Sajeevanveeriah/Ataxia-Monitor/VW-MTC1/Hardware/Reports/20261019-VW-MTC1-DRC-Report-Rev00.txt

** Drc report for VW-MTC1.kicad_pcb **
** Created on 2026-10-19T11:32:42 **
** Report includes: Errors, Warnings, Exclusions **

** Found 219 DRC violations **
[via_dangling]: Via is not connected or connected on only one layer
    Local override; warning
    @(147.0000 mm, 103.0000 mm): Via [GND] on F.Cu - B.Cu
[isolated_copper]: Isolated copper fill
    Local override; warning
    @(100.3000 mm, 100.3000 mm): Zone 'GND_POUR_TOP' [GND] on F.Cu, priority 0
[isolated_copper]: Isolated copper fill
    Local override; warning
    @(100.3000 mm, 100.3000 mm): Zone 'GND_POUR_TOP' [GND] on F.Cu, priority 0
[isolated_copper]: Isolated copper fill
    Local override; warning
    @(100.3000 mm, 100.3000 mm): Zone 'GND_POUR_TOP' [GND] on F.Cu, priority 0
[isolated_copper]: Isolated copper fill
    Local override; warning
    @(100.3000 mm, 100.3000 mm): Zone 'GND_POUR_TOP' [GND] on F.Cu, priority 0
[isolated_copper]: Isolated copper fill
    Local override; warning
    @(100.3000 mm, 100.3000 mm): Zone 'GND_POUR_BOT' [GND] on B.Cu, priority 0
[silk_edge_clearance]: Silkscreen clipped by board edge
    Rule: board setup constraints silk; warning
    @(188.0000 mm, 160.0000 mm): Segment on Edge.Cuts
    @(127.6000 mm, 159.8200 mm): Segment of SW1 on F.Silkscreen
[silk_edge_clearance]: Silkscreen clipped by board edge
    Rule: board setup constraints silk; warning
    @(188.0000 mm, 160.0000 mm): Segment on Edge.Cuts
    @(127.8000 mm, 160.0300 mm): Segment of SW1 on F.Silkscreen
[silk_edge_clearance]: Silkscreen clipped by board edge
    Rule: board setup constraints silk; warning
    @(188.0000 mm, 160.0000 mm): Segment on Edge.Cuts
    @(128.9000 mm, 159.8200 mm): Segment of SW1 on F.Silkscreen
[silk_edge_clearance]: Silkscreen clipped by board edge
    Rule: board setup constraints silk; warning
    @(100.0000 mm, 158.0000 mm): Segment on Edge.Cuts
    @(100.0000 mm, 124.2000 mm): Reference field of U5
[silk_edge_clearance]: Silkscreen clipped by board edge
    Rule: board setup constraints silk; warning
    @(102.0000 mm, 102.0000 mm): Arc on Edge.Cuts
    @(101.3000 mm, 99.9000 mm): Segment of U5 on F.Silkscreen
[silk_edge_clearance]: Silkscreen clipped by board edge
    Rule: board setup constraints silk; warning
    @(102.0000 mm, 100.0000 mm): Segment on Edge.Cuts
    @(119.7000 mm, 99.9000 mm): Segment of U5 on F.Silkscreen
[silk_edge_clearance]: Silkscreen clipped by board edge
    Rule: board setup constraints silk; warning
    @(102.0000 mm, 100.0000 mm): Segment on Edge.Cuts
    @(139.0000 mm, 100.3500 mm): Reference field of H4
[silk_edge_clearance]: Silkscreen clipped by board edge
    Rule: board setup constraints silk; warning
    @(102.0000 mm, 100.0000 mm): Segment on Edge.Cuts
    @(186.0000 mm, 99.8500 mm): Reference field of H3
[holes_co_located]: Drilled holes co-located
    Local override; warning
    @(147.0000 mm, 103.0000 mm): PTH pad 1 [GND] of J5
    @(147.0000 mm, 103.0000 mm): Via [GND] on F.Cu - B.Cu
[hole_to_hole]: Drilled hole too close to other hole (board setup constraints min 0.2500 mm; actual 0.0000 mm)
    Rule: board setup constraints; warning
    @(108.3300 mm, 136.1500 mm): Via [VBUS_RAW] on F.Cu - B.Cu
    @(108.4100 mm, 136.4000 mm): Via [VBUS_RAW] on F.Cu - B.Cu
[holes_co_located]: Drilled holes co-located
    Local override; warning
    @(147.0000 mm, 103.0000 mm): PTH pad 1 [GND] of J5
    @(147.0000 mm, 103.0000 mm): Via [GND] on F.Cu - B.Cu
[silk_overlap]: Silkscreen clearance
    Rule: board setup constraints silk; warning
    @(180.5200 mm, 106.3000 mm): Reference field of U9
    @(180.2627 mm, 106.5225 mm): Segment of R48 on F.Silkscreen
[silk_overlap]: Silkscreen clearance
    Rule: board setup constraints silk; warning
    @(177.3900 mm, 101.7500 mm): Segment of D7 on F.Silkscreen
    @(176.7500 mm, 103.8200 mm): Reference field of C30
[silk_overlap]: Silkscreen clearance
    Rule: board setup constraints silk; warning
    @(176.7500 mm, 103.8200 mm): Reference field of C30
    @(177.3900 mm, 103.7500 mm): Segment of D7 on F.Silkscreen
[silk_overlap]: Silkscreen clearance
    Rule: board setup constraints silk; warning
    @(178.0127 mm, 112.7725 mm): Segment of R45 on F.Silkscreen
    @(178.7500 mm, 112.8200 mm): Reference field of R35
[silk_overlap]: Silkscreen clearance
    Rule: board setup constraints silk; warning
    @(176.0000 mm, 108.3200 mm): Reference field of C28
    @(174.5127 mm, 108.2725 mm): Segment of R46 on F.Silkscreen
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
[silk_overlap]: Silkscreen clearance
    Rule: board setup constraints silk; warning
    @(150.5100 mm, 140.1406 mm): Segment of C18 on F.Silkscreen
    @(150.5700 mm, 140.0000 mm): Reference field of R27
[silk_overlap]: Silkscreen clearance
    Rule: board setup constraints silk; warning
    @(141.5000 mm, 110.2500 mm): Reference field of SW4
    @(138.2650 mm, 110.4850 mm): Segment of D4 on F.Silkscreen
[silk_overlap]: Silkscreen clearance
    Rule: board setup constraints silk; warning
    @(132.5225 mm, 112.2373 mm): Segment of R21 on F.Silkscreen
    @(132.5700 mm, 112.2500 mm): Reference field of D5
[silk_overlap]: Silkscreen clearance
    Rule: board setup constraints silk; warning
    @(134.5700 mm, 113.0000 mm): Reference field of R19
    @(134.7350 mm, 113.7350 mm): Segment of D5 on F.Silkscreen
[silk_overlap]: Silkscreen clearance
    Rule: board setup constraints silk; warning
    @(134.5700 mm, 113.0000 mm): Reference field of R19
    @(133.2650 mm, 113.7350 mm): Segment of D5 on F.Silkscreen
[silk_overlap]: Silkscreen clearance
    Rule: board setup constraints silk; warning
    @(135.2500 mm, 114.3200 mm): Reference field of D6
    @(134.5700 mm, 113.0000 mm): Reference field of R19
[silk_overlap]: Silkscreen clearance
    Rule: board setup constraints silk; warning
    @(135.2500 mm, 116.3200 mm): Reference field of R22
    @(133.7650 mm, 116.4850 mm): Segment of D6 on F.Silkscreen
[silk_overlap]: Silkscreen clearance
    Rule: board setup constraints silk; warning
    @(160.5127 mm, 112.5225 mm): Segment of R37 on F.Silkscreen
    @(160.2500 mm, 112.5700 mm): Reference field of C19
[silk_overlap]: Silkscreen clearance
    Rule: board setup constraints silk; warning
    @(160.5000 mm, 109.5000 mm): Circle of TP8 on F.Silkscreen
    @(160.7500 mm, 110.5700 mm): Reference field of R37
[silk_overlap]: Silkscreen clearance
    Rule: board setup constraints silk; warning
    @(163.7387 mm, 110.4850 mm): Segment of C20 on F.Silkscreen
    @(164.2500 mm, 110.5700 mm): Reference field of FB1
[silk_overlap]: Silkscreen clearance
    Rule: board setup constraints silk; warning
    @(168.4887 mm, 106.7350 mm): Segment of C23 on F.Silkscreen
    @(167.7500 mm, 107.0700 mm): Reference field of C22
[silk_overlap]: Silkscreen clearance
    Rule: board setup constraints silk; warning
    @(162.5000 mm, 107.3800 mm): Reference field of J6
    @(164.0000 mm, 108.0700 mm): Reference field of C20
[silk_over_copper]: Silkscreen clipped by solder mask
    Local override; warning
    @(180.5200 mm, 106.3000 mm): Reference field of U9
    @(179.6750 mm, 106.0000 mm): Pad 1 [+3V3_H] of R48 on F.Cu
[silk_over_copper]: Silkscreen clipped by solder mask
    Local override; warning
    @(180.5200 mm, 106.3000 mm): Reference field of U9
    @(181.3250 mm, 106.0000 mm): Pad 2 [SCL_H] of R48 on F.Cu
[silk_over_copper]: Silkscreen clipped by solder mask
    Local override; warning
    @(176.7500 mm, 103.8200 mm): Reference field of C30
    @(176.1875 mm, 103.0000 mm): Pad 2 [MOT_P] of F2 on F.Cu
[silk_over_copper]: Silkscreen clipped by solder mask
    Local override; warning
    @(174.7500 mm, 106.3200 mm): Reference field of R46
    @(175.8000 mm, 105.5000 mm): Pad 1 [HALL_SK4] of C30 on F.Cu
[silk_over_copper]: Silkscreen clipped by solder mask
    Local override; warning
    @(178.7500 mm, 112.8200 mm): Reference field of R35
    @(177.4250 mm, 112.2500 mm): Pad 1 [HALL_IN4] of R45 on F.Cu
[silk_over_copper]: Silkscreen clipped by solder mask
    Local override; warning
    @(178.7500 mm, 112.8200 mm): Reference field of R35
    @(179.0750 mm, 112.2500 mm): Pad 2 [HALL_MID4] of R45 on F.Cu
[silk_over_copper]: Silkscreen clipped by solder mask
    Local override; warning
    @(173.5700 mm, 113.2500 mm): Reference field of C24
    @(172.4750 mm, 114.5000 mm): Pad 11 [GND] of U6 on F.Cu
[silk_over_copper]: Silkscreen clipped by solder mask
    Local override; warning
    @(173.5700 mm, 113.2500 mm): Reference field of C24
    @(172.4750 mm, 113.2300 mm): Pad 12 [HALL_SK4] of U6 on F.Cu
[silk_over_copper]: Silkscreen clipped by solder mask
    Local override; warning
    @(173.5700 mm, 117.0000 mm): Reference field of R42
    @(172.4750 mm, 115.7700 mm): Pad 10 [HALL_SK3] of U6 on F.Cu
[silk_over_copper]: Silkscreen clipped by solder mask
    Local override; warning
    @(176.0000 mm, 108.3200 mm): Reference field of C28
    @(175.5750 mm, 107.7500 mm): Pad 2 [HALL_SK4] of R46 on F.Cu
[silk_over_copper]: Silkscreen clipped by solder mask
    Local override; warning
    @(174.7500 mm, 106.3200 mm): Reference field of R46
    @(173.7000 mm, 105.5000 mm): Pad 2 [HALL_F4] of C29 on F.Cu
[silk_over_copper]: Silkscreen clipped by solder mask
    Local override; warning
    @(178.2500 mm, 110.8200 mm): Reference field of R45
    @(176.9500 mm, 110.0000 mm): Pad 2 [GND] of C28 on F.Cu
[silk_over_copper]: Silkscreen clipped by solder mask
    Local override; warning
    @(180.0700 mm, 112.7500 mm): Reference field of R47
    @(179.5750 mm, 114.2500 mm): Pad 2 [GND] of R35 on F.Cu
[silk_over_copper]: Silkscreen clipped by solder mask
    Local override; warning
    @(179.8183 mm, 114.5000 mm): Reference field of U8
    @(179.5750 mm, 114.2500 mm): Pad 2 [GND] of R35 on F.Cu
[silk_over_copper]: Silkscreen clipped by solder mask
    Local override; warning
    @(173.5700 mm, 125.7500 mm): Reference field of C31
    @(172.4750 mm, 126.9600 mm): Pad 13 [+3V3_H] of U7 on F.Cu
[silk_over_copper]: Silkscreen clipped by solder mask
    Local override; warning
    @(173.5700 mm, 125.7500 mm): Reference field of C31
    @(172.4750 mm, 125.6900 mm): Pad 14 [+3V3] of U7 on F.Cu
[silk_over_copper]: Silkscreen clipped by solder mask
    Local override; warning
    @(181.0000 mm, 126.8200 mm): Reference field of R50
    @(179.8000 mm, 125.9375 mm): Pad 1 [HAPTIC_G] of Q3 on F.Cu
[silk_over_copper]: Silkscreen clipped by solder mask
    Local override; warning
    @(172.2500 mm, 119.0700 mm): Reference field of R40
    @(172.4750 mm, 118.3100 mm): Pad 8 [HALL_F3] of U6 on F.Cu
[silk_over_copper]: Silkscreen clipped by solder mask
    Local override; warning
    @(173.5000 mm, 121.0700 mm): Reference field of C27
    @(173.0750 mm, 120.5000 mm): Pad 2 [HALL_SK2] of R40 on F.Cu
[silk_over_copper]: Silkscreen clipped by solder mask
    Local override; warning
    @(186.7500 mm, 125.3200 mm): Reference field of C33
    @(187.5500 mm, 124.4750 mm): Pad MP [GND] of J3 on F.Cu
[silk_over_copper]: Silkscreen clipped by solder mask
    Local override; warning
    @(181.0000 mm, 126.8200 mm): Reference field of R50
    @(181.7000 mm, 125.9375 mm): Pad 2 [GND] of Q3 on F.Cu
[silk_over_copper]: Silkscreen clipped by solder mask
    Local override; warning
    @(175.7500 mm, 127.0700 mm): Reference field of C32
    @(175.0000 mm, 126.5250 mm): Pad 1 [+3V3] of C31 on F.Cu
[silk_over_copper]: Silkscreen clipped by solder mask
    Local override; warning
    @(178.3500 mm, 125.0000 mm): Reference field of Q3
    @(177.7500 mm, 124.9250 mm): Pad 2 [HAPTIC_G] of R49 on F.Cu
[silk_over_copper]: Silkscreen clipped by solder mask
    Local override; warning
    @(175.7500 mm, 118.5700 mm): Reference field of R43
    @(175.0000 mm, 117.8250 mm): Pad 1 [HALL_IN3] of R42 on F.Cu
[silk_over_copper]: Silkscreen clipped by solder mask
    Local override; warning
    @(173.5700 mm, 117.0000 mm): Reference field of R42
    @(172.4750 mm, 118.3100 mm): Pad 8 [HALL_F3] of U6 on F.Cu
[silk_over_copper]: Silkscreen clipped by solder mask
    Local override; warning
    @(173.5700 mm, 117.0000 mm): Reference field of R42
    @(172.4750 mm, 117.0400 mm): Pad 9 [HALL_F3] of U6 on F.Cu
[silk_over_copper]: Silkscreen clipped by solder mask
    Local override; warning
    @(180.5000 mm, 118.3200 mm): Reference field of R41
    @(179.4150 mm, 118.0000 mm): Pad 5 [HALL_IN4] of U8 on F.Cu
[silk_over_copper]: Silkscreen clipped by solder mask
    Local override; warning
    @(180.5000 mm, 118.3200 mm): Reference field of R41
    @(180.1850 mm, 118.0000 mm): Pad 6 [unconnected-(U8-NC-Pad6)] of U8 on F.Cu
[silk_over_copper]: Silkscreen clipped by solder mask
    Local override; warning
    @(180.2500 mm, 120.3200 mm): Reference field of R44
    @(179.6750 mm, 119.7500 mm): Pad 1 [HALL_IN3] of R41 on F.Cu
[silk_over_copper]: Silkscreen clipped by solder mask
    Local override; warning
    @(180.2500 mm, 120.3200 mm): Reference field of R44
    @(181.3250 mm, 119.7500 mm): Pad 2 [GND] of R41 on F.Cu
[silk_over_copper]: Silkscreen clipped by solder mask
    Local override; warning
    @(116.0000 mm, 126.3520 mm): Reference field of TP1
    @(114.9450 mm, 125.3000 mm): Pad 24 [LED_GRN] of U5 on F.Cu
[silk_over_copper]: Silkscreen clipped by solder mask
    Local override; warning
    @(116.0000 mm, 126.3520 mm): Reference field of TP1
    @(116.2150 mm, 125.3000 mm): Pad 25 [LED_RED] of U5 on F.Cu
[silk_over_copper]: Silkscreen clipped by solder mask
    Local override; warning
    @(120.0700 mm, 112.5000 mm): Reference field of R17
    @(119.2500 mm, 113.8900 mm): Pad 35 [TOUCH_START] of U5 on F.Cu
[silk_over_copper]: Silkscreen clipped by solder mask
    Local override; warning
    @(120.0700 mm, 112.5000 mm): Reference field of R17
    @(119.2500 mm, 112.6200 mm): Pad 36 [CHRG_N] of U5 on F.Cu
[silk_over_copper]: Silkscreen clipped by solder mask
    Local override; warning
    @(120.0700 mm, 112.5000 mm): Reference field of R17
    @(119.2500 mm, 111.3500 mm): Pad 37 [LED_AMB] of U5 on F.Cu
[silk_over_copper]: Silkscreen clipped by solder mask
    Local override; warning
    @(124.0000 mm, 112.6020 mm): Reference field of TP6
    @(123.4250 mm, 111.7500 mm): Pad 1 [VBAT_SENSE] of R24 on F.Cu
[silk_over_copper]: Silkscreen clipped by solder mask
    Local override; warning
    @(120.0700 mm, 116.0000 mm): Reference field of C13
    @(119.2500 mm, 116.4300 mm): Pad 33 [SD_D0] of U5 on F.Cu
[silk_over_copper]: Silkscreen clipped by solder mask
    Local override; warning
    @(120.0700 mm, 116.0000 mm): Reference field of C13
    @(119.2500 mm, 115.1600 mm): Pad 34 [TOUCH_WIRE] of U5 on F.Cu
[silk_over_copper]: Silkscreen clipped by solder mask
    Local override; warning
    @(124.0000 mm, 112.6020 mm): Reference field of TP6
    @(125.0750 mm, 111.7500 mm): Pad 2 [GND] of R24 on F.Cu
[silk_over_copper]: Silkscreen clipped by solder mask
    Local override; warning
    @(118.2500 mm, 137.5700 mm): Reference field of R8
    @(117.3625 mm, 136.9500 mm): Pad 2 [VSYS] of Q1 on F.Cu
[silk_over_copper]: Silkscreen clipped by solder mask
    Local override; warning
    @(122.3200 mm, 136.7500 mm): Reference field of R15
    @(121.5000 mm, 135.8250 mm): Pad 1 [VBUS_SENSE] of R9 on F.Cu
[silk_over_copper]: Silkscreen clipped by solder mask
    Local override; warning
    @(130.7500 mm, 133.0700 mm): Reference field of R12
    @(130.4750 mm, 132.5000 mm): Pad 1 [BB_FB] of C10 on F.Cu
[silk_over_copper]: Silkscreen clipped by solder mask
    Local override; warning
    @(130.7500 mm, 133.0700 mm): Reference field of R12
    @(132.0250 mm, 132.5000 mm): Pad 2 [BB_CMP] of C10 on F.Cu
[silk_over_copper]: Silkscreen clipped by solder mask
    Local override; warning
    @(126.5700 mm, 135.7500 mm): Reference field of R11
    @(125.7500 mm, 136.5250 mm): Pad 1 [BB_FF] of C9 on F.Cu
[silk_over_copper]: Silkscreen clipped by solder mask
    Local override; warning
    @(124.3200 mm, 135.7500 mm): Reference field of C9
    @(123.7500 mm, 135.9250 mm): Pad 2 [GND] of R15 on F.Cu
[silk_over_copper]: Silkscreen clipped by solder mask
    Local override; warning
    @(126.5700 mm, 135.7500 mm): Reference field of R11
    @(125.7500 mm, 134.9750 mm): Pad 2 [BB_FB] of C9 on F.Cu
[silk_over_copper]: Silkscreen clipped by solder mask
    Local override; warning
    @(130.7500 mm, 135.0700 mm): Reference field of C5
    @(131.5750 mm, 134.5000 mm): Pad 2 [GND] of R12 on F.Cu
[silk_over_copper]: Silkscreen clipped by solder mask
    Local override; warning
    @(130.7500 mm, 135.0700 mm): Reference field of C5
    @(129.9250 mm, 134.5000 mm): Pad 1 [BB_FB] of R12 on F.Cu
[silk_over_copper]: Silkscreen clipped by solder mask
    Local override; warning
    @(132.0700 mm, 141.0000 mm): Reference field of C4
    @(131.1500 mm, 141.6250 mm): Pad 7 [+3V3] of U4 on F.Cu
[silk_over_copper]: Silkscreen clipped by solder mask
    Local override; warning
    @(126.2000 mm, 141.0000 mm): Reference field of L1
    @(126.8500 mm, 140.3250 mm): Pad 4 [BB_SW1] of U4 on F.Cu
[silk_over_copper]: Silkscreen clipped by solder mask
    Local override; warning
    @(126.2000 mm, 141.0000 mm): Reference field of L1
    @(126.8500 mm, 140.9750 mm): Pad 5 [GND] of U4 on F.Cu
[silk_over_copper]: Silkscreen clipped by solder mask
    Local override; warning
    @(132.0700 mm, 141.0000 mm): Reference field of C4
    @(131.1500 mm, 140.9750 mm): Pad 8 [VSYS] of U4 on F.Cu
[silk_over_copper]: Silkscreen clipped by solder mask
    Local override; warning
    @(134.5700 mm, 141.2500 mm): Reference field of C8
    @(133.7500 mm, 141.9500 mm): Pad 1 [VSYS] of C4 on F.Cu
[silk_over_copper]: Silkscreen clipped by solder mask
    Local override; warning
    @(122.5700 mm, 108.7500 mm): Reference field of R23
    @(121.7500 mm, 107.8000 mm): Pad 2 [GND] of C11 on F.Cu
[silk_over_copper]: Silkscreen clipped by solder mask
    Local override; warning
    @(124.5700 mm, 108.7500 mm): Reference field of C14
    @(124.0000 mm, 109.5750 mm): Pad 1 [VBAT] of R23 on F.Cu
[silk_over_copper]: Silkscreen clipped by solder mask
    Local override; warning
    @(124.5700 mm, 108.7500 mm): Reference field of C14
    @(124.0000 mm, 107.9250 mm): Pad 2 [VBAT_SENSE] of R23 on F.Cu
[silk_over_copper]: Silkscreen clipped by solder mask
    Local override; warning
    @(122.5700 mm, 108.7500 mm): Reference field of R23
    @(121.7500 mm, 109.7000 mm): Pad 1 [+3V3] of C11 on F.Cu
[silk_over_copper]: Silkscreen clipped by solder mask
    Local override; warning
    @(124.2500 mm, 110.3200 mm): Reference field of R24
    @(124.0000 mm, 109.5750 mm): Pad 1 [VBAT] of R23 on F.Cu
[silk_over_copper]: Silkscreen clipped by solder mask
    Local override; warning
    @(120.0700 mm, 108.7500 mm): Reference field of C11
    @(119.2500 mm, 110.0800 mm): Pad 38 [VBUS_SENSE] of U5 on F.Cu
[silk_over_copper]: Silkscreen clipped by solder mask
    Local override; warning
    @(120.0700 mm, 108.7500 mm): Reference field of C11
    @(119.2500 mm, 108.8100 mm): Pad 39 [VBAT_SENSE] of U5 on F.Cu
[silk_over_copper]: Silkscreen clipped by solder mask
    Local override; warning
    @(120.0700 mm, 108.7500 mm): Reference field of C11
    @(119.2500 mm, 107.5400 mm): Pad 40 [GND] of U5 on F.Cu
[silk_over_copper]: Silkscreen clipped by solder mask
    Local override; warning
    @(168.7500 mm, 119.0700 mm): Reference field of C21
    @(167.5250 mm, 118.3100 mm): Pad 7 [HALL_F2] of U6 on F.Cu
[silk_over_copper]: Silkscreen clipped by solder mask
    Local override; warning
    @(165.2500 mm, 119.0700 mm): Reference field of R39
    @(165.0750 mm, 118.5000 mm): Pad 2 [HALL_GATE] of R34 on F.Cu
[silk_over_copper]: Silkscreen clipped by solder mask
    Local override; warning
    @(164.5000 mm, 121.0700 mm): Reference field of C26
    @(164.4250 mm, 120.5000 mm): Pad 1 [HALL_IN2] of R39 on F.Cu
[silk_over_copper]: Silkscreen clipped by solder mask
    Local override; warning
    @(172.5000 mm, 137.0700 mm): Reference field of R54
    @(172.2750 mm, 136.5000 mm): Pad 2 [GND] of C37 on F.Cu
[silk_over_copper]: Silkscreen clipped by solder mask
    Local override; warning
    @(174.2500 mm, 142.5700 mm): Reference field of C35
    @(174.5000 mm, 142.0750 mm): Pad 1 [MAZE_START] of R53 on F.Cu
[silk_over_copper]: Silkscreen clipped by solder mask
    Local override; warning
    @(167.0000 mm, 142.5700 mm): Reference field of R55
    @(167.5000 mm, 142.0750 mm): Pad 1 [+3V3] of R52 on F.Cu
[silk_over_copper]: Silkscreen clipped by solder mask
    Local override; warning
    @(167.0000 mm, 142.5700 mm): Reference field of R55
    @(165.5000 mm, 142.0750 mm): Pad 1 [+3V3] of R56 on F.Cu
[silk_over_copper]: Silkscreen clipped by solder mask
    Local override; warning
    @(166.0700 mm, 141.2500 mm): Reference field of R52
    @(165.5000 mm, 142.0750 mm): Pad 1 [+3V3] of R56 on F.Cu
[silk_over_copper]: Silkscreen clipped by solder mask
    Local override; warning
    @(166.0700 mm, 141.2500 mm): Reference field of R52
    @(165.5000 mm, 140.4250 mm): Pad 2 [TCH_FIN] of R56 on F.Cu
[silk_over_copper]: Silkscreen clipped by solder mask
    Local override; warning
    @(170.5000 mm, 144.0700 mm): Reference field of C36
    @(169.7250 mm, 143.5000 mm): Pad 1 [TCH_WIRE] of C34 on F.Cu
[silk_over_copper]: Silkscreen clipped by solder mask
    Local override; warning
    @(170.5000 mm, 144.0700 mm): Reference field of C36
    @(171.2750 mm, 143.5000 mm): Pad 2 [GND] of C34 on F.Cu
[silk_over_copper]: Silkscreen clipped by solder mask
    Local override; warning
    @(173.0700 mm, 141.2500 mm): Reference field of R53
    @(172.4000 mm, 140.2500 mm): Pad 8 [+3V3] of U11 on F.Cu
[silk_over_copper]: Silkscreen clipped by solder mask
    Local override; warning
    @(173.0700 mm, 141.2500 mm): Reference field of R53
    @(172.4000 mm, 141.7500 mm): Pad 5 [TOUCH_FINISH] of U11 on F.Cu
[silk_over_copper]: Silkscreen clipped by solder mask
    Local override; warning
    @(173.0700 mm, 141.2500 mm): Reference field of R53
    @(172.4000 mm, 141.2500 mm): Pad 6 [TCH_START] of U11 on F.Cu
[silk_over_copper]: Silkscreen clipped by solder mask
    Local override; warning
    @(173.0700 mm, 141.2500 mm): Reference field of R53
    @(172.4000 mm, 140.7500 mm): Pad 7 [TOUCH_WIRE] of U11 on F.Cu
[silk_over_copper]: Silkscreen clipped by solder mask
    Local override; warning
    @(171.0000 mm, 139.0500 mm): Reference field of U11
    @(169.8250 mm, 138.5000 mm): Pad 2 [TCH_WIRE] of R51 on F.Cu
[silk_over_copper]: Silkscreen clipped by solder mask
    Local override; warning
    @(171.0000 mm, 139.0500 mm): Reference field of U11
    @(171.6750 mm, 138.5000 mm): Pad 1 [+3V3] of R54 on F.Cu
[silk_over_copper]: Silkscreen clipped by solder mask
    Local override; warning
    @(170.5000 mm, 142.0700 mm): Reference field of C34
    @(169.6000 mm, 141.7500 mm): Pad 4 [GND] of U11 on F.Cu
[silk_over_copper]: Silkscreen clipped by solder mask
    Local override; warning
    @(134.2500 mm, 145.3520 mm): Reference field of TP2
    @(133.5500 mm, 144.2500 mm): Pad 1 [+3V3] of C6 on F.Cu
[silk_over_copper]: Silkscreen clipped by solder mask
    Local override; warning
    @(134.2500 mm, 145.3520 mm): Reference field of TP2
    @(135.4500 mm, 144.2500 mm): Pad 2 [GND] of C6 on F.Cu
[silk_over_copper]: Silkscreen clipped by solder mask
    Local override; warning
    @(132.0700 mm, 141.0000 mm): Reference field of C4
    @(131.1500 mm, 140.3250 mm): Pad 9 [VSYS] of U4 on F.Cu
[silk_over_copper]: Silkscreen clipped by solder mask
    Local override; warning
    @(130.0000 mm, 142.1500 mm): Reference field of C39
    @(131.1500 mm, 141.6250 mm): Pad 7 [+3V3] of U4 on F.Cu
[silk_over_copper]: Silkscreen clipped by solder mask
    Local override; warning
    @(134.5000 mm, 142.5700 mm): Reference field of C6
    @(133.7500 mm, 141.9500 mm): Pad 1 [VSYS] of C4 on F.Cu
[silk_over_copper]: Silkscreen clipped by solder mask
    Local override; warning
    @(120.8200 mm, 146.0000 mm): Reference field of C2
    @(120.1375 mm, 145.9500 mm): Pad 4 [VBUS] of U3 on F.Cu
[silk_over_copper]: Silkscreen clipped by solder mask
    Local override; warning
    @(114.3200 mm, 142.5000 mm): Reference field of D2
    @(113.7500 mm, 143.4250 mm): Pad 2 [LED_CHG_A] of R6 on F.Cu
[silk_over_copper]: Silkscreen clipped by solder mask
    Local override; warning
    @(119.0000 mm, 142.6000 mm): Reference field of U3
    @(119.3250 mm, 142.0000 mm): Pad 2 [GND] of R4 on F.Cu
[silk_over_copper]: Silkscreen clipped by solder mask
    Local override; warning
    @(114.3200 mm, 146.0000 mm): Reference field of R5
    @(113.7500 mm, 145.0750 mm): Pad 1 [+3V3] of R6 on F.Cu
[silk_over_copper]: Silkscreen clipped by solder mask
    Local override; warning
    @(126.2000 mm, 141.0000 mm): Reference field of L1
    @(126.8500 mm, 141.6250 mm): Pad 6 [BB_SW2] of U4 on F.Cu
[silk_over_copper]: Silkscreen clipped by solder mask
    Local override; warning
    @(125.7500 mm, 143.0700 mm): Reference field of R16
    @(123.2000 mm, 142.1850 mm): Pad 2 [BB_SW2] of L1 on F.Cu
[silk_over_copper]: Silkscreen clipped by solder mask
    Local override; warning
    @(122.8200 mm, 147.2500 mm): Reference field of R3
    @(122.2500 mm, 146.7750 mm): Pad 1 [VBUS] of C2 on F.Cu
[silk_over_copper]: Silkscreen clipped by solder mask
    Local override; warning
    @(129.0000 mm, 153.6000 mm): Reference field of SW1
    @(128.9250 mm, 153.0000 mm): Pad 1 [EN_3V3] of R10 on F.Cu
[silk_over_copper]: Silkscreen clipped by solder mask
    Local override; warning
    @(121.0000 mm, 149.8200 mm): Reference field of C1
    @(120.0500 mm, 149.0000 mm): Pad 1 [VBAT_C] of C3 on F.Cu
[silk_over_copper]: Silkscreen clipped by solder mask
    Local override; warning
    @(121.0000 mm, 149.8200 mm): Reference field of C1
    @(121.9500 mm, 149.0000 mm): Pad 2 [GND] of C3 on F.Cu
[silk_over_copper]: Silkscreen clipped by solder mask
    Local override; warning
    @(152.5700 mm, 140.0000 mm): Reference field of R30
    @(152.0000 mm, 140.8250 mm): Pad 1 [+3V3] of R27 on F.Cu
[silk_over_copper]: Silkscreen clipped by solder mask
    Local override; warning
    @(150.5700 mm, 140.0000 mm): Reference field of R27
    @(150.0000 mm, 140.7750 mm): Pad 1 [+3V3] of C18 on F.Cu
[silk_over_copper]: Silkscreen clipped by solder mask
    Local override; warning
    @(152.5700 mm, 140.0000 mm): Reference field of R30
    @(152.0000 mm, 139.1750 mm): Pad 2 [SD_CMD] of R27 on F.Cu
[silk_over_copper]: Silkscreen clipped by solder mask
    Local override; warning
    @(106.0000 mm, 139.0700 mm): Reference field of R2
    @(106.8050 mm, 138.3200 mm): PTH pad SH [GND] of J1
[silk_over_copper]: Silkscreen clipped by solder mask
    Local override; warning
    @(111.0000 mm, 131.5000 mm): Reference field of D1
    @(110.2500 mm, 130.9000 mm): Pad 1 [VBUS_RAW] of F1 on F.Cu
[silk_over_copper]: Silkscreen clipped by solder mask
    Local override; warning
    @(129.0000 mm, 137.0300 mm): Reference field of U4
    @(128.0000 mm, 136.5750 mm): Pad 1 [+3V3] of R11 on F.Cu
[silk_over_copper]: Silkscreen clipped by solder mask
    Local override; warning
    @(129.0000 mm, 137.0300 mm): Reference field of U4
    @(129.9750 mm, 136.5000 mm): Pad 1 [VSYS] of C5 on F.Cu
[silk_over_copper]: Silkscreen clipped by solder mask
    Local override; warning
    @(104.2500 mm, 126.0700 mm): Reference field of C12
    @(103.5150 mm, 125.3000 mm): Pad 15 [BTN_START] of U5 on F.Cu
[silk_over_copper]: Silkscreen clipped by solder mask
    Local override; warning
    @(104.2500 mm, 126.0700 mm): Reference field of C12
    @(104.7850 mm, 125.3000 mm): Pad 16 [HAPTIC_PWM] of U5 on F.Cu
[silk_over_copper]: Silkscreen clipped by solder mask
    Local override; warning
    @(145.0000 mm, 127.8000 mm): Reference field of U12
    @(145.0750 mm, 127.2500 mm): Pad 2 [SDA] of R25 on F.Cu
[silk_over_copper]: Silkscreen clipped by solder mask
    Local override; warning
    @(146.5700 mm, 129.0000 mm): Reference field of R26
    @(146.1625 mm, 129.7500 mm): Pad 10 [unconnected-(U12-OCS_AUX-Pad10)] of U12 on F.Cu
[silk_over_copper]: Silkscreen clipped by solder mask
    Local override; warning
    @(146.5700 mm, 129.0000 mm): Reference field of R26
    @(146.1625 mm, 129.2500 mm): Pad 11 [unconnected-(U12-SDO_AUX-Pad11)] of U12 on F.Cu
[silk_over_copper]: Silkscreen clipped by solder mask
    Local override; warning
    @(146.7500 mm, 131.3200 mm): Reference field of C15
    @(146.1625 mm, 130.7500 mm): Pad 8 [+3V3] of U12 on F.Cu
[silk_over_copper]: Silkscreen clipped by solder mask
    Local override; warning
    @(134.2500 mm, 134.0700 mm): Reference field of R13
    @(133.9250 mm, 133.5000 mm): Pad 1 [BB_CMP] of R14 on F.Cu
[silk_over_copper]: Silkscreen clipped by solder mask
    Local override; warning
    @(134.2500 mm, 134.0700 mm): Reference field of R13
    @(135.5750 mm, 133.5000 mm): Pad 2 [BB_VC] of R14 on F.Cu
[silk_over_copper]: Silkscreen clipped by solder mask
    Local override; warning
    @(134.5000 mm, 136.0700 mm): Reference field of C7
    @(135.0750 mm, 135.5000 mm): Pad 2 [BB_FF] of R13 on F.Cu
[silk_over_copper]: Silkscreen clipped by solder mask
    Local override; warning
    @(148.5700 mm, 140.0000 mm): Reference field of C18
    @(147.9500 mm, 140.5000 mm): Pad 2 [GND] of C17 on F.Cu
[silk_over_copper]: Silkscreen clipped by solder mask
    Local override; warning
    @(147.9250 mm, 141.2750 mm): Reference field of J7
    @(147.9500 mm, 140.5000 mm): Pad 2 [GND] of C17 on F.Cu
[silk_over_copper]: Silkscreen clipped by solder mask
    Local override; warning
    @(147.0000 mm, 138.8200 mm): Reference field of C17
    @(146.1750 mm, 138.2500 mm): Pad 1 [+3V3] of R31 on F.Cu
[silk_over_copper]: Silkscreen clipped by solder mask
    Local override; warning
    @(147.0000 mm, 138.8200 mm): Reference field of C17
    @(147.8250 mm, 138.2500 mm): Pad 2 [SD_D3] of R31 on F.Cu
[silk_over_copper]: Silkscreen clipped by solder mask
    Local override; warning
    @(150.5700 mm, 140.0000 mm): Reference field of R27
    @(150.0000 mm, 139.2250 mm): Pad 2 [GND] of C18 on F.Cu
[silk_over_copper]: Silkscreen clipped by solder mask
    Local override; warning
    @(141.5000 mm, 110.2500 mm): Reference field of SW4
    @(140.5375 mm, 109.7500 mm): Pad 2 [LED_GRN_A] of D4 on F.Cu
[silk_over_copper]: Silkscreen clipped by solder mask
    Local override; warning
    @(141.5000 mm, 110.2500 mm): Reference field of SW4
    @(142.4250 mm, 109.7500 mm): Pad 1 [LED_GRN] of R20 on F.Cu
[silk_over_copper]: Silkscreen clipped by solder mask
    Local override; warning
    @(135.2500 mm, 114.3200 mm): Reference field of D6
    @(136.0000 mm, 113.8250 mm): Pad 1 [+3V3] of R19 on F.Cu
[silk_over_copper]: Silkscreen clipped by solder mask
    Local override; warning
    @(132.5700 mm, 112.2500 mm): Reference field of D5
    @(132.0000 mm, 112.8250 mm): Pad 1 [LED_RED] of R21 on F.Cu
[silk_over_copper]: Silkscreen clipped by solder mask
    Local override; warning
    @(134.5700 mm, 113.0000 mm): Reference field of R19
    @(134.0000 mm, 113.0375 mm): Pad 1 [GND] of D5 on F.Cu
[silk_over_copper]: Silkscreen clipped by solder mask
    Local override; warning
    @(135.2500 mm, 116.3200 mm): Reference field of R22
    @(134.4625 mm, 115.7500 mm): Pad 1 [GND] of D6 on F.Cu
[silk_over_copper]: Silkscreen clipped by solder mask
    Local override; warning
    @(135.2500 mm, 116.3200 mm): Reference field of R22
    @(136.0375 mm, 115.7500 mm): Pad 2 [LED_AMB_A] of D6 on F.Cu
[silk_over_copper]: Silkscreen clipped by solder mask
    Local override; warning
    @(160.2500 mm, 112.5700 mm): Reference field of C19
    @(159.9250 mm, 112.0000 mm): Pad 1 [HALL_MID1] of R37 on F.Cu
[silk_over_copper]: Silkscreen clipped by solder mask
    Local override; warning
    @(161.6000 mm, 115.2500 mm): Reference field of Q2
    @(161.0000 mm, 115.9250 mm): Pad 2 [HALL_GATE] of R33 on F.Cu
[silk_over_copper]: Silkscreen clipped by solder mask
    Local override; warning
    @(160.2500 mm, 112.5700 mm): Reference field of C19
    @(161.5750 mm, 112.0000 mm): Pad 2 [HALL_SK1] of R37 on F.Cu
[silk_over_copper]: Silkscreen clipped by solder mask
    Local override; warning
    @(160.7500 mm, 110.5700 mm): Reference field of R37
    @(160.5000 mm, 109.5000 mm): Pad 1 [HALL_F1] of TP8 on F.Cu
[silk_over_copper]: Silkscreen clipped by solder mask
    Local override; warning
    @(164.2500 mm, 110.5700 mm): Reference field of FB1
    @(163.0500 mm, 109.7500 mm): Pad 1 [+3V3_H] of C20 on F.Cu
[silk_over_copper]: Silkscreen clipped by solder mask
    Local override; warning
    @(164.2500 mm, 110.5700 mm): Reference field of FB1
    @(164.9500 mm, 109.7500 mm): Pad 2 [GND] of C20 on F.Cu
[silk_over_copper]: Silkscreen clipped by solder mask
    Local override; warning
    @(167.7500 mm, 107.0700 mm): Reference field of C22
    @(167.8000 mm, 106.0000 mm): Pad 1 [HALL_MID1] of C23 on F.Cu
[silk_over_copper]: Silkscreen clipped by solder mask
    Local override; warning
    @(170.0000 mm, 109.2200 mm): Reference field of U6
    @(170.4250 mm, 108.5000 mm): Pad 1 [HALL_IN1] of R36 on F.Cu
[silk_over_copper]: Silkscreen clipped by solder mask
    Local override; warning
    @(161.0000 mm, 118.3520 mm): Reference field of TP7
    @(161.0000 mm, 117.5750 mm): Pad 1 [+3V3] of R33 on F.Cu
[silk_over_copper]: Silkscreen clipped by solder mask
    Local override; warning
    @(168.5000 mm, 121.0700 mm): Reference field of C25
    @(167.9750 mm, 120.5000 mm): Pad 1 [+3V3_H] of C21 on F.Cu
[silk_over_copper]: Silkscreen clipped by solder mask
    Local override; warning
    @(168.5000 mm, 121.0700 mm): Reference field of C25
    @(169.5250 mm, 120.5000 mm): Pad 2 [GND] of C21 on F.Cu
[silk_over_copper]: Silkscreen clipped by solder mask
    Local override; warning
    @(164.2500 mm, 117.0700 mm): Reference field of R34
    @(163.0500 mm, 116.1875 mm): Pad 1 [HALL_GATE] of Q2 on F.Cu
[silk_over_copper]: Silkscreen clipped by solder mask
    Local override; warning
    @(164.2500 mm, 117.0700 mm): Reference field of R34
    @(164.9500 mm, 116.1875 mm): Pad 2 [+3V3] of Q2 on F.Cu

** Found 0 unconnected pads **

** Found 0 Footprint errors **

** Ignored checks **
    - Footprint has no courtyard defined
    - Track endpoint not centered on via
    - Tuning profile track geometries
    - Footprint doesn't match symbol's footprint filters
    - Footprint component type doesn't match footprint pads

** End of Report **
