Sajeevanveeriah/Ataxia-Monitor/VW-MTC1/Docs/Images/layer_bottom.png

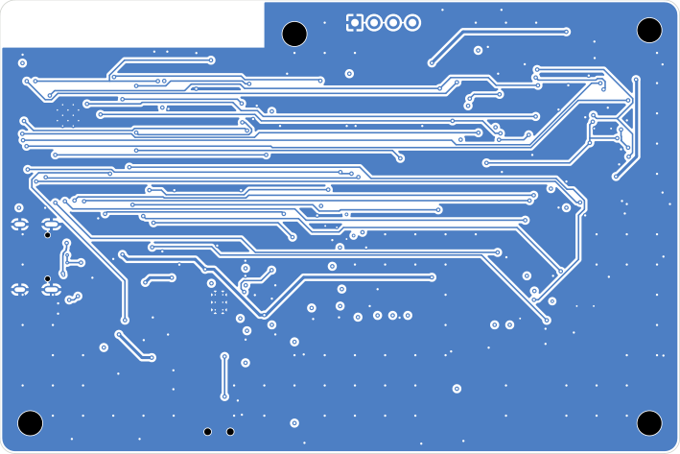
VW-MTC1/Docs/Images/layer_bottom.png
