Sajeevanveeriah/Ataxia-Monitor/VW-MTC1/Docs/Images/layer_in1.png

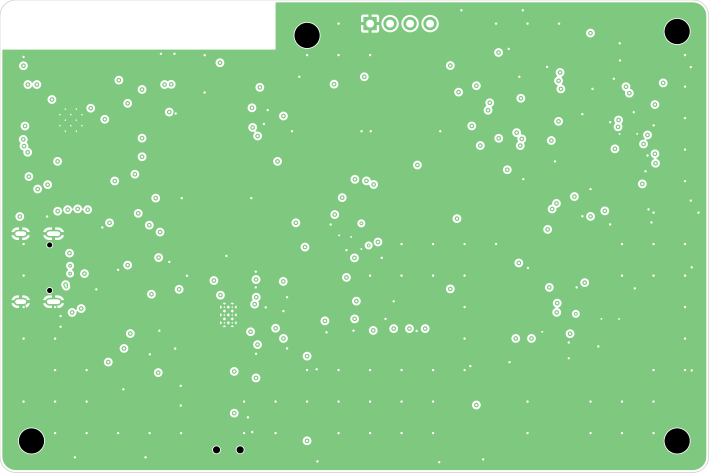
VW-MTC1/Docs/Images/layer_in1.png
