Sajeevanveeriah/Ataxia-Monitor/VW-MTC1/Docs/Images/layer_in2.png

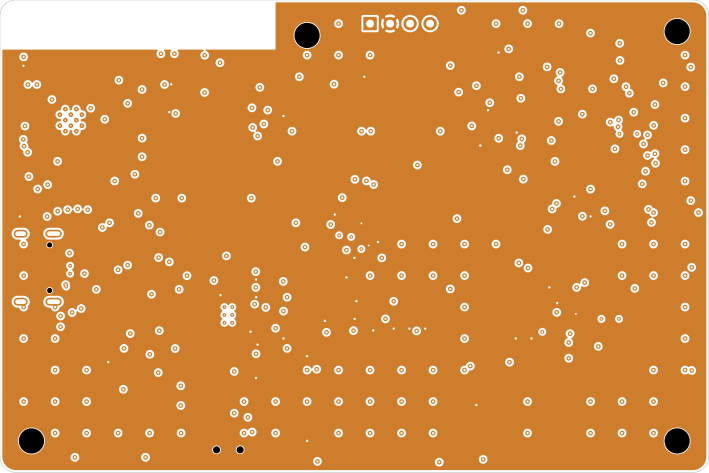
VW-MTC1/Docs/Images/layer_in2.png
