Sajeevanveeriah/Ataxia-Monitor/VW-MTC1/Docs/Images/layer_top.png

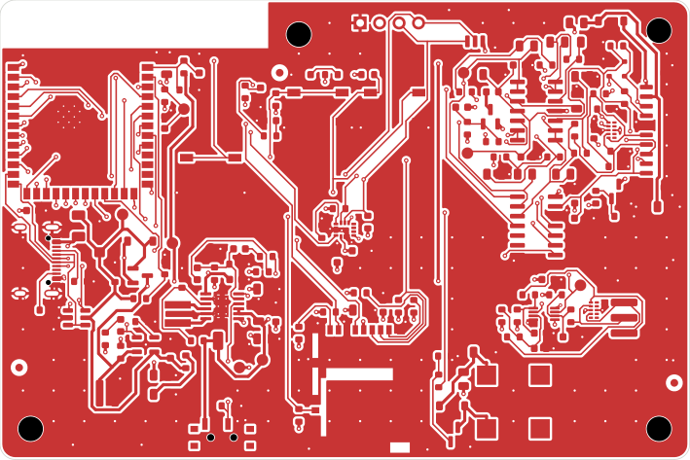
VW-MTC1/Docs/Images/layer_top.png
