Sajeevanveeriah/Ataxia-Monitor/VW-MTC1/Docs/Images/render_bottom.png

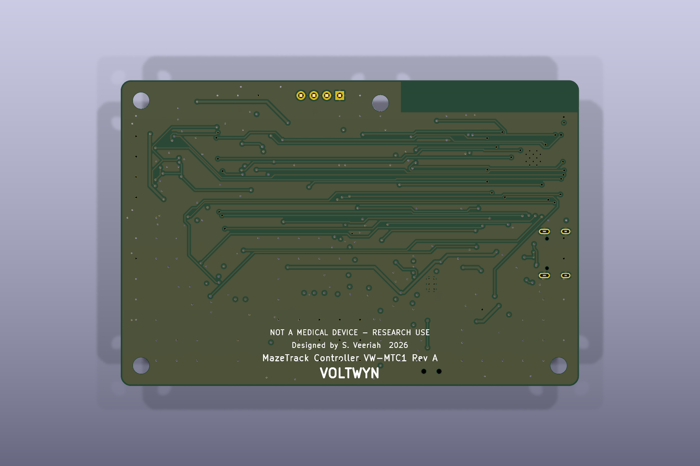
VW-MTC1/Docs/Images/render_bottom.png
