Sajeevanveeriah/Ataxia-Monitor/VW-MTC1/Docs/Images/render_top.png

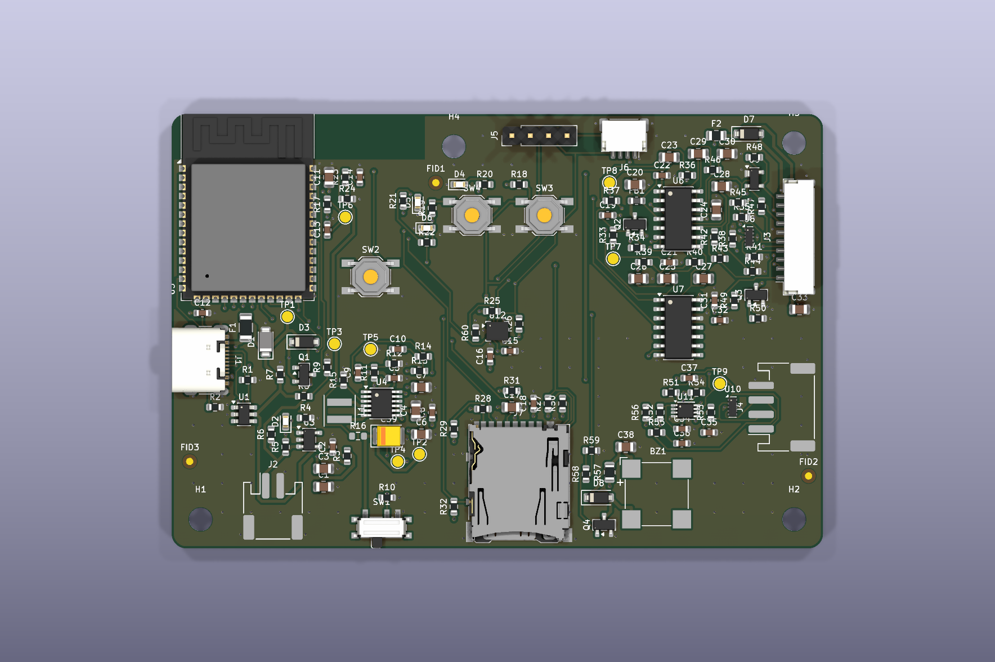
VW-MTC1/Docs/Images/render_top.png
