Sajeevanveeriah/Ataxia-Monitor/VW-MTC1/Docs/Images/sch/VW-MTC1-Power.png

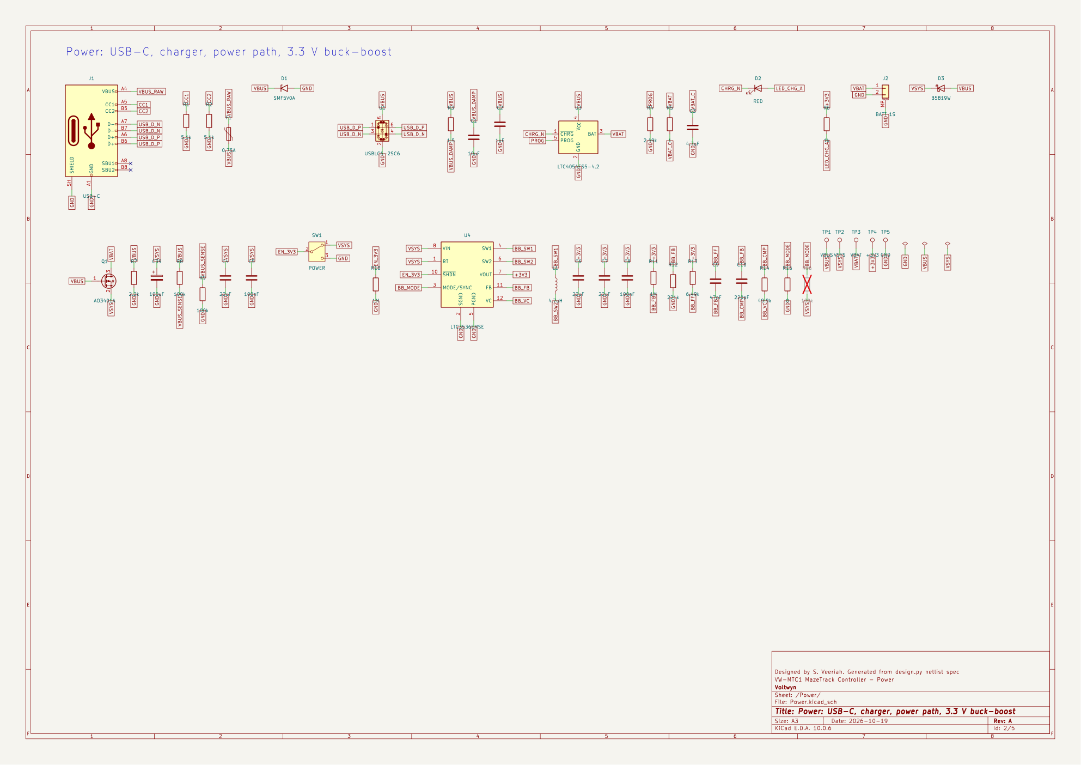
VW-MTC1/Docs/Images/sch/VW-MTC1-Power.png
