Sajeevanveeriah/Ataxia-Monitor/VW-MTC1/Simulation/Plots/sim01b_loadstep.png

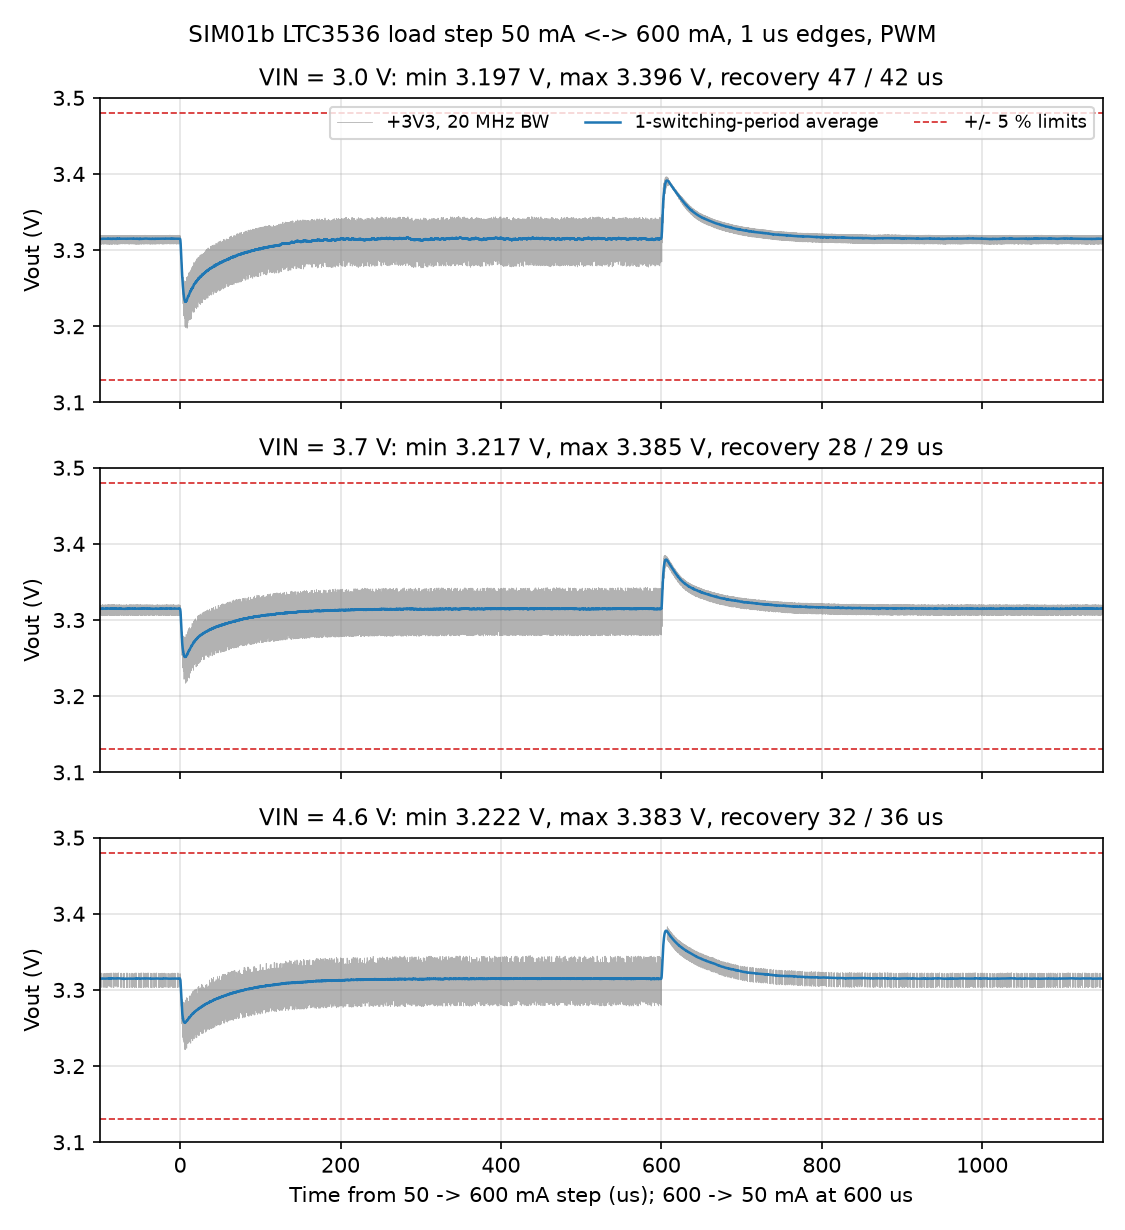
VW-MTC1/Simulation/Plots/sim01b_loadstep.png
