Sajeevanveeriah/Ataxia-Monitor/VW-MTC1/Simulation/Plots/sim01c_efficiency.png

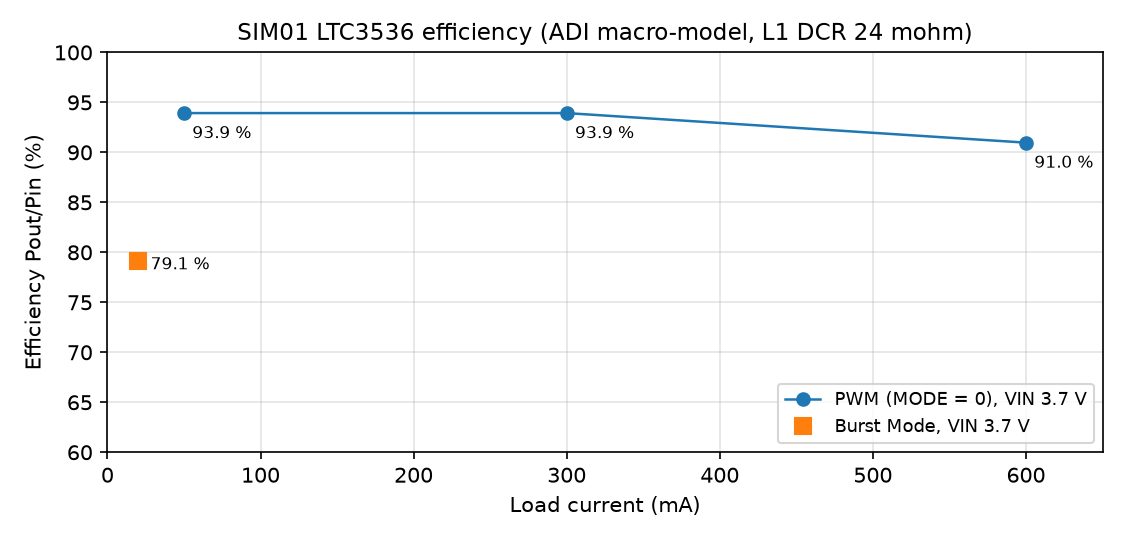
VW-MTC1/Simulation/Plots/sim01c_efficiency.png
