Sajeevanveeriah/Ataxia-Monitor/VW-MTC1/Simulation/Plots/sim01c_ripple_300mA.png

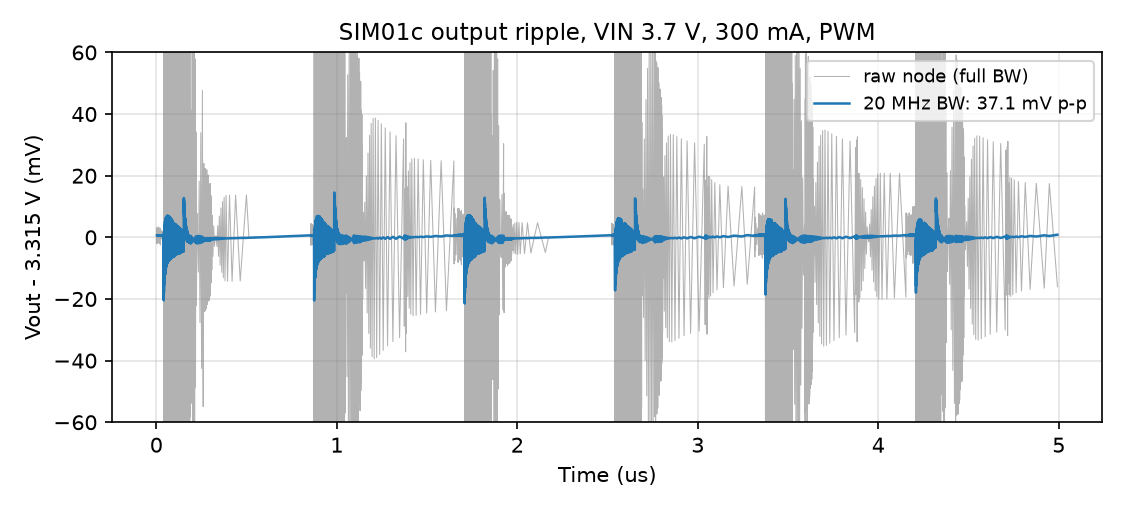
VW-MTC1/Simulation/Plots/sim01c_ripple_300mA.png
