Sajeevanveeriah/Ataxia-Monitor/VW-MTC1/Simulation/Plots/sim01d_burst_20mA.png

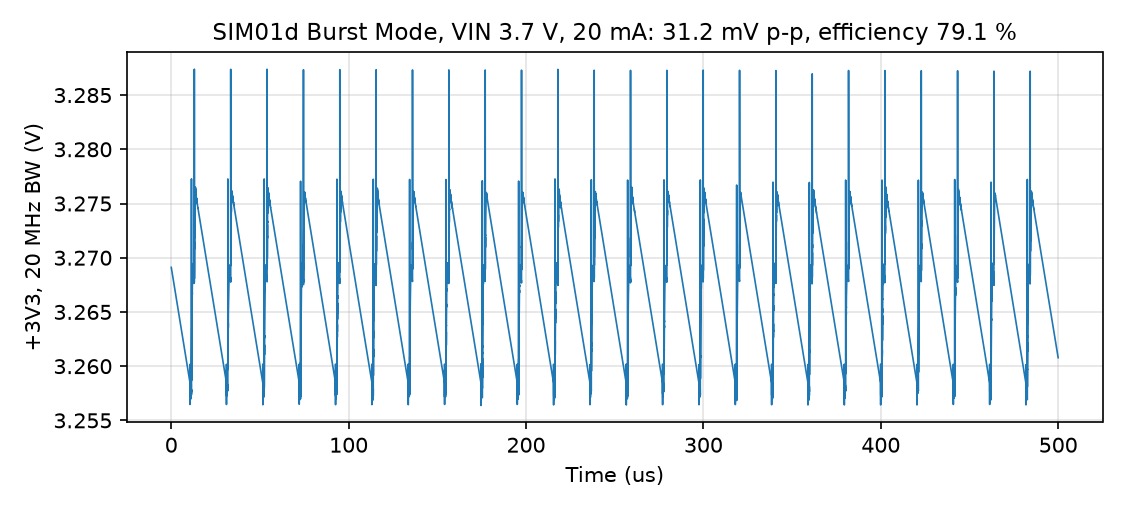
VW-MTC1/Simulation/Plots/sim01d_burst_20mA.png
