Sajeevanveeriah/Ataxia-Monitor/VW-MTC1/Simulation/Plots/sim02a_charger_cccv.png

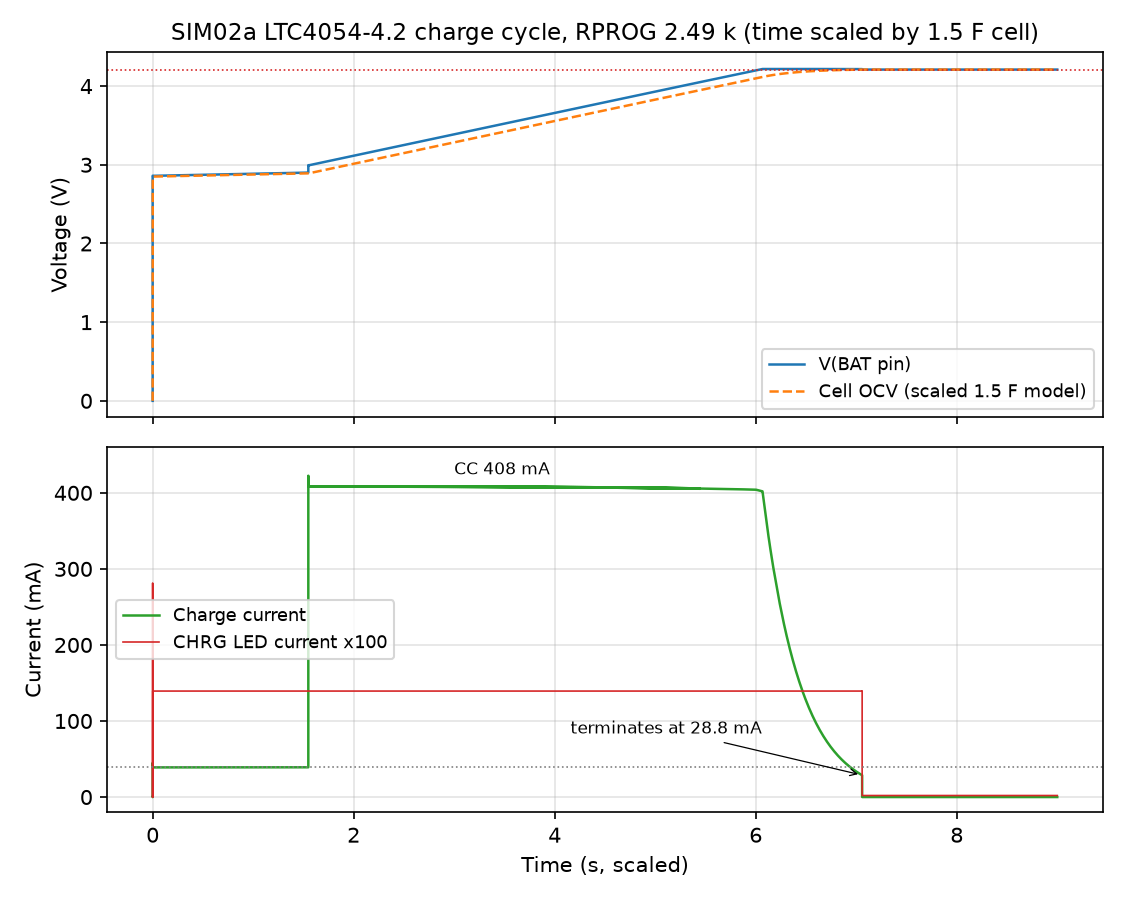
VW-MTC1/Simulation/Plots/sim02a_charger_cccv.png
