Sajeevanveeriah/Ataxia-Monitor/VW-MTC1/Simulation/Plots/sim02b_usb_hotplug.png

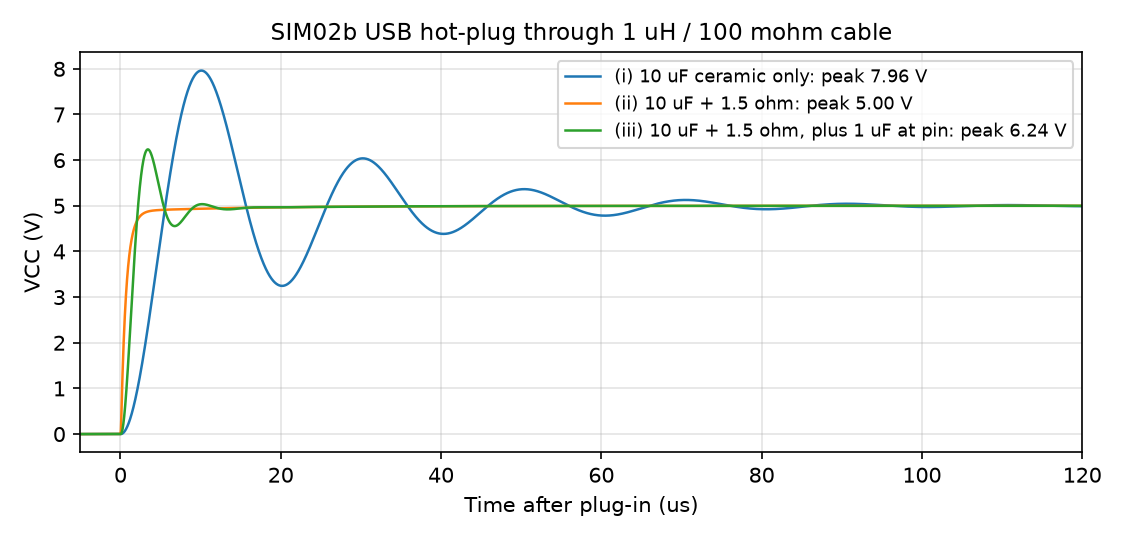
VW-MTC1/Simulation/Plots/sim02b_usb_hotplug.png
