Sajeevanveeriah/Ataxia-Monitor/VW-MTC1/Simulation/Plots/sim03_powerpath_rejected_bat54_attempt.png

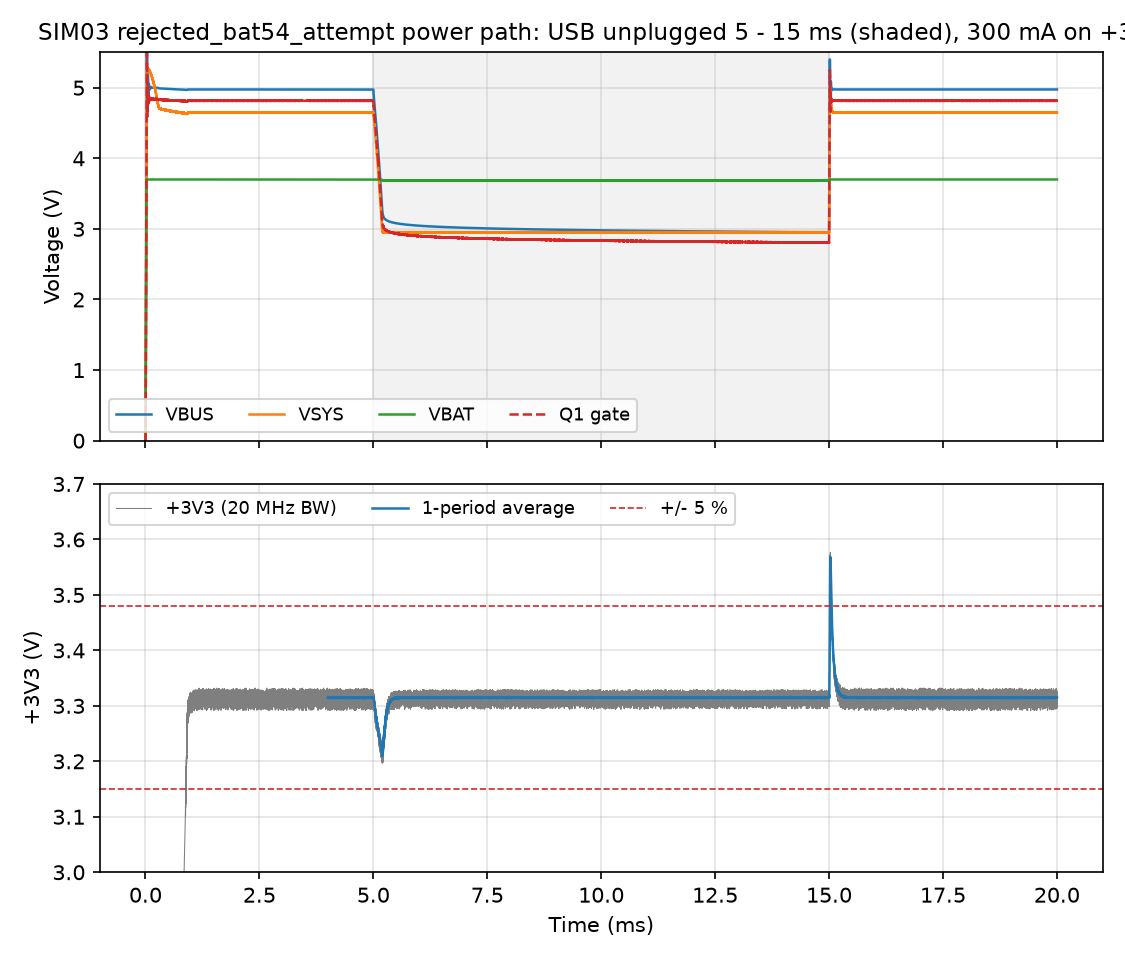
VW-MTC1/Simulation/Plots/sim03_powerpath_rejected_bat54_attempt.png
