Sajeevanveeriah/Ataxia-Monitor/VW-MTC1/Simulation/Plots/sim03c_replug_options.png

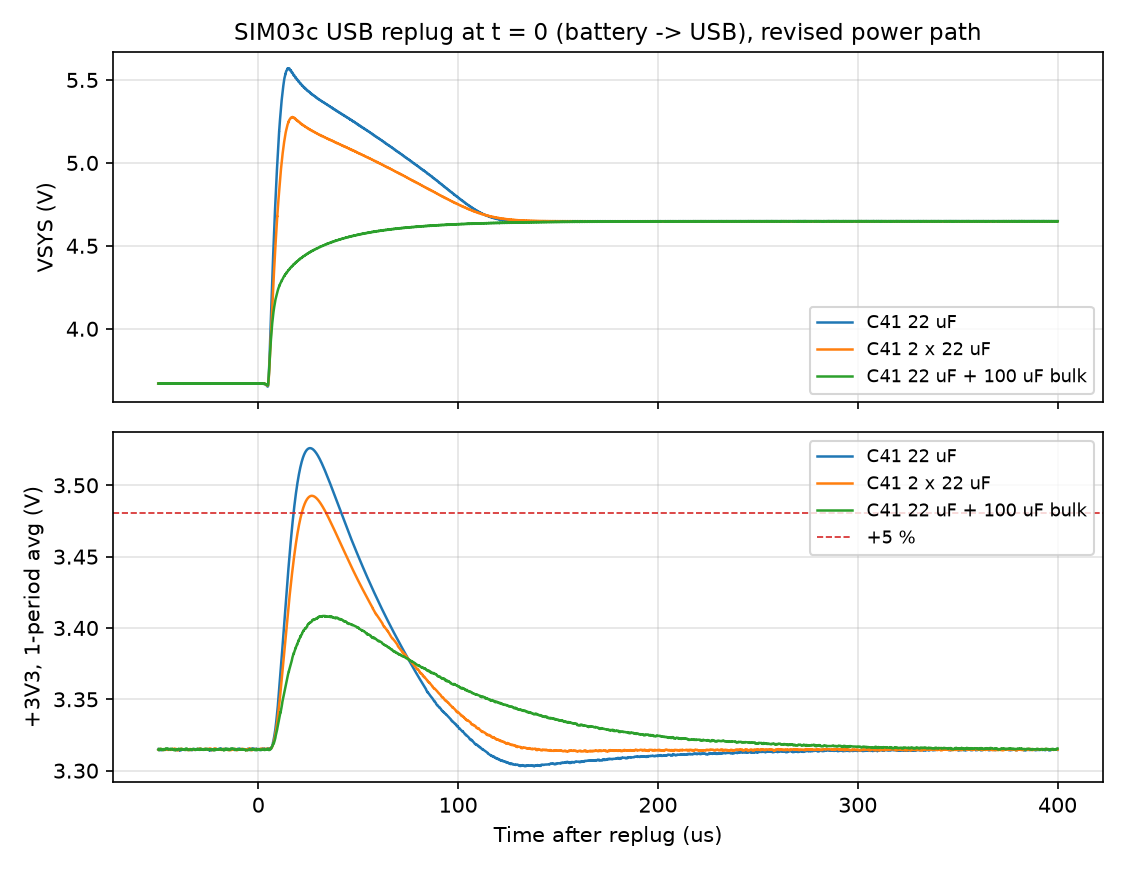
VW-MTC1/Simulation/Plots/sim03c_replug_options.png
