Sajeevanveeriah/Ataxia-Monitor/VW-MTC1/Simulation/Plots/sim03e_q1_gate_study.png

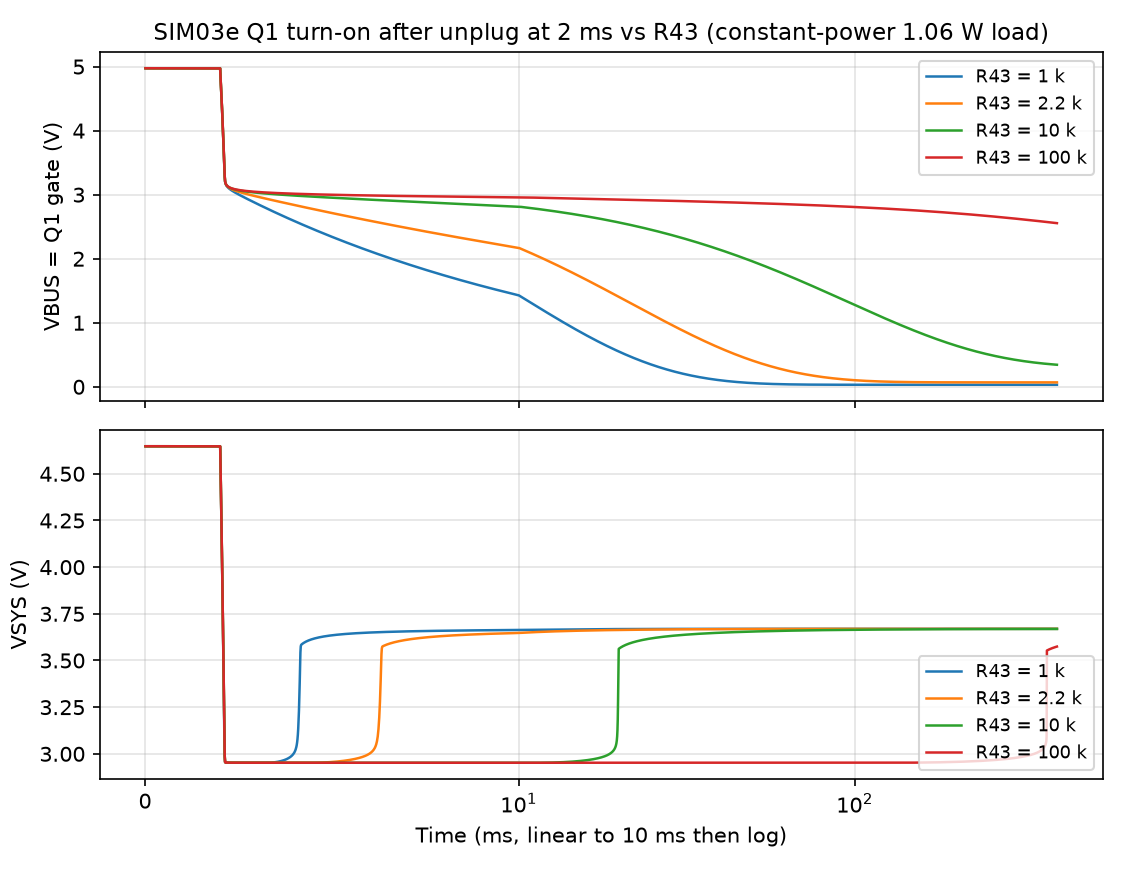
VW-MTC1/Simulation/Plots/sim03e_q1_gate_study.png
