Sajeevanveeriah/Ataxia-Monitor/VW-MTC1/Simulation/Plots/sim04b_hall_peak_timing.png

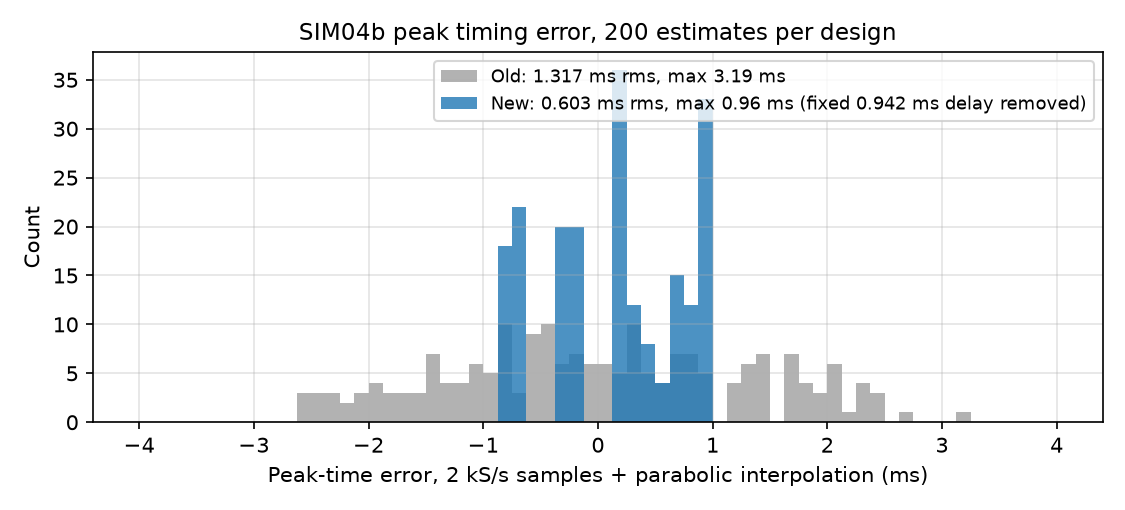
VW-MTC1/Simulation/Plots/sim04b_hall_peak_timing.png
