Sajeevanveeriah/Ataxia-Monitor/VW-MTC1/Simulation/Plots/sim04d_adc_sample_settling.png

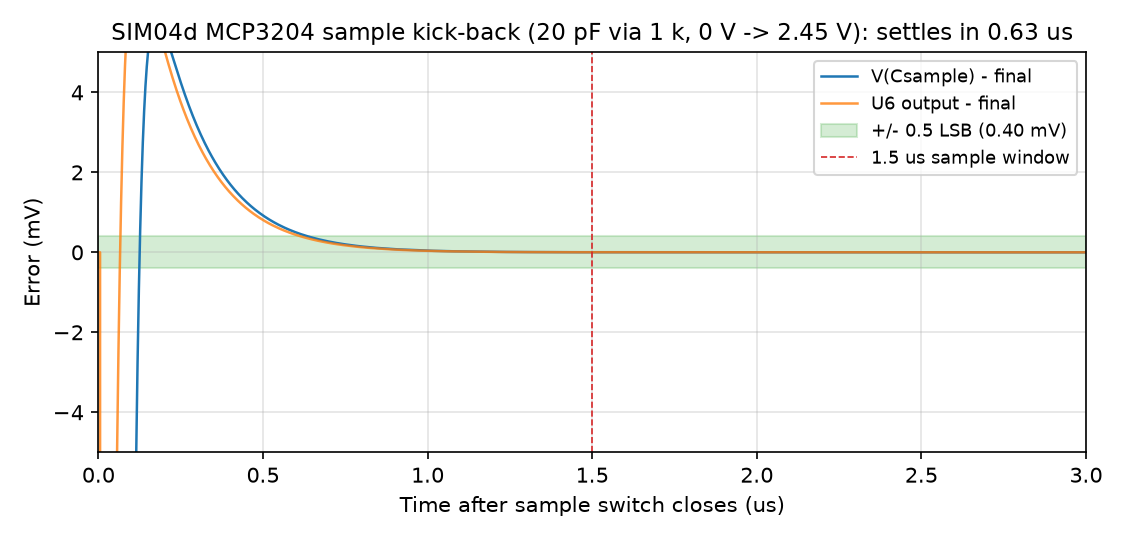
VW-MTC1/Simulation/Plots/sim04d_adc_sample_settling.png
