Sajeevanveeriah/Ataxia-Monitor/VW-MTC1/Simulation/Plots/sim07_buzzer.png

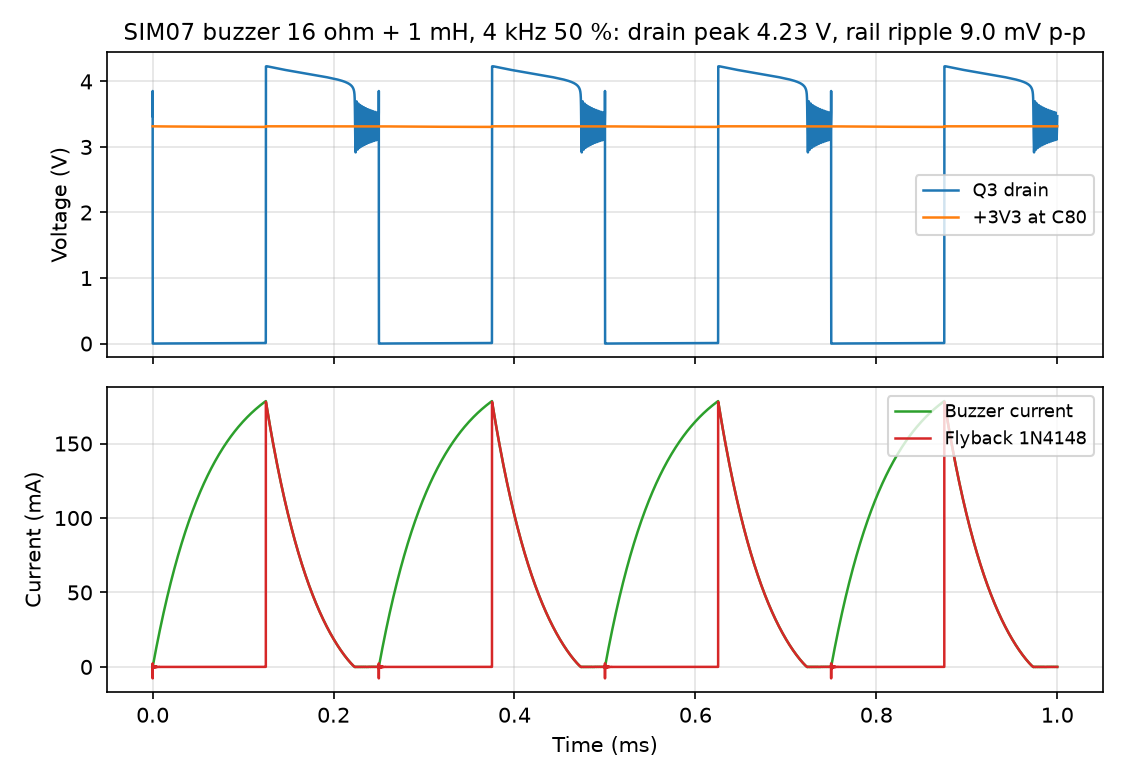
VW-MTC1/Simulation/Plots/sim07_buzzer.png
