Sajeevanveeriah/Ataxia-Monitor/VW-MTC1/Hardware/Fabrication/20261019-VW-MTC1-BOM-Rev00.csv

Designator | Value | Footprint | MPN | Manufacturer | Description | Qty | DNP
BZ1 | 3.6V | Buzzer_Beeper:MagneticBuzzer_CUI_CMT-8504-100-SMT | CMT-8504-100-SMT-TR | CUI Devices | Magnetic transducer 3.6 V, external drive | 1
C1,C17,C20,C33,C38 | 10uF | Capacitor_SMD:C_0805_2012Metric | GRM21BR61E106KA73L | Murata | 10 uF 25 V X5R 0805,Analog rail bulk,Buzzer reservoir (keeps pulses off +3V3),Motor local reservoir,SD card bulk | 5
C2,C13,C32 | 1uF | Capacitor_SMD:C_0603_1608Metric | GRM188R61E105KA12D | Murata | 1 uF 25 V X5R 0603, charger VCC,ADC VREF bypass,EN power-on delay (Espressif guideline) | 3
C3 | 4.7uF | Capacitor_SMD:C_0805_2012Metric | GRM21BR61C475KA88L | Murata | 4.7 uF 16 V X5R 0805 | 1
C4,C6,C7,C11 | 22uF | Capacitor_SMD:C_0805_2012Metric | GRM21BR61A226ME44L | Murata | 22 uF 10 V X5R 0805, buck-boost input,22 uF 10 V X5R 0805, output,22 uF module bulk | 4
C5,C8,C12,C14,C15,C16,C18,C21,C22,C31,C37 | 100nF | Capacitor_SMD:C_0603_1608Metric | GRM188R71H104KA93D | Murata | 100 nF 50 V X7R 0603,100 nF module bypass,100 nF output HF bypass,ADC VDD bypass,ADC charge reservoir,Analog rail bypass,IMU VDD bypass,IMU VDDIO bypass,Op-amp bypass,SD card bypass,Schmitt buffer bypass | 11
C9 | 47pF | Capacitor_SMD:C_0603_1608Metric | GRM1885C1H470JA01D | Murata | 47 pF C0G feed-forward | 1
C10 | 220pF | Capacitor_SMD:C_0603_1608Metric | GRM1885C1H221JA01D | Murata | 220 pF C0G compensation | 1
C19 | 47nF | Capacitor_SMD:C_0603_1608Metric | GRM188R71H473KA61D | Murata | Gate slew cap, limits inrush | 1
C23,C25,C27,C29 | 100nF | Capacitor_SMD:C_0805_2012Metric | GCM21B5C1H104JA16L | Murata | 100 nF C0G 0805, Sallen-Key feedback | 4
C24,C26,C28,C30 | 47nF | Capacitor_SMD:C_0805_2012Metric | GRM2195C1H473JA01D | Murata | 47 nF C0G 0805, Sallen-Key shunt | 4
C34,C35,C36 | 27nF | Capacitor_SMD:C_0603_1608Metric | GRM188R71H273KA01D | Murata | Mains-hum filter, 100 pF coupling immune (SIM05) | 3
C39 | 100uF | Capacitor_Tantalum_SMD:CP_EIA-3528-21_Kemet-B | T520B107M006ATE070 | KEMET | 100 uF 6.3 V polymer tantalum, 70 mohm ESR, VSYS hold-up on USB replug (SIM03) | 1
D1 | SMF5V0A | Diode_SMD:D_SMF | SMF5V0A | Littelfuse | TVS 5 V standoff, 200 W, VBUS surge clamp | 1
D2,D5 | RED | LED_SMD:LED_0603_1608Metric | 150060RS75000 | Wurth | Red LED 0603, charging indicator,Red LED 0603, reverse | 2
D3,D7 | B5819W | Diode_SMD:D_SOD-123 | B5819W | Diodes Inc | Motor flyback clamp,Schottky 40 V 1 A, USB to VSYS OR-ing | 2
D4 | GREEN | LED_SMD:LED_0603_1608Metric | 150060GS75000 | Wurth | Green LED 0603, forward | 1
D6 | AMBER | LED_SMD:LED_0603_1608Metric | 150060AS75000 | Wurth | Amber LED 0603, idle | 1
D8 | 1N4148W | Diode_SMD:D_SOD-123 | 1N4148W-7-F | Diodes Inc | Buzzer coil flyback | 1
F1 | 0.75A | Fuse:Fuse_1206_3216Metric | 1206L075THYR | Littelfuse | PTC resettable fuse 0.75 A hold, 6 V | 1
F2 | 0.2A | Fuse:Fuse_0805_2012Metric | 0805L020WR | Littelfuse | PTC 0.2 A hold, protects VSYS from cable faults | 1
FB1 | 600R@100MHz | Inductor_SMD:L_0603_1608Metric | BLM18PG601SN1D | Murata | Ferrite bead 600 R @ 100 MHz, 500 mA | 1
J1 | USB-C | Connector_USB:USB_C_Receptacle_GCT_USB4105-xx-A_16P_TopMnt_Horizontal | USB4105-GF-A | GCT | USB Type-C receptacle, USB 2.0, 16P | 1
J2 | BATT 1S | Connector_JST:JST_PH_S2B-PH-SM4-TB_1x02-1MP_P2.00mm_Horizontal | S2B-PH-SM4-TB(LF)(SN) | JST | 1S Li-ion/LiPo battery connector (protected cell required) | 1
J3 | HANDLE | Connector_JST:JST_GH_SM10B-GHS-TB_1x10-1MP_P1.25mm_Horizontal | SM10B-GHS-TB(LF)(SN) | JST | Handle cable: 4x SS49E, I2C, haptic motor, ring = GND | 1
J4 | MAZE | Connector_JST:JST_PH_S4B-PH-SM4-TB_1x04-1MP_P2.00mm_Horizontal | S4B-PH-SM4-TB(LF)(SN) | JST | Maze wire, start pad, finish pad, ground | 1
J5 | OLED | Connector_PinHeader_2.54mm:PinHeader_1x04_P2.54mm_Vertical | PH1-04-UA | Adam Tech | SSD1306 0.96/1.3 inch OLED header (GND VCC SCL SDA) | 1
J6 | QWIIC | Connector_JST:JST_SH_SM04B-SRSS-TB_1x04-1MP_P1.00mm_Horizontal | SM04B-SRSS-TB(LF)(SN) | JST | Qwiic/STEMMA QT I2C expansion (e.g. VL53L1X LiDAR) | 1
J7 | microSD | Connector_Card:microSD_HC_Hirose_DM3AT-SF-PEJM5 | DM3AT-SF-PEJM5 | Hirose | microSD push-push socket with card detect | 1
L1 | 4.7uH | Inductor_SMD:L_Coilcraft_XxL4020 | XFL4020-472MEC | Coilcraft | 4.7 uH 2.7 A shielded power inductor | 1
Q1,Q2 | AO3401A | Package_TO_SOT_SMD:SOT-23 | AO3401A | Alpha & Omega | Hall sensor rail switch (power down between sessions),P-MOSFET -30 V, battery load-sharing switch | 2
Q3,Q4 | AO3400A | Package_TO_SOT_SMD:SOT-23 | AO3400A | Alpha & Omega | Buzzer low-side switch,N-MOSFET 30 V, haptic motor low-side switch | 2
R1,R2 | 5.1k | Resistor_SMD:R_0603_1608Metric | RC0603FR-075R1kL | Yageo | CC1 Rd pull-down (UFP, default USB current),CC2 Rd pull-down | 2
R3 | 1.5 | Resistor_SMD:R_0603_1608Metric | RC0603FR-071R5L | Yageo | Hot-plug damping resistor (LTC4054 app note) | 1
R4 | 2.49k | Resistor_SMD:R_0603_1608Metric | RC0603FR-072K49L | Yageo | Charge current 1000 x 1 V / 2.49k = 402 mA | 1
R5 | 1 | Resistor_SMD:R_0603_1608Metric | RC0603FR-071RL | Yageo | Series R for ceramic BAT cap (LTC4054 stability) | 1
R6 | 1k | Resistor_SMD:R_0603_1608Metric | RC0603FR-071kL | Yageo | Charge LED current limit | 1
R7,R47,R48 | 2.2k | Resistor_SMD:R_0603_1608Metric | RC0603FR-072R2kL | Yageo | Handle I2C pull-up,Handle I2C pull-up (cable capacitance),Q1 gate pull-down: discharges VBUS so Q1 turns on within ~5.5 ms of unplug (SIM03) | 3
R8,R9,R16,R33,R50,R59 | 100k | Resistor_SMD:R_0603_1608Metric | RC0603FR-07100kL | Yageo | Gate pull-down (motor off at boot),Gate pull-down (silent at boot),MODE strap option: fit (and remove R15) for Burst Mode,Q2 default off,USB detect divider bottom,USB detect divider top | 6 | DNP
R10,R11,R23,R24,R35,R38,R41,R44 | 1M | Resistor_SMD:R_0603_1608Metric | RC0603FR-071ML | Yageo | Battery divider bottom,Battery divider top (2 uA drain),Enable defined low during switch travel,Feedback top (VOUT = 0.6 x (1 + 1M/221k) = 3.315 V),Handle-absent detect pull-down | 8
R12 | 221k | Resistor_SMD:R_0603_1608Metric | RC0603FR-07221kL | Yageo | Feedback bottom | 1
R13 | 6.49k | Resistor_SMD:R_0603_1608Metric | RC0603FR-076R49kL | Yageo | Feed-forward zero resistor | 1
R14 | 49.9k | Resistor_SMD:R_0603_1608Metric | RC0603FR-0749R9kL | Yageo | Compensation resistor | 1
R15 | 0 | Resistor_SMD:R_0603_1608Metric | RC0603JR-070RL | Yageo | MODE strap: fitted = fixed-frequency PWM (lowest noise) | 1
R17,R18,R19,R27,R28,R29,R30,R31,R32,R36,R37,R39,R40,R42,R43,R45,R46,R51,R53,R55,R60 | 10k | Resistor_SMD:R_0603_1608Metric | RC0603FR-0710kL | Yageo | Button pull-up,EN pull-up,GPIO0 strap pull-up,IMU address strap SA0=0 (0x6A); move to +3V3 for 0x6B,SD bus pull-up,Sallen-Key R1,Sallen-Key R2,Series R (SIM05 revised) | 21
R20,R21,R22 | 470 | Resistor_SMD:R_0603_1608Metric | RC0603FR-07470L | Yageo | LED current ~2.5 mA | 3
R25,R26,R34 | 4.7k | Resistor_SMD:R_0603_1608Metric | RC0603FR-074R7kL | Yageo | Gate series R, soft start with C19,I2C0 pull-up | 3
R49,R58 | 100 | Resistor_SMD:R_0603_1608Metric | RC0603FR-07100L | Yageo | Gate series R | 2
R52,R54,R56 | 360k | Resistor_SMD:R_0603_1608Metric | RC0603FR-07360kL | Yageo | Touch pull-up: limits current through a person to 9 uA (SIM05) | 3
R57 | 22 | Resistor_SMD:R_0805_2012Metric | RC0805FR-0722RL | Yageo | Buzzer current limit 0805 | 1
SW1 | POWER | Button_Switch_SMD:SW_SPDT_PCM12 | PCM12SMTR | C&K | Slide switch SPDT, power on/off (regulator enable) | 1
SW2 | RESET | Button_Switch_SMD:SW_SPST_TL3342 | TL3342F160QG | E-Switch | Tactile switch, reset | 1
SW3 | BOOT/MODE | Button_Switch_SMD:SW_SPST_TL3342 | TL3342F160QG | E-Switch | Tactile switch, boot / user mode | 1
SW4 | START | Button_Switch_SMD:SW_SPST_TL3342 | TL3342F160QG | E-Switch | Tactile switch, start / calibrate | 1
U1 | USBLC6-2SC6 | Package_TO_SOT_SMD:SOT-23-6 | USBLC6-2SC6 | STMicroelectronics | USB 2.0 data line ESD protection | 1
U3 | LTC4054ES5-4.2 | Package_TO_SOT_SMD:TSOT-23-5 | LTC4054ES5-4.2#TRPBF | Analog Devices | Li-ion linear charger 4.2 V, thermal regulation | 1
U4 | LTC3536EMSE | Package_SO:MSOP-12-1EP_3x4.039mm_P0.65mm_EP1.651x2.845mm_ThermalVias | LTC3536EMSE#PBF | Analog Devices | 1 A low-noise synchronous buck-boost, 1.8-5.5 V | 1
U5 | ESP32-S3-WROOM-1-N8R2 | RF_Module:ESP32-S3-WROOM-1 | ESP32-S3-WROOM-1-N8R2 | Espressif | Wi-Fi/BLE 5 module, dual-core 240 MHz, 8 MB flash, 2 MB PSRAM | 1
U6 | MCP6004-I/SL | Package_SO:SOIC-14_3.9x8.7mm_P1.27mm | MCP6004T-I/SL | Microchip | Quad 1 MHz RRIO op-amp, Sallen-Key filters | 1
U7 | MCP3204-C/SL | Package_SO:SOIC-14_3.9x8.7mm_P1.27mm | MCP3204-CI/SL | Microchip | 4-ch 12-bit SAR ADC, SPI, ratiometric to +3V3_H | 1
U8,U10 | TPD4E05U06 | Package_SON:USON-10_2.5x1.0mm_P0.5mm | TPD4E05U06DQAR | Texas Instruments | 4-ch ESD, IEC 61000-4-2 +/-12 kV contact,ESD on maze inputs | 2
U9 | PRTR5V0U2X | Package_TO_SOT_SMD:SOT-143 | PRTR5V0U2X,215 | Nexperia | 2-ch ESD for handle I2C | 1
U11 | 74LVC3G17 | Package_SO:VSSOP-8_2.3x2mm_P0.5mm | SN74LVC3G17DCUR | Texas Instruments | Triple Schmitt buffer, clean touch edges | 1
U12 | ISM330DHCX | Package_LGA:LGA-14_3x2.5mm_P0.5mm_LayoutBorder3x4y | ISM330DHCXTR | STMicroelectronics | 6-axis IMU, industrial, I2C addr 0x6A | 1
