Sajeevanveeriah/Ataxia-Monitor/VW-MTC1/Hardware/Fabrication/20261019-VW-MTC1-3D-Model-Rev00.step

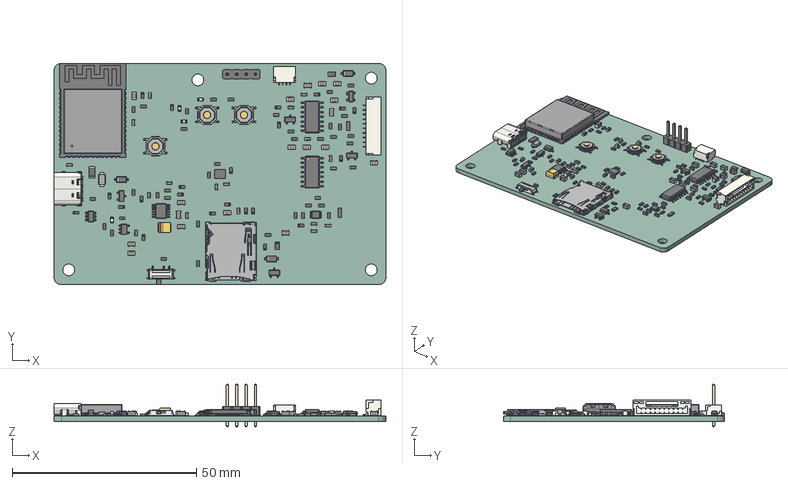
[picture p39: CAD file, 2026-10-20]
VW-MTC1/Hardware/Fabrication/20261019-VW-MTC1-3D-Model-Rev00.step
90.0 x 60.0 x 11.5 mm
D_SOD-123 x 3
R_0603_1608Metric x 58
USON_10_25x10mm_Pitch05mm x 2
C_0603_1608Metric x 20
C_0805_2012Metric x 18
SW_SPST_TL3342 x 3
SOT-23-6
JST_SH_SM04B-SRSS-TB_1x04-1MP_P1.00mm_Horizontal
LED_0603_1608Metric x 4
R_0805_2012Metric
SOIC-14_3.9x8.7mm_P1.27mm x 2
SOT-143
TSOT-23-5
microSD_HC_Hirose_DM3AT-SF-PEJM5
SOT-23 x 4
Fusion_sp
Fuse_0805_2012Metric
VSSOP-8_2.3x2mm_P0.5mm
PinHeader_1x04_P254mm_Vertical
CP_EIA_3528_21_Kemet_B
ESP32-S3-WROOM-1
JST_SM10B_GHS_TB
D_SMF
LGA_14_3x25mm_P05mm_LayoutBorder3x4y
L_0603_1608Metric
MSOP-12-1EP_3x4.039mm_P0.65mm_EP1.651x2.845mm
USB_C_Receptacle_16P_TopMnt_Horizontal_GCT_USB4105-xx-A
Fuse_1206_3216Metric
VW-MTC1_PCB
