Sajeevanveeriah/Ataxia-Monitor/VW-MTC1/Docs/Images/assembly_top.png

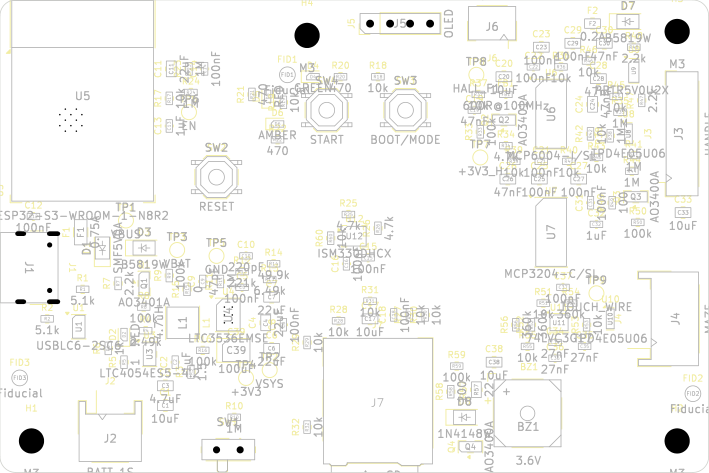
VW-MTC1/Docs/Images/assembly_top.png
