Sajeevanveeriah/Ataxia-Monitor/VW-MTC1/Docs/20261019-VW-MTC1-Schematic-Rev00.pdf

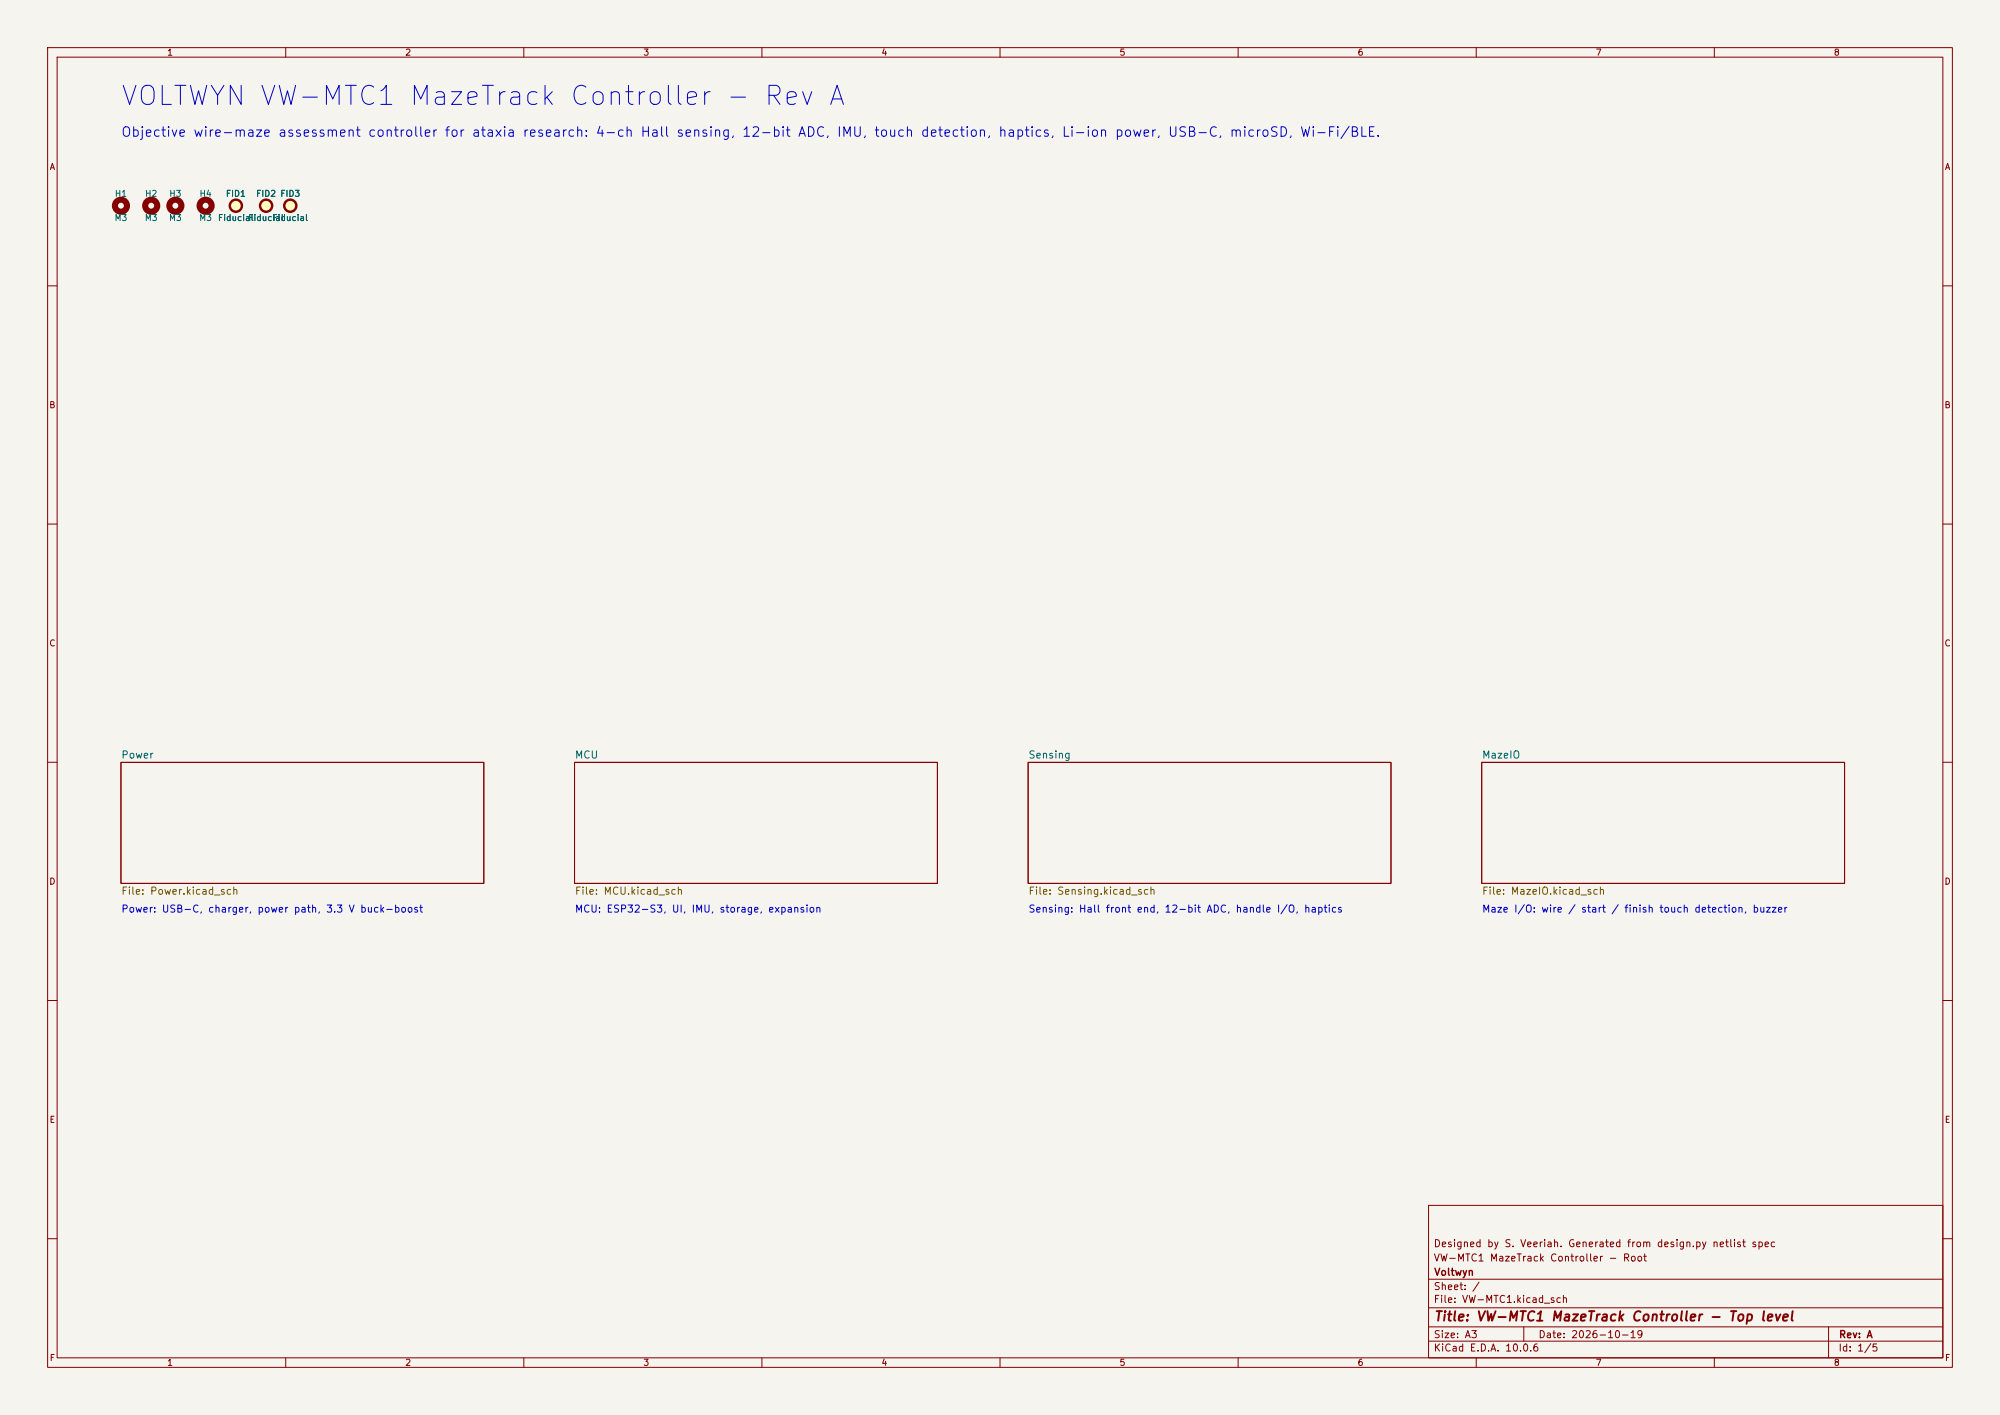
[picture p42: page 1]

VOLTWYN VW-MTC1 MazeTrack Controller - Rev A

Objective wire-maze assessment controller for ataxia research: 4-ch Hall sensing, 12-bit ADC, IMU, touch detection, haptics, Li-ion power, USB-C, microSD, Wi-Fi/BLE.

Designed by S. Veeriah. Generated from design.py netlist spec
VW-MTC1 MazeTrack Controller - Root
Voltwyn
Sheet: /
File: VW-MTC1.kicad_sch
Title: VW-MTC1 MazeTrack Controller - Top level

Size: A3 | Rev: A | F Date: 2026-10-19
KiCad E.D.A. 10.0.6 | Id: 1/5

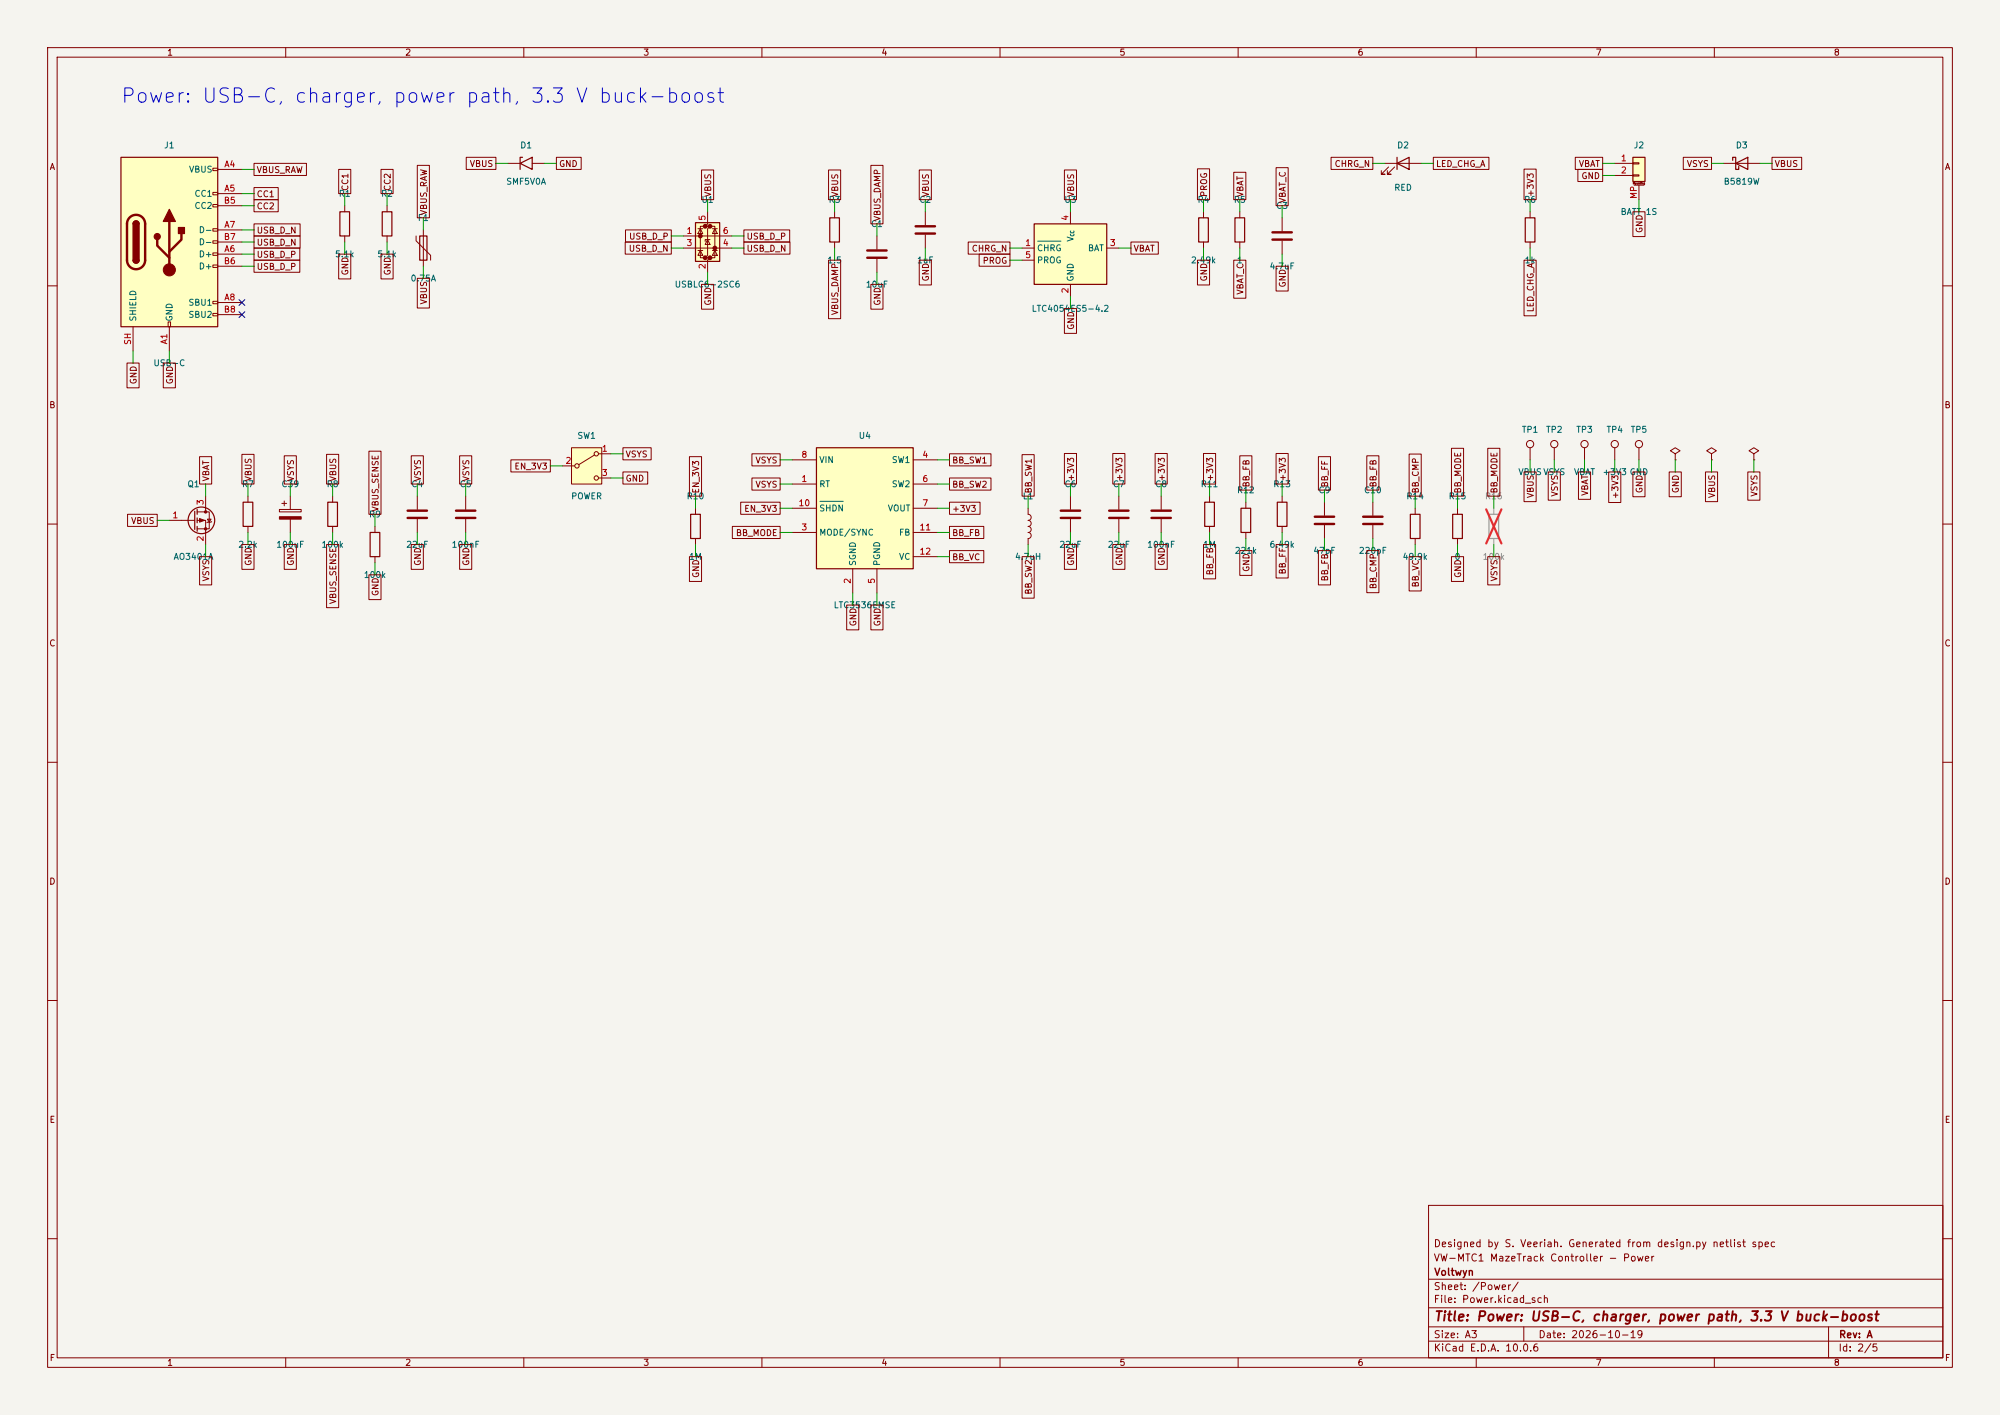
[picture p43: page 2]

Power: USB-C, charger, power path, 3.3 V buck-boost
J1 USB-C

Designed by S. Veeriah. Generated from design.py netlist spec
VW-MTC1 MazeTrack Controller - Power
Voltwyn
Sheet: /Power/
File: Power.kicad_sch
Title: Power: USB-C, charger, power path, 3.3 V buck-boost

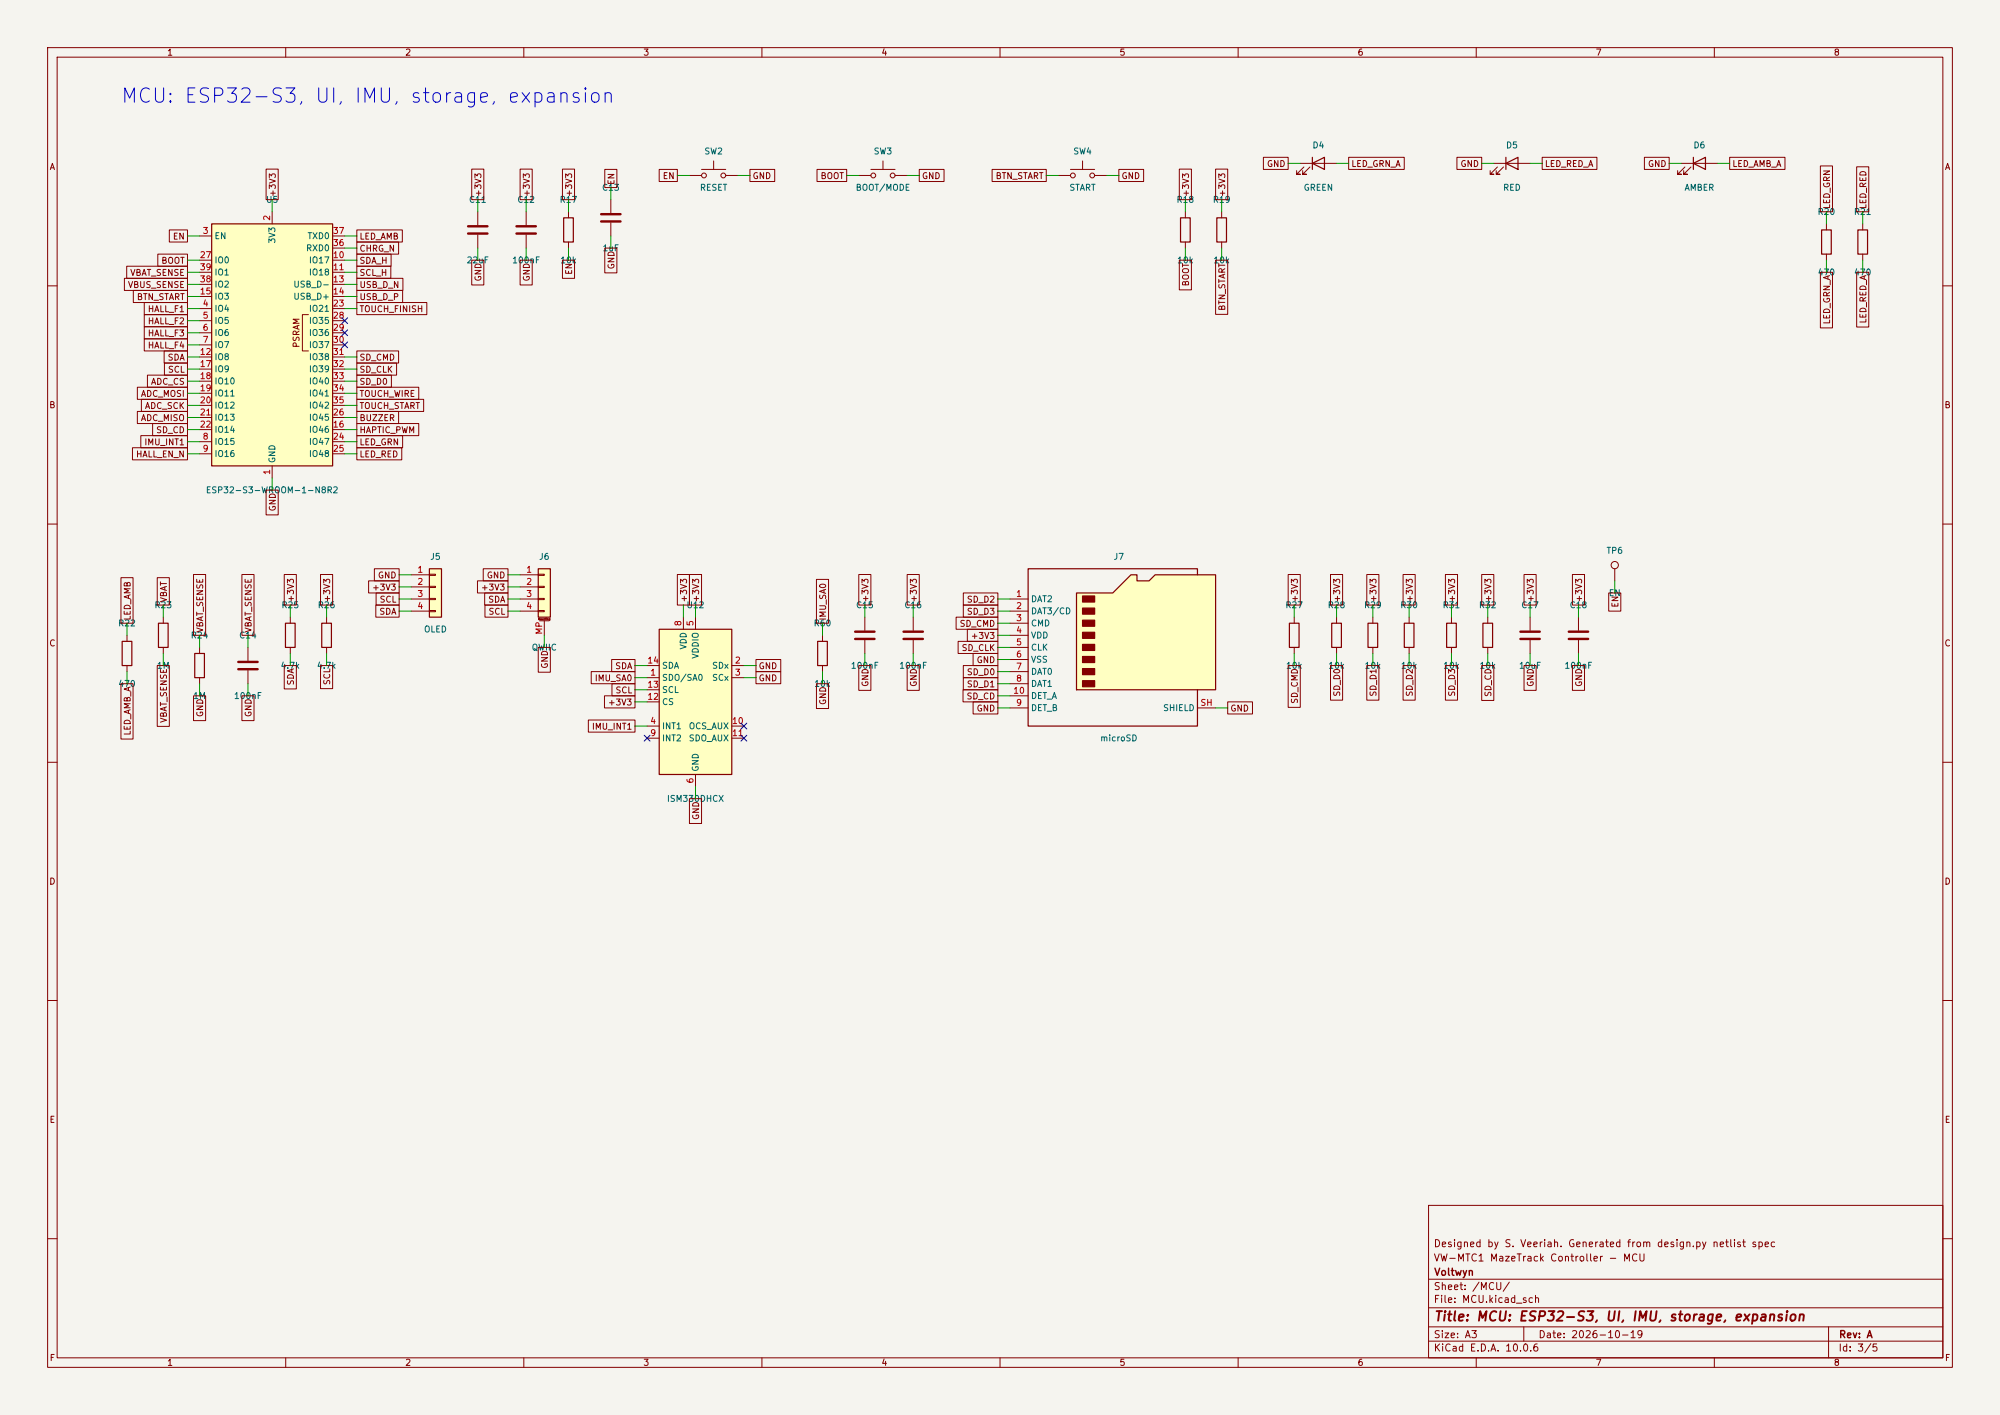
[picture p44: page 3]

SD_D1 MCU: ESP32-S3, UI, IMU, storage, expansion

Designed by S. Veeriah. Generated from design.py netlist spec
VW-MTC1 MazeTrack Controller - MCU
Voltwyn
Sheet: /MCU/
File: MCU.kicad_sch
Title: MCU: ESP32-S3, UI, IMU, storage, expansion

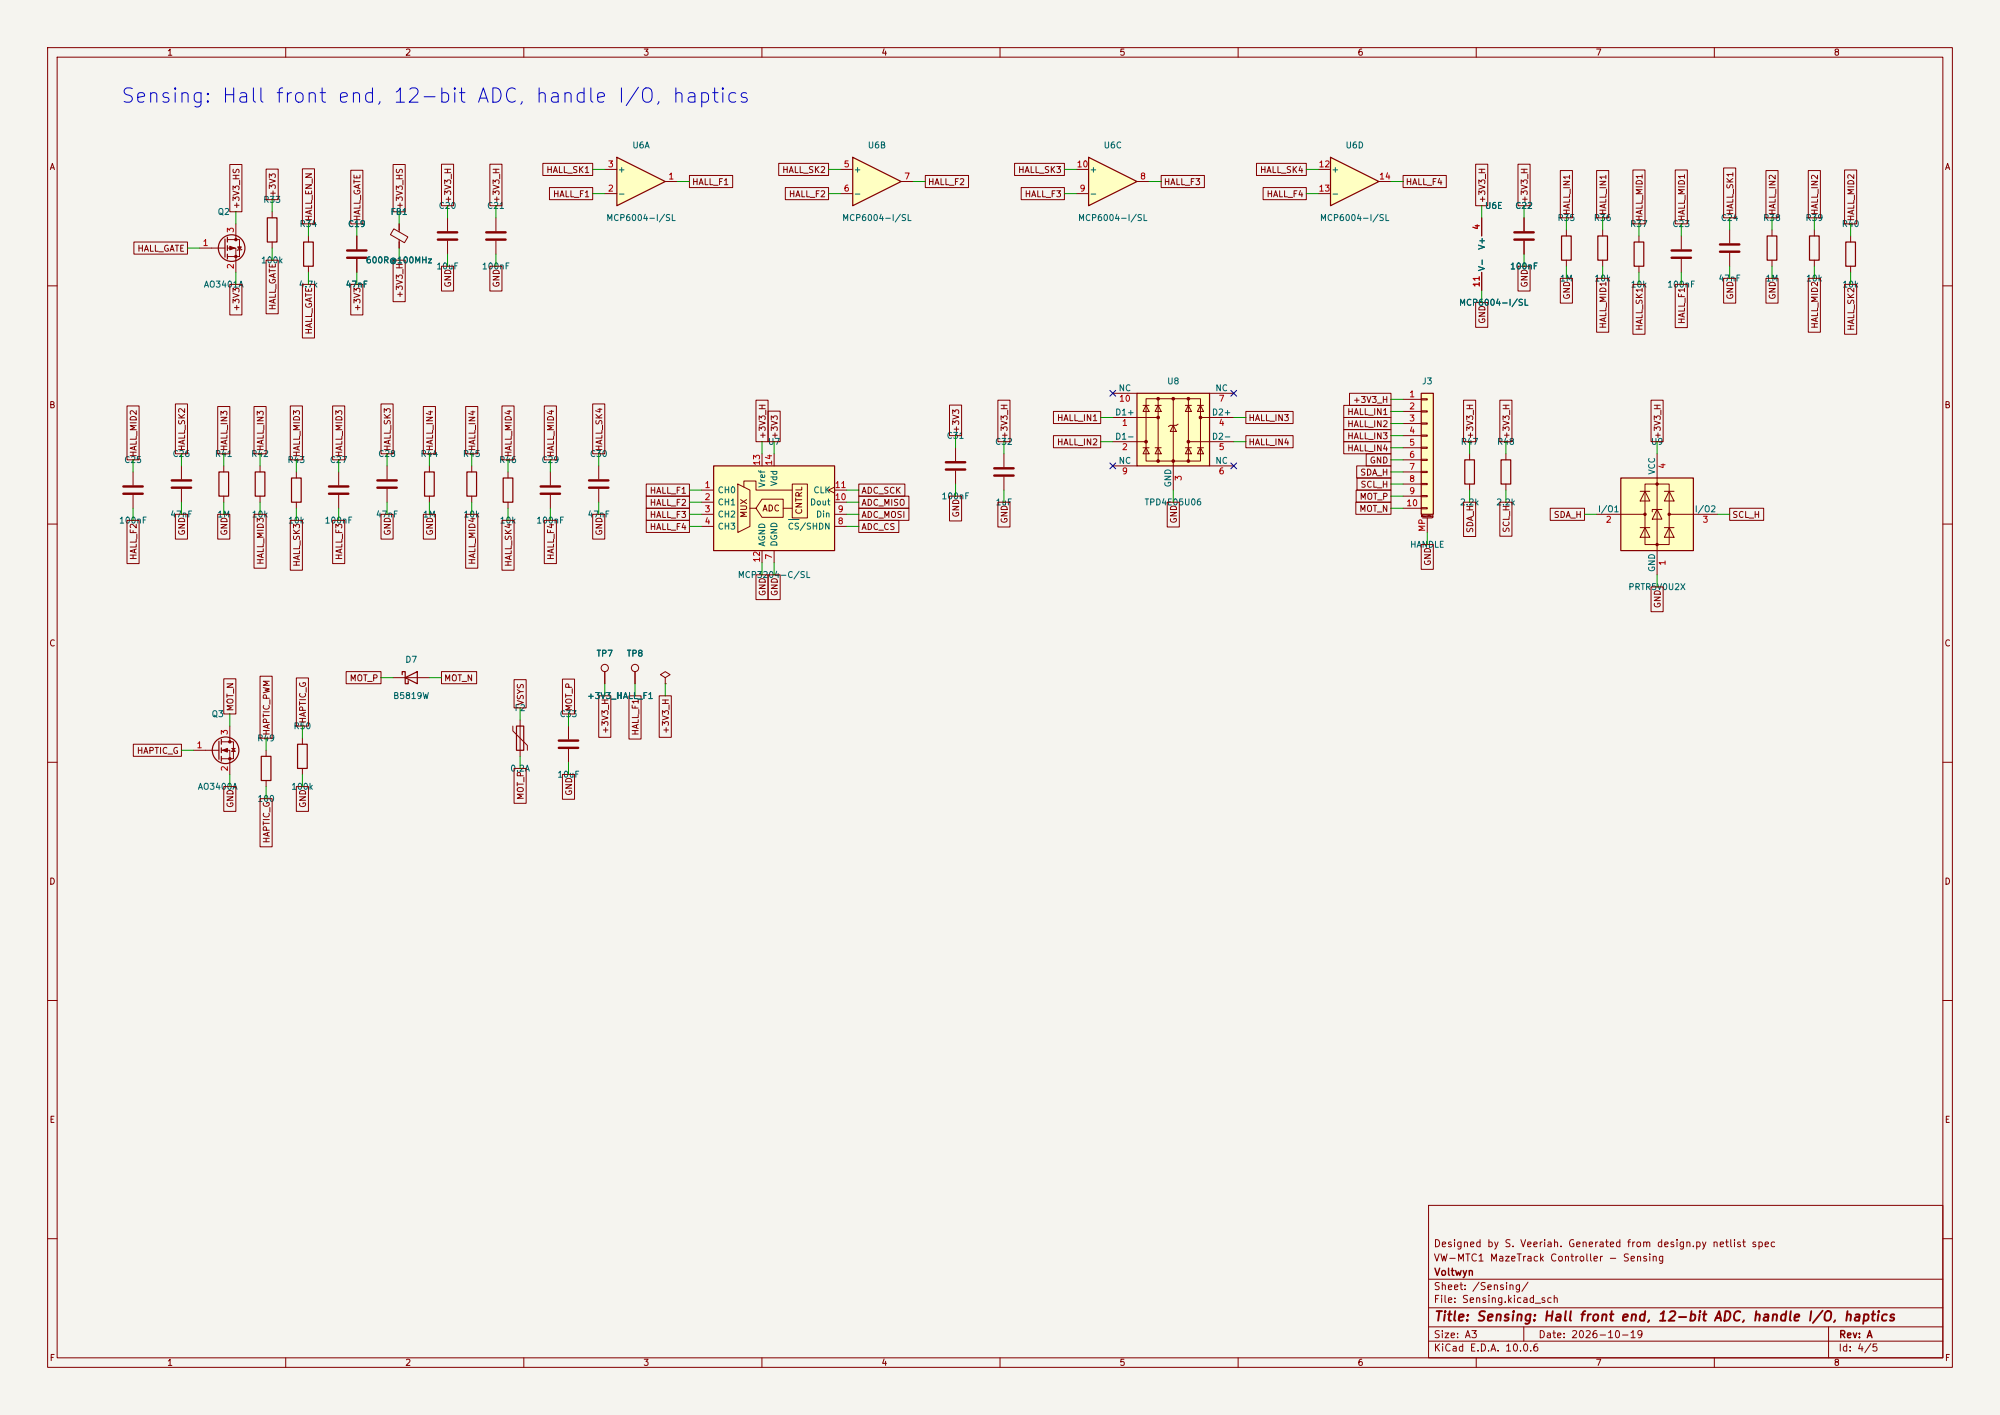
[picture p45: page 4]

Sensing: Hall front end, 12-bit ADC, handle I/O, haptics

7 CS/SHDN 8 Din 9 Dout 10 CLK 11 AGND 12 Vref 13 Vdd 14 U7 MCP3204-C/SL R48

Designed by S. Veeriah. Generated from design.py netlist spec
VW-MTC1 MazeTrack Controller - Sensing
Voltwyn
Sheet: /Sensing/
File: Sensing.kicad_sch
Title: Sensing: Hall front end, 12-bit ADC, handle I/O, haptics

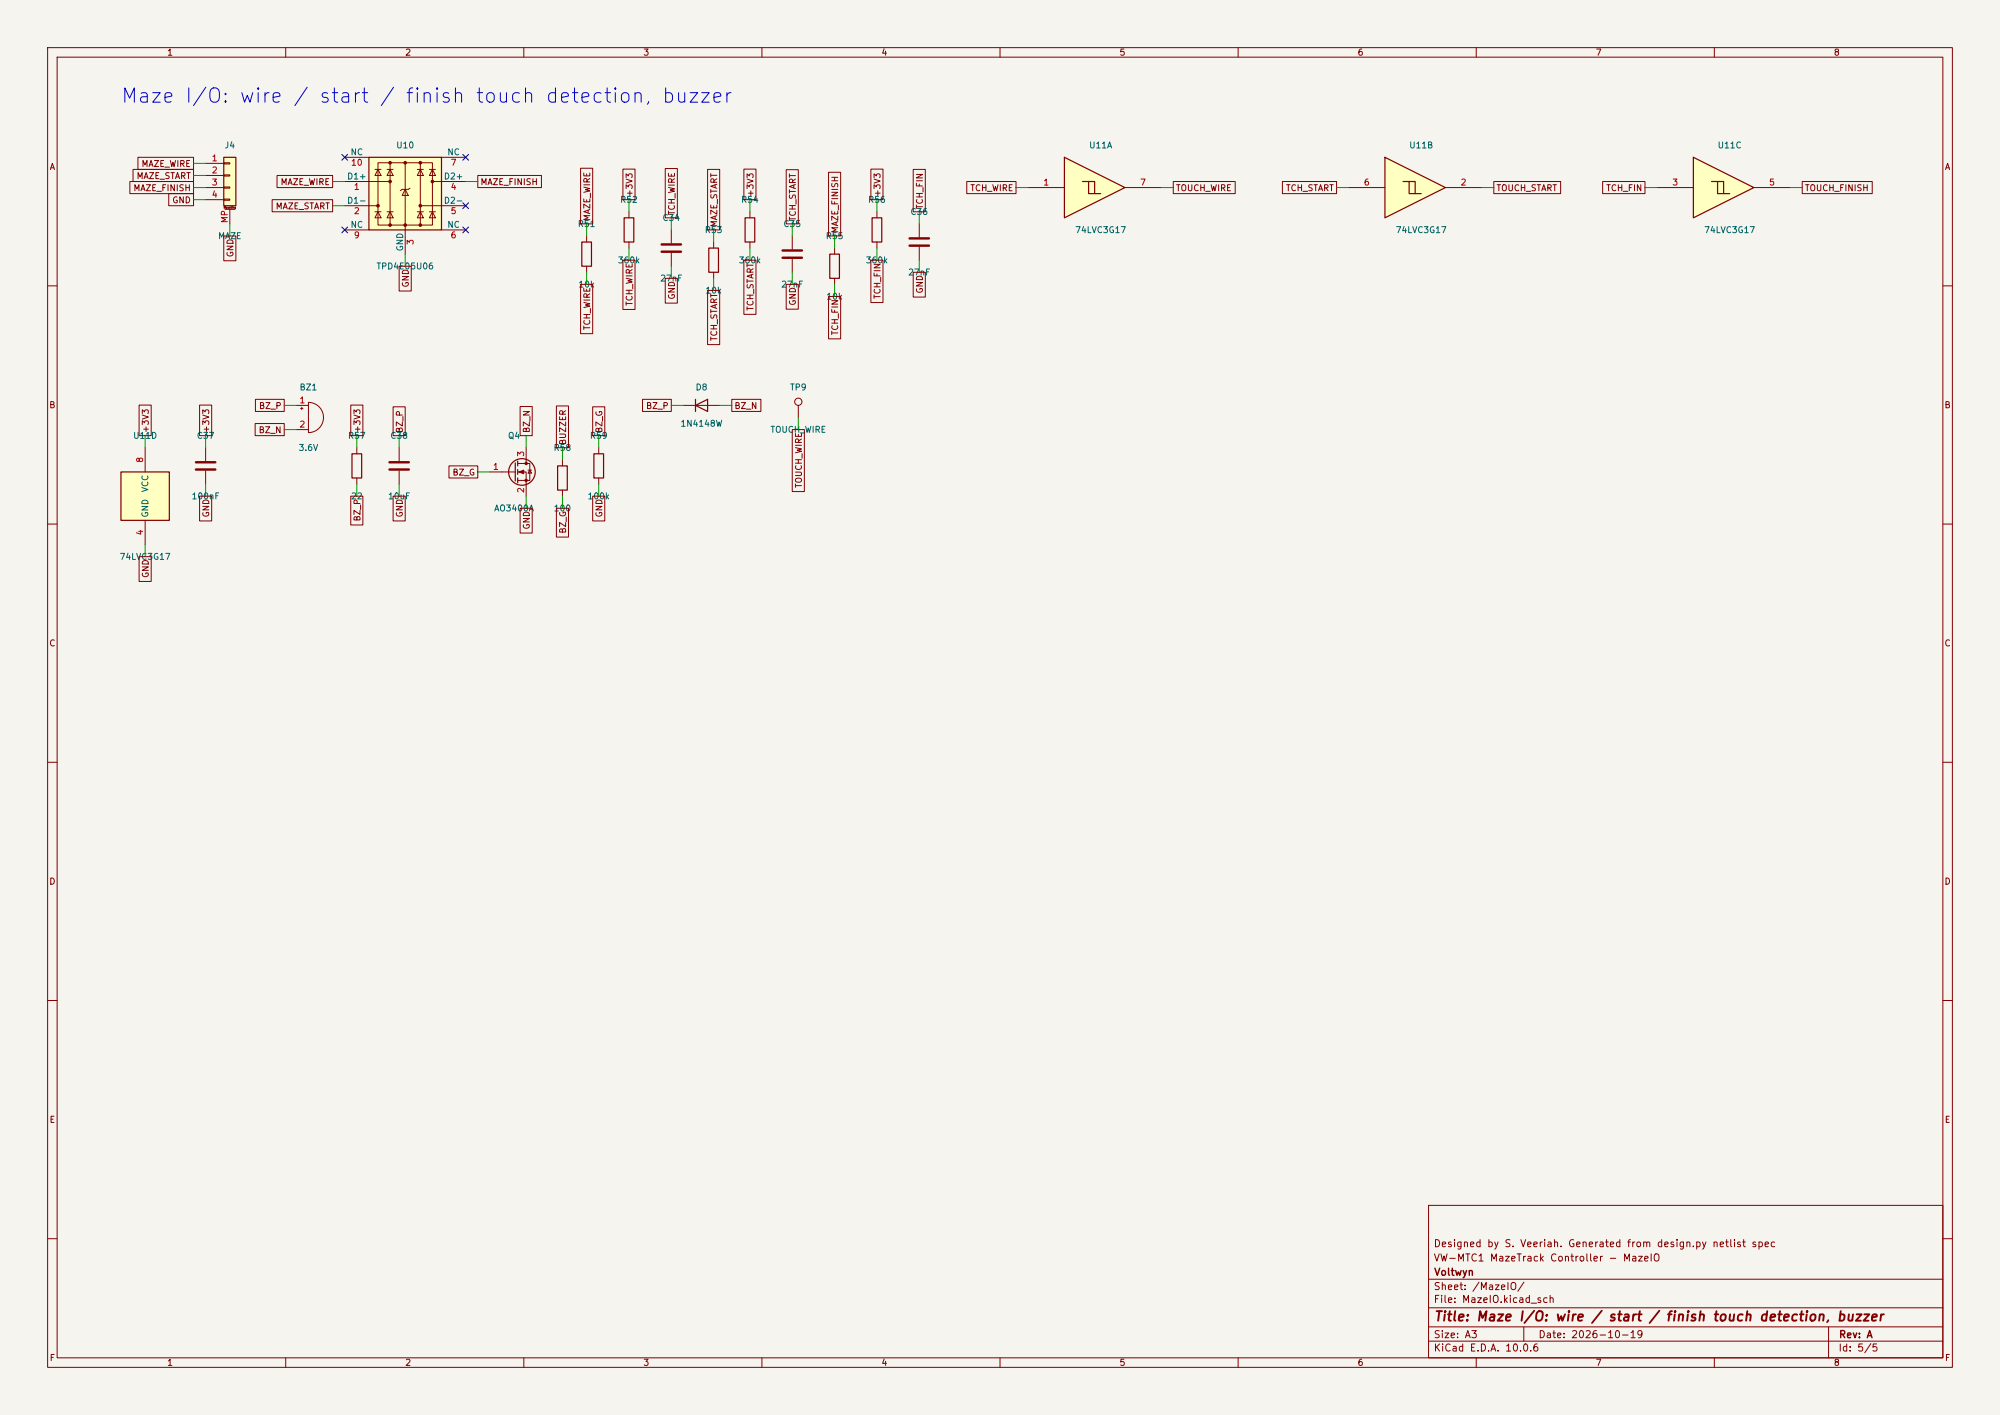
[picture p46: page 5]

Maze I/O: wire / start / finish touch detection, buzzer

Designed by S. Veeriah. Generated from design.py netlist spec
VW-MTC1 MazeTrack Controller - MazeIO
Voltwyn
Sheet: /MazeIO/
File: MazeIO.kicad_sch
Title: Maze I/O: wire / start / finish touch detection, buzzer
