Sajeevanveeriah/Ataxia-Monitor/VW-MTC1/Simulation/LTspice/sim01a_buckboost_startup_sch.asc

C28: cap; 10u; Rser=3m Lser=0.5n
C29: cap; 100n; Rser=10m
C30: cap; 10u; Rser=3m Lser=0.5n
C31: cap; 10u; Rser=3m Lser=0.5n
C32: cap; 47p; Rser=6.49k
C33: cap; 220p; Rser=49.9k
L1: ind; 4.7u; Rser=24m
R30: res; 1Meg
R31: res; 221k
Rload: res; 11
Rsrc: res; 50m
U4: LTC3536
Vbat: voltage; 3.7
Named nets: vsrc, 0, vin, sw1, sw2, out, fb, vc
SIM01a VW-MTC1 +3V3 buck-boost start-up (schematic version of sim01a_buckboost_startup.cir)
U4 LTC3536EMSE, L1 4.7 uH XFL4020-472 (24 mohm), COUT C30/C31 2 x 22 uF modelled 10 uF effective each (DC bias)
RT and SHDN tied to VIN (1.2 MHz), MODE = GND (PWM). VIN 3.7 V via 50 mohm, load 11 ohm (300 mA)
.tran 0 3m 0 startup
.meas TRAN vfinal AVG V(out) FROM 2.5m TO 3m
.meas TRAN t90 WHEN V(out)=2.9835 RISE=1
