Sajeevanveeriah/Ataxia-Monitor/VW-MTC1/Simulation/LTspice/sim03b_powerpath_unplug_revised.cir

* SIM03b - VW-MTC1 power path, USB unplug / replug - REJECTED ATTEMPT
* RESULT: this BAT54 gate-feed idea did NOT work. The gate still follows
* VBUS through the forward-biased BAT54 while VBUS decays slowly, so Q1
* stayed off exactly as in SIM03a. Kept for the record; the adopted fix is
* SIM03d (R43 = 2.2 k). The reasoning below was the (wrong) expectation.
* Voltwyn MazeTrack Controller VW-MTC1 simulation suite
*
* Purpose : USB 5 V is removed at t = 5 ms and reconnected at t = 15 ms
*           while the 3.3 V rail (U4 LTC3536, vw_3v3_buckboost.inc, PWM)
*           supplies 300 mA. Check VSYS minimum, +3V3 deviation (+/- 5 %),
*           Q1 turn-on delay and reverse current into VBUS when unplugged.
* Path    : USB source -> cable (100 mohm, 1 uH) -> S_USB (connector, models
*           plug/unplug; Roff = 100 Meg = open) -> VBUS
*           VBUS: C40 10 uF, sense divider R41/R42 100 k / 100 k
*           D40 1N5819 Schottky (standard.dio, OnSemi; 1 A rating chosen over
*               MBR0520L 0.5 A because VSYS draws up to ~0.5 A at 600 mA
*               3.3 V load; SOD-123 equivalent B5819W) VBUS -> VSYS
*           Q1 AO3401A P-MOSFET (vw_models.lib fit): drain = VBAT,
*               source = VSYS, gate fed from VBUS via D41 BAT54, R43 100 k gate to GND.
*               Body diode conducts VBAT -> VSYS when Q1 is off.
*           VSYS: C41 22 uF ceramic (10 uF effective, DC-bias assumption)
* REVISION: in SIM03a the Q1 gate sat directly on VBUS, which holds 10 uF
*           discharged only by R41+R42 || R43 (66.7 k): tau = 0.67 s, so Q1
*           stayed off for hundreds of ms and VSYS ran on the body diode
*           (2.95 V). Here the gate is fed from VBUS through D41 BAT54
*           (anode VBUS, cathode gate) and R43 100 k gate -> GND discharges
*           only the gate capacitance (~0.7 nF): Q1 turns on ~0.1 ms after
*           unplug. With USB present gate = VBUS - Vf(BAT54) >= VSYS = VBUS -
*           Vf(1N5819), so VGS ~ 0 V and Q1 stays off.
* Battery : 3.7 V ideal + 50 mohm.
* Not modelled: LTC4054 charger load on VBUS (it is fed from VBUS directly
*           and would only speed up the VBUS decay after unplug).
.lib LTC3536.sub
.include vw_3v3_buckboost.inc
.include vw_models.lib
.model 1N5819 D(Is=31.7u Rs=.051 N=1.373 Cjo=110p M=.35 Eg=.69 Xti=2 Iave=1 Vpk=40 mfg=OnSemi type=Schottky)
.model SWUSB SW(Ron=10m Roff=100Meg Vt=0.5 Vh=0)

Vusb   usb 0 5
Rcab   usb a1 100m
Lcab   a1 a2 1u Rpar=50
S_USB  a2 vbus plug 0 SWUSB
Vplug  plug 0 PWL(0 1 5m 1 5.0001m 0 15m 0 15.0001m 1)
C40    vbus 0 10u Rser=3m
R41    vbus vsense 100k
R42    vsense 0 100k
D40    vbus vsys 1N5819
D41    vbus gate BAT54
MQ1    vbat gate vsys vsys AO3401A
R43    gate 0 100k
.model BAT54 D(Is=.1u Rs=2.2 N=1 Cjo=12p M=.3 Eg=.69 Xti=2 Iave=300m Vpk=30 mfg=Vishay type=Schottky)
C41    vsys 0 10u Rser=3m
Vcell  cell 0 3.7
Rcell  cell vbat 50m
XBB    vsys out 0 ofilt vw_3v3_bb
Iload  out 0 300m

.save V(gate) V(vbus) V(vsys) V(vbat) V(out) V(ofilt) I(D40) Id(MQ1) I(Rcell) V(plug)
.tran 0 20m 0 startup
.meas TRAN vsys_usb AVG V(vsys) FROM 4.5m TO 5m
.meas TRAN vsys_min MIN V(vsys) FROM 5m TO 15m
.meas TRAN vsys_bat AVG V(vsys) FROM 14m TO 15m
.meas TRAN v3_min MIN V(ofilt) FROM 4m TO 20m
.meas TRAN v3_max MAX V(ofilt) FROM 4m TO 20m
.meas TRAN v3_nom AVG V(ofilt) FROM 4m TO 5m
.meas TRAN id_rev_min MIN I(D40) FROM 6m TO 15m
.meas TRAN id_rev_end AVG I(D40) FROM 14m TO 15m
.meas TRAN t_q1_on WHEN V(vbat)-V(vsys)=0.1 FALL=1 TD=5m
.meas TRAN vbus_end AVG V(vbus) FROM 14m TO 15m
.end
