Sajeevanveeriah/Ataxia-Monitor/VW-MTC1/Simulation/LTspice/sim04a_hall_afe_sch.asc

C51: cap; 100n
C52: cap; 47n
R50: res; 1Meg
R51: res; 10k
R52: res; 10k
Rsens: res; 100
U6: UniversalOpAmp2; Avol=4e5 GBW=1Meg Slew=0.6Meg; Ilimit=15m Rail=25m Vos=0
Vdd: voltage; 3.3
Vs: voltage; DC 1.65 AC 1
Named nets: hs, 0, hall, n1, n2, adc, vdd
SIM04a VW-MTC1 Hall front end, one channel (schematic version of sim04a_hall_afe_ac.cir)
SS49E modelled as 1.65 V + AC 1 V behind 100 ohm. R50 1 M pull-down, Sallen-Key LPF R51 = R52 = 10 k, C51 100 nF, C52 47 nF
U6 = MCP6004 class via UniversalOpAmp2 (GBW 1 MHz, 0.6 V/us, Avol 4e5, rail-to-rail). Expected fc 232 Hz, Q 0.73
.ac dec 200 1 10Meg
.meas AC f3db WHEN mag(V(adc))=0.70711 FALL=1
.meas AC g1k FIND mag(V(adc)) AT 1k
