Sajeevanveeriah/Ataxia-Monitor/VW-MTC1/Hardware/KiCad/VW-MTC1.kicad_pcb

## KiCad design VW-MTC1/Hardware/KiCad/VW-MTC1.kicad_pcb (2026-10-20)

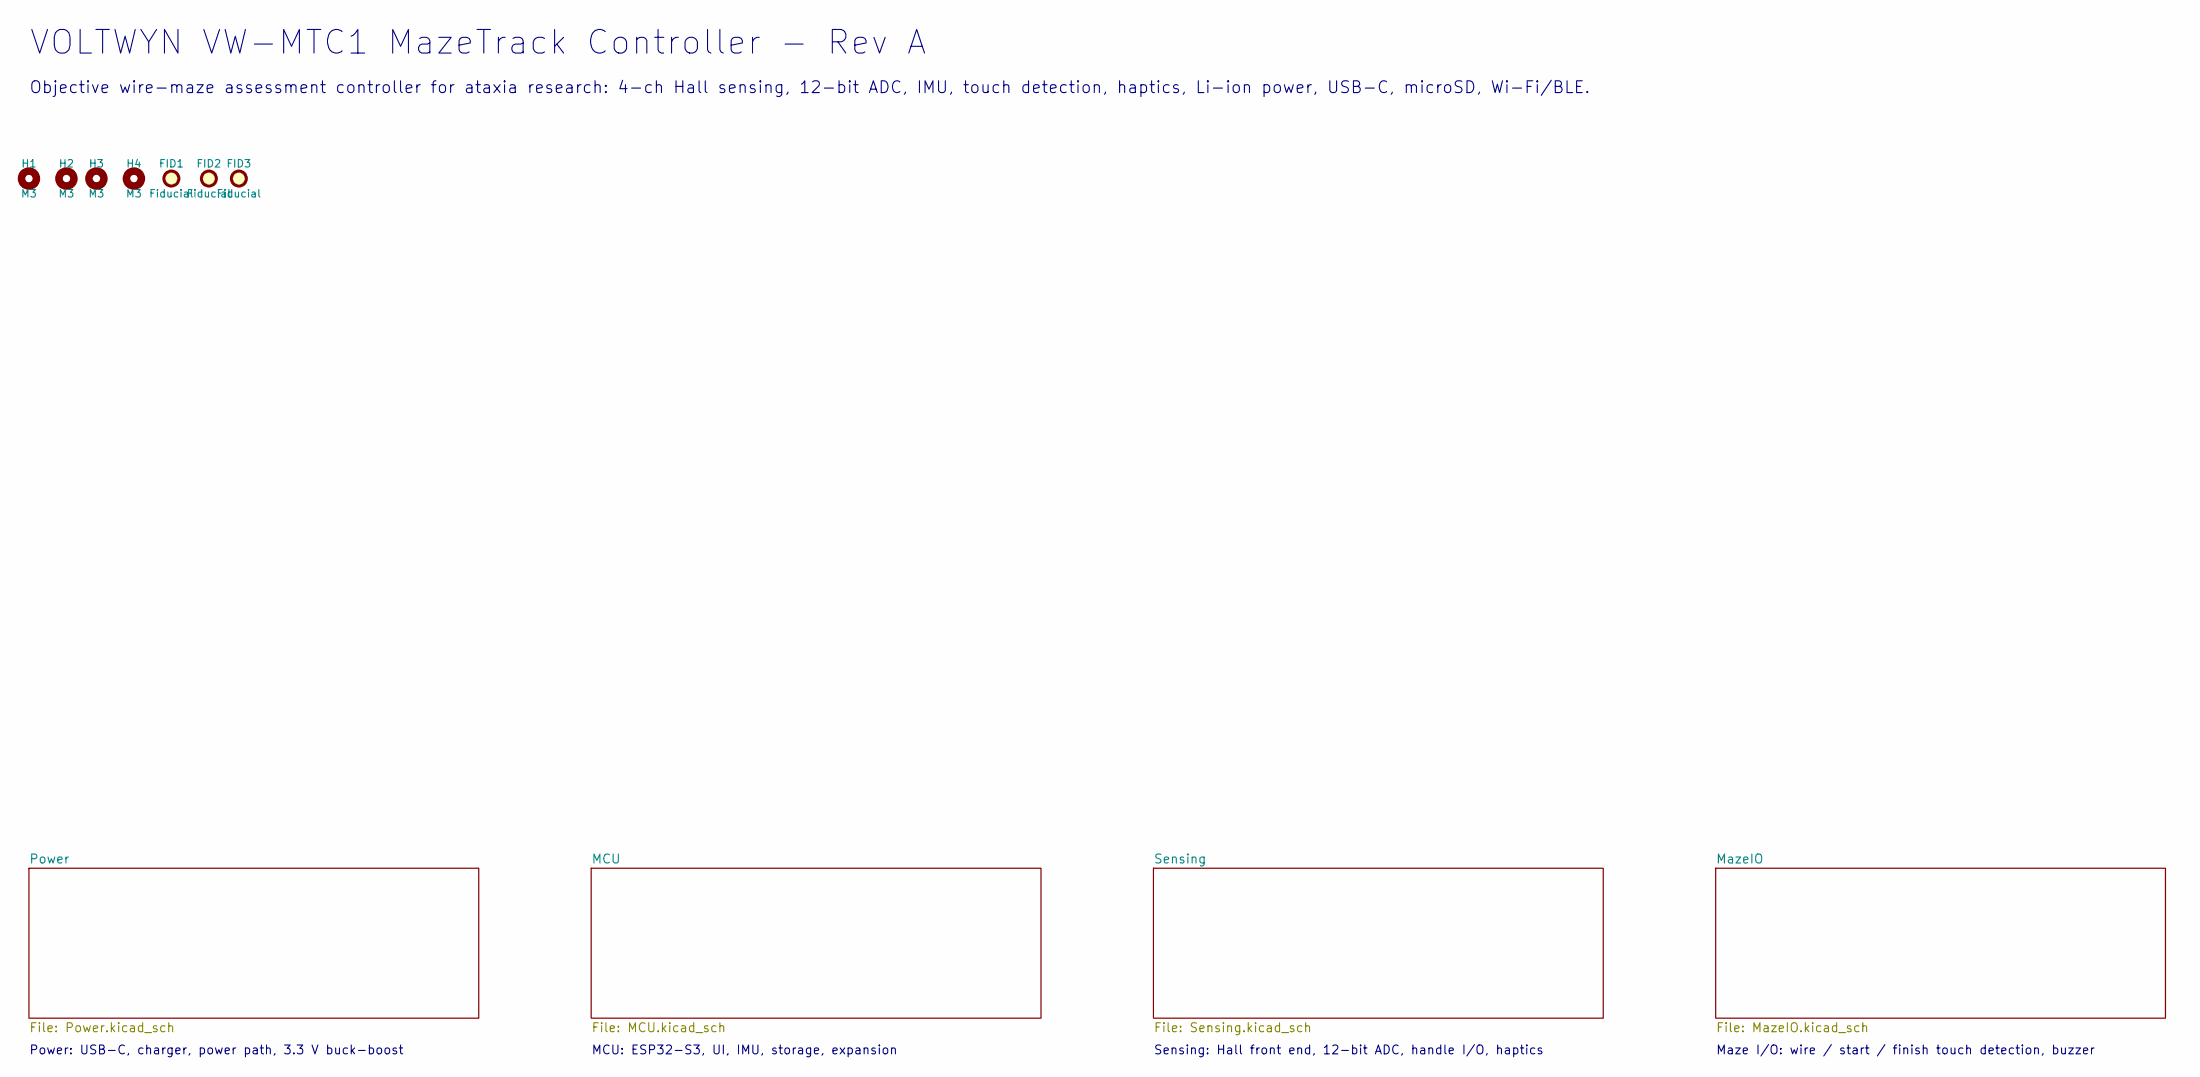
[picture p47: schematic VW-MTC1.kicad_sch, VW-MTC1 MazeTrack Controller - Top level]

Parts:
FID1, FID2, FID3: Fiducial; Fiducial_1mm_Mask2mm
H1, H2, H3, H4: M3; MountingHole_3.2mm_M3

Notes on the sheet:
VOLTWYN VW-MTC1 MazeTrack Controller - Rev A
Objective wire-maze assessment controller for ataxia research: 4-ch Hall sensing, 12-bit ADC, IMU, touch detection, haptics, Li-ion power, USB-C, microSD, Wi-Fi/BLE.
Power: USB-C, charger, power path, 3.3 V buck-boost
MCU: ESP32-S3, UI, IMU, storage, expansion
Sensing: Hall front end, 12-bit ADC, handle I/O, haptics
Maze I/O: wire / start / finish touch detection, buzzer

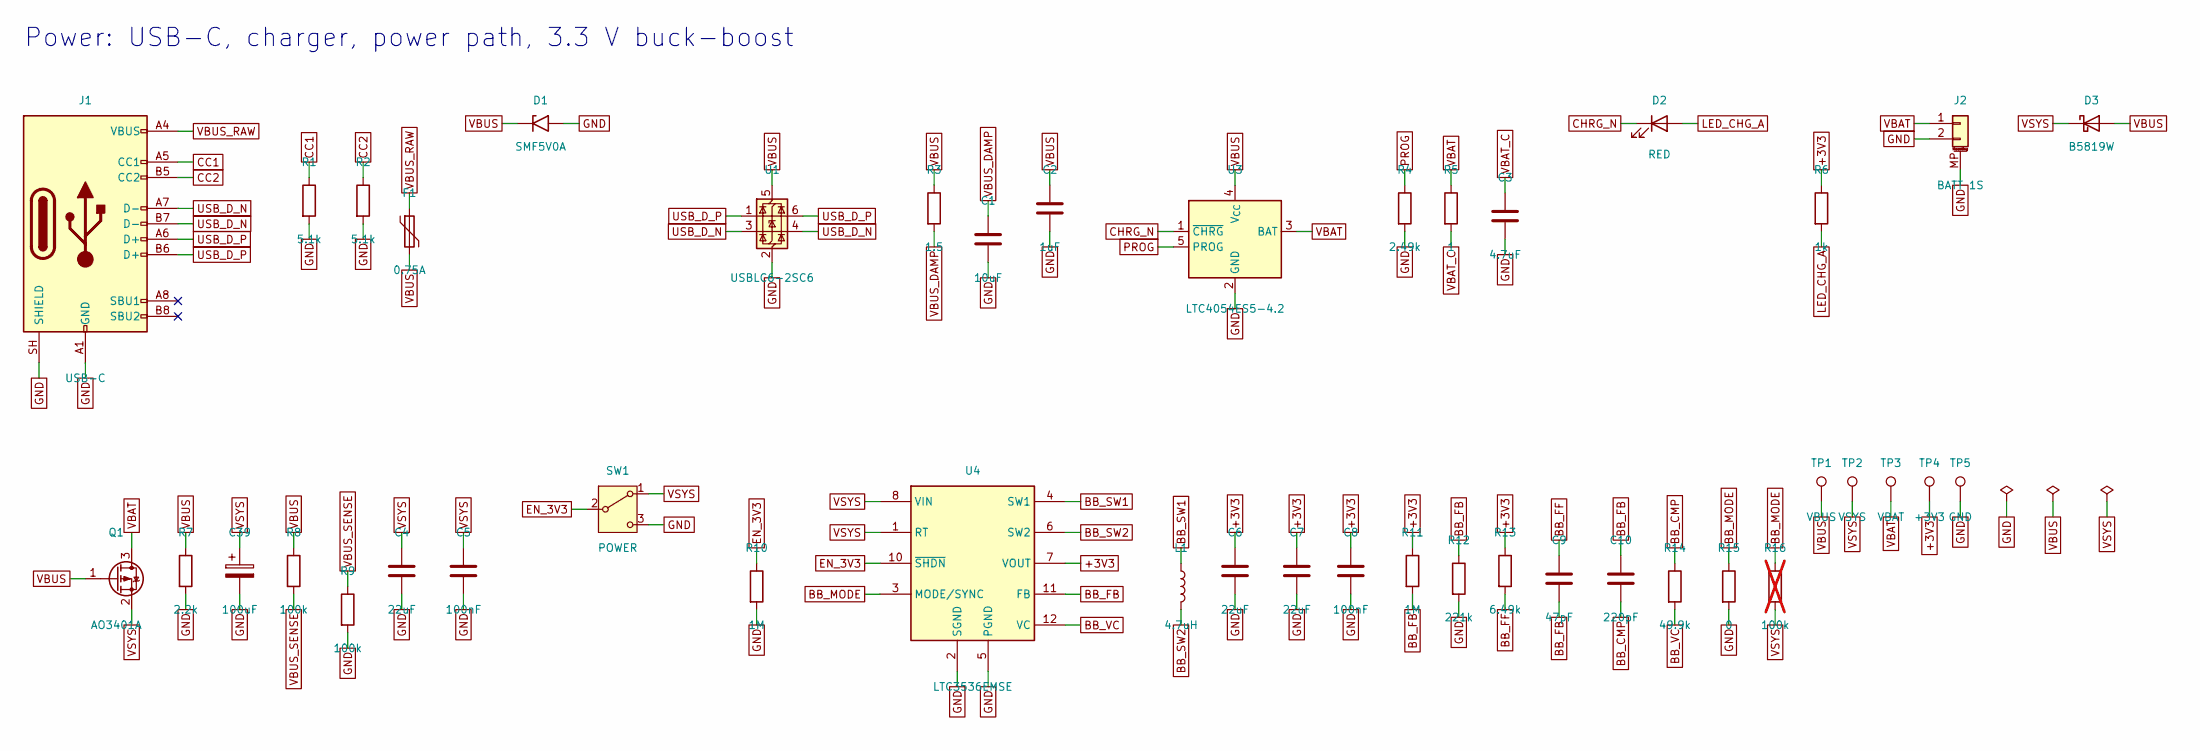
[picture p48: schematic Power.kicad_sch, Power: USB-C, charger, power path, 3.3 V buck-boost]

Parts:
C1: 10uF; C_0805_2012Metric; MPN GRM21BR61E106KA73L
C2: 1uF; C_0603_1608Metric; MPN GRM188R61E105KA12D
C3: 4.7uF; C_0805_2012Metric; MPN GRM21BR61C475KA88L
C4, C6, C7: 22uF; C_0805_2012Metric; MPN GRM21BR61A226ME44L
C5, C8: 100nF; C_0603_1608Metric; MPN GRM188R71H104KA93D
C9: 47pF; C_0603_1608Metric; MPN GRM1885C1H470JA01D
C10: 220pF; C_0603_1608Metric; MPN GRM1885C1H221JA01D
C39: 100uF; CP_EIA-3528-21_Kemet-B; MPN T520B107M006ATE070
D1: SMF5V0A; D_SMF; MPN SMF5V0A
D2: RED; LED_0603_1608Metric; MPN 150060RS75000
D3: B5819W; D_SOD-123; MPN B5819W
F1: 0.75A; Fuse_1206_3216Metric; MPN 1206L075THYR
J1: USB-C; USB_C_Receptacle_GCT_USB4105-xx-A_16P_TopMnt_Horizontal; MPN USB4105-GF-A
J2: BATT 1S; JST_PH_S2B-PH-SM4-TB_1x02-1MP_P2.00mm_Horizontal; MPN S2B-PH-SM4-TB(LF)(SN)
L1: 4.7uH; L_Coilcraft_XxL4020; MPN XFL4020-472MEC
Q1: AO3401A; SOT-23; MPN AO3401A
R1, R2: 5.1k; R_0603_1608Metric; MPN RC0603FR-075R1kL
R3: 1.5; R_0603_1608Metric; MPN RC0603FR-071R5L
R4: 2.49k; R_0603_1608Metric; MPN RC0603FR-072K49L
R5: 1; R_0603_1608Metric; MPN RC0603FR-071RL
R6: 1k; R_0603_1608Metric; MPN RC0603FR-071kL
R7: 2.2k; R_0603_1608Metric; MPN RC0603FR-072R2kL
R8, R9: 100k; R_0603_1608Metric; MPN RC0603FR-07100kL
R10, R11: 1M; R_0603_1608Metric; MPN RC0603FR-071ML
R12: 221k; R_0603_1608Metric; MPN RC0603FR-07221kL
R13: 6.49k; R_0603_1608Metric; MPN RC0603FR-076R49kL
R14: 49.9k; R_0603_1608Metric; MPN RC0603FR-0749R9kL
R15: 0; R_0603_1608Metric; MPN RC0603JR-070RL
R16: 100k; R_0603_1608Metric; MPN RC0603FR-07100kL; not fitted
SW1: POWER; SW_SPDT_PCM12; MPN PCM12SMTR
TP1: VBUS; TestPoint_Pad_D1.5mm
TP2: VSYS; TestPoint_Pad_D1.5mm
TP3: VBAT; TestPoint_Pad_D1.5mm
TP4: +3V3; TestPoint_Pad_D1.5mm
TP5: GND; TestPoint_Pad_D1.5mm
U1: USBLC6-2SC6; SOT-23-6; MPN USBLC6-2SC6
U3: LTC4054ES5-4.2; TSOT-23-5; MPN LTC4054ES5-4.2#TRPBF
U4: LTC3536EMSE; MSOP-12-1EP_3x4.039mm_P0.65mm_EP1.651x2.845mm_ThermalVias; MPN LTC3536EMSE#PBF

Connections:
+3V3: C6.1, C7.1, C8.1, R6.1, R11.1, R13.1, TP4.1, U4.7 (VOUT); also elsewhere on the board
BB_CMP: C10.2, R14.1
BB_FB: C9.2, C10.1, R11.2, R12.1, U4.11 (FB)
BB_FF: C9.1, R13.2
BB_MODE: R15.1, R16.1, U4.3 (MODE/SYNC)
BB_SW1: L1.1, U4.4 (SW1)
BB_SW2: L1.2, U4.6 (SW2)
BB_VC: R14.2, U4.12 (VC)
CC1: J1.A5 (CC1), R1.1
CC2: J1.B5 (CC2), R2.1
CHRG_N: D2.1 (K), U3.1 (~CHRG); also elsewhere on the board
EN_3V3: R10.1, SW1.2 (B), U4.10 (~SHDN)
GND: C1.2, C2.2, C3.2, C4.2, C5.2, C6.2, C7.2, C8.2, C39.2, D1.2 (A2), J1.A1 (GND), J1.A12 (GND), J1.B1 (GND), J1.B12 (GND), J1.SH (SHIELD), J2.2, J2.MP (MountPin), R1.2, R2.2, R4.2, R7.2, R9.2, R10.2, R12.2, R15.2, SW1.3 (C), TP5.1, U1.2 (GND), U3.2 (GND), U4.2 (SGND), U4.5 (PGND), U4.13 (PGND); also elsewhere on the board
LED_CHG_A: D2.2 (A), R6.2
PROG: R4.1, U3.5 (PROG)
USB_D_N: J1.A7 (D-), J1.B7 (D-), U1.3 (I/O2), U1.4 (I/O2); also elsewhere on the board
USB_D_P: J1.A6 (D+), J1.B6 (D+), U1.1 (I/O1), U1.6 (I/O1); also elsewhere on the board
VBAT: J2.1, Q1.3 (D), R5.1, TP3.1, U3.3 (BAT); also elsewhere on the board
VBAT_C: C3.1, R5.2
VBUS: C2.1, D1.1 (A1), D3.2 (A), F1.2, Q1.1 (G), R3.1, R7.1, R8.1, TP1.1, U1.5 (VBUS), U3.4 (V_{CC})
VBUS_DAMP: C1.1, R3.2
VBUS_RAW: F1.1, J1.A4 (VBUS), J1.A9 (VBUS), J1.B4 (VBUS), J1.B9 (VBUS)
VBUS_SENSE: R8.2, R9.1; also elsewhere on the board
VSYS: C4.1, C5.1, C39.1, D3.1 (K), Q1.2 (S), R16.2, SW1.1 (A), TP2.1, U4.1 (RT), U4.8 (VIN), U4.9 (VIN); also elsewhere on the board

Notes on the sheet:
Power: USB-C, charger, power path, 3.3 V buck-boost

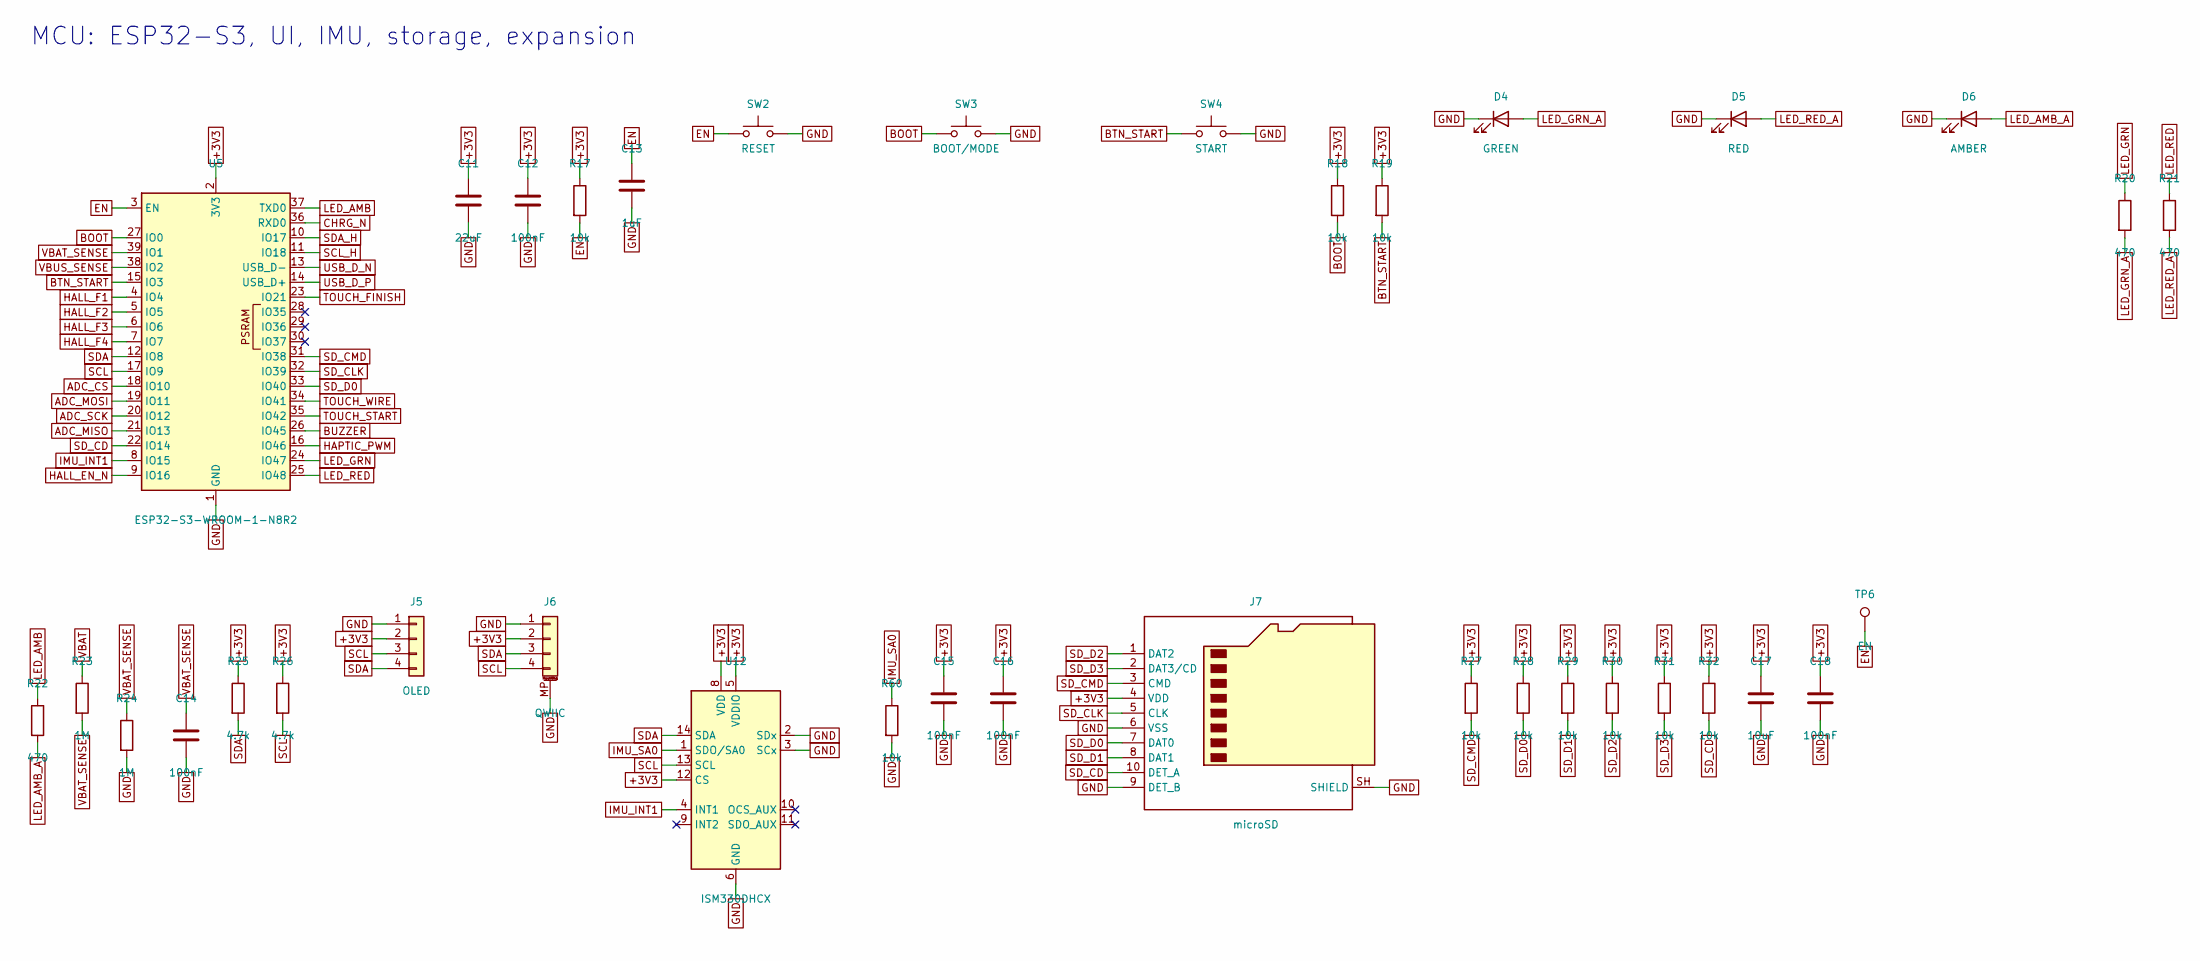
[picture p49: schematic MCU.kicad_sch, MCU: ESP32-S3, UI, IMU, storage, expansion]

Parts:
C11: 22uF; C_0805_2012Metric; MPN GRM21BR61A226ME44L
C12, C14, C15, C16, C18: 100nF; C_0603_1608Metric; MPN GRM188R71H104KA93D
C13: 1uF; C_0603_1608Metric; MPN GRM188R61E105KA12D
C17: 10uF; C_0805_2012Metric; MPN GRM21BR61E106KA73L
D4: GREEN; LED_0603_1608Metric; MPN 150060GS75000
D5: RED; LED_0603_1608Metric; MPN 150060RS75000
D6: AMBER; LED_0603_1608Metric; MPN 150060AS75000
J5: OLED; PinHeader_1x04_P2.54mm_Vertical; MPN PH1-04-UA
J6: QWIIC; JST_SH_SM04B-SRSS-TB_1x04-1MP_P1.00mm_Horizontal; MPN SM04B-SRSS-TB(LF)(SN)
J7: microSD; microSD_HC_Hirose_DM3AT-SF-PEJM5; MPN DM3AT-SF-PEJM5
R17, R18, R19, R27, R28, R29, R30, R31, R32, R60: 10k; R_0603_1608Metric; MPN RC0603FR-0710kL
R20, R21, R22: 470; R_0603_1608Metric; MPN RC0603FR-07470L
R23, R24: 1M; R_0603_1608Metric; MPN RC0603FR-071ML
R25, R26: 4.7k; R_0603_1608Metric; MPN RC0603FR-074R7kL
SW2: RESET; SW_SPST_TL3342; MPN TL3342F160QG
SW3: BOOT/MODE; SW_SPST_TL3342; MPN TL3342F160QG
SW4: START; SW_SPST_TL3342; MPN TL3342F160QG
TP6: EN; TestPoint_Pad_D1.5mm
U5: ESP32-S3-WROOM-1-N8R2; ESP32-S3-WROOM-1; MPN ESP32-S3-WROOM-1-N8R2
U12: ISM330DHCX; LGA-14_3x2.5mm_P0.5mm_LayoutBorder3x4y; MPN ISM330DHCXTR

Connections:
+3V3: C11.1, C12.1, C15.1, C16.1, C17.1, C18.1, J5.2, J6.2, J7.4 (VDD), R17.1, R18.1, R19.1, R25.1, R26.1, R27.1, R28.1, R29.1, R30.1, R31.1, R32.1, U5.2 (3V3), U12.5 (VDDIO), U12.8 (VDD), U12.12 (CS); also elsewhere on the board
ADC_CS: U5.18 (IO10); also elsewhere on the board
ADC_MISO: U5.21 (IO13); also elsewhere on the board
ADC_MOSI: U5.19 (IO11); also elsewhere on the board
ADC_SCK: U5.20 (IO12); also elsewhere on the board
BOOT: R18.2, SW3.1, U5.27 (IO0)
BTN_START: R19.2, SW4.1, U5.15 (IO3)
BUZZER: U5.26 (IO45); also elsewhere on the board
CHRG_N: U5.36 (RXD0); also elsewhere on the board
EN: C13.1, R17.2, SW2.1, TP6.1, U5.3 (EN)
GND: C11.2, C12.2, C13.2, C14.2, C15.2, C16.2, C17.2, C18.2, D4.1 (K), D5.1 (K), D6.1 (K), J5.1, J6.1, J6.MP (MountPin), J7.6 (VSS), J7.9 (DET_B), J7.SH (SHIELD), R24.2, R60.2, SW2.2, SW3.2, SW4.2, U5.1 (GND), U5.40 (GND), U5.41 (GND), U12.2 (SDx), U12.3 (SCx), U12.6 (GND), U12.7 (GND); also elsewhere on the board
HALL_EN_N: U5.9 (IO16); also elsewhere on the board
HALL_F1: U5.4 (IO4); also elsewhere on the board
HALL_F2: U5.5 (IO5); also elsewhere on the board
HALL_F3: U5.6 (IO6); also elsewhere on the board
HALL_F4: U5.7 (IO7); also elsewhere on the board
HAPTIC_PWM: U5.16 (IO46); also elsewhere on the board
IMU_INT1: U5.8 (IO15), U12.4 (INT1)
IMU_SA0: R60.1, U12.1 (SDO/SA0)
LED_AMB: R22.1, U5.37 (TXD0)
LED_AMB_A: D6.2 (A), R22.2
LED_GRN: R20.1, U5.24 (IO47)
LED_GRN_A: D4.2 (A), R20.2
LED_RED: R21.1, U5.25 (IO48)
LED_RED_A: D5.2 (A), R21.2
SCL: J5.3, J6.4, R26.2, U5.17 (IO9), U12.13 (SCL)
SCL_H: U5.11 (IO18); also elsewhere on the board
SDA: J5.4, J6.3, R25.2, U5.12 (IO8), U12.14 (SDA)
SDA_H: U5.10 (IO17); also elsewhere on the board
SD_CD: J7.10 (DET_A), R32.2, U5.22 (IO14)
SD_CLK: J7.5 (CLK), U5.32 (IO39)
SD_CMD: J7.3 (CMD), R27.2, U5.31 (IO38)
SD_D0: J7.7 (DAT0), R28.2, U5.33 (IO40)
SD_D1: J7.8 (DAT1), R29.2
SD_D2: J7.1 (DAT2), R30.2
SD_D3: J7.2 (DAT3/CD), R31.2
TOUCH_FINISH: U5.23 (IO21); also elsewhere on the board
TOUCH_START: U5.35 (IO42); also elsewhere on the board
TOUCH_WIRE: U5.34 (IO41); also elsewhere on the board
USB_D_N: U5.13 (USB_D-); also elsewhere on the board
USB_D_P: U5.14 (USB_D+); also elsewhere on the board
VBAT: R23.1; also elsewhere on the board
VBAT_SENSE: C14.1, R23.2, R24.1, U5.39 (IO1)
VBUS_SENSE: U5.38 (IO2); also elsewhere on the board

Notes on the sheet:
MCU: ESP32-S3, UI, IMU, storage, expansion

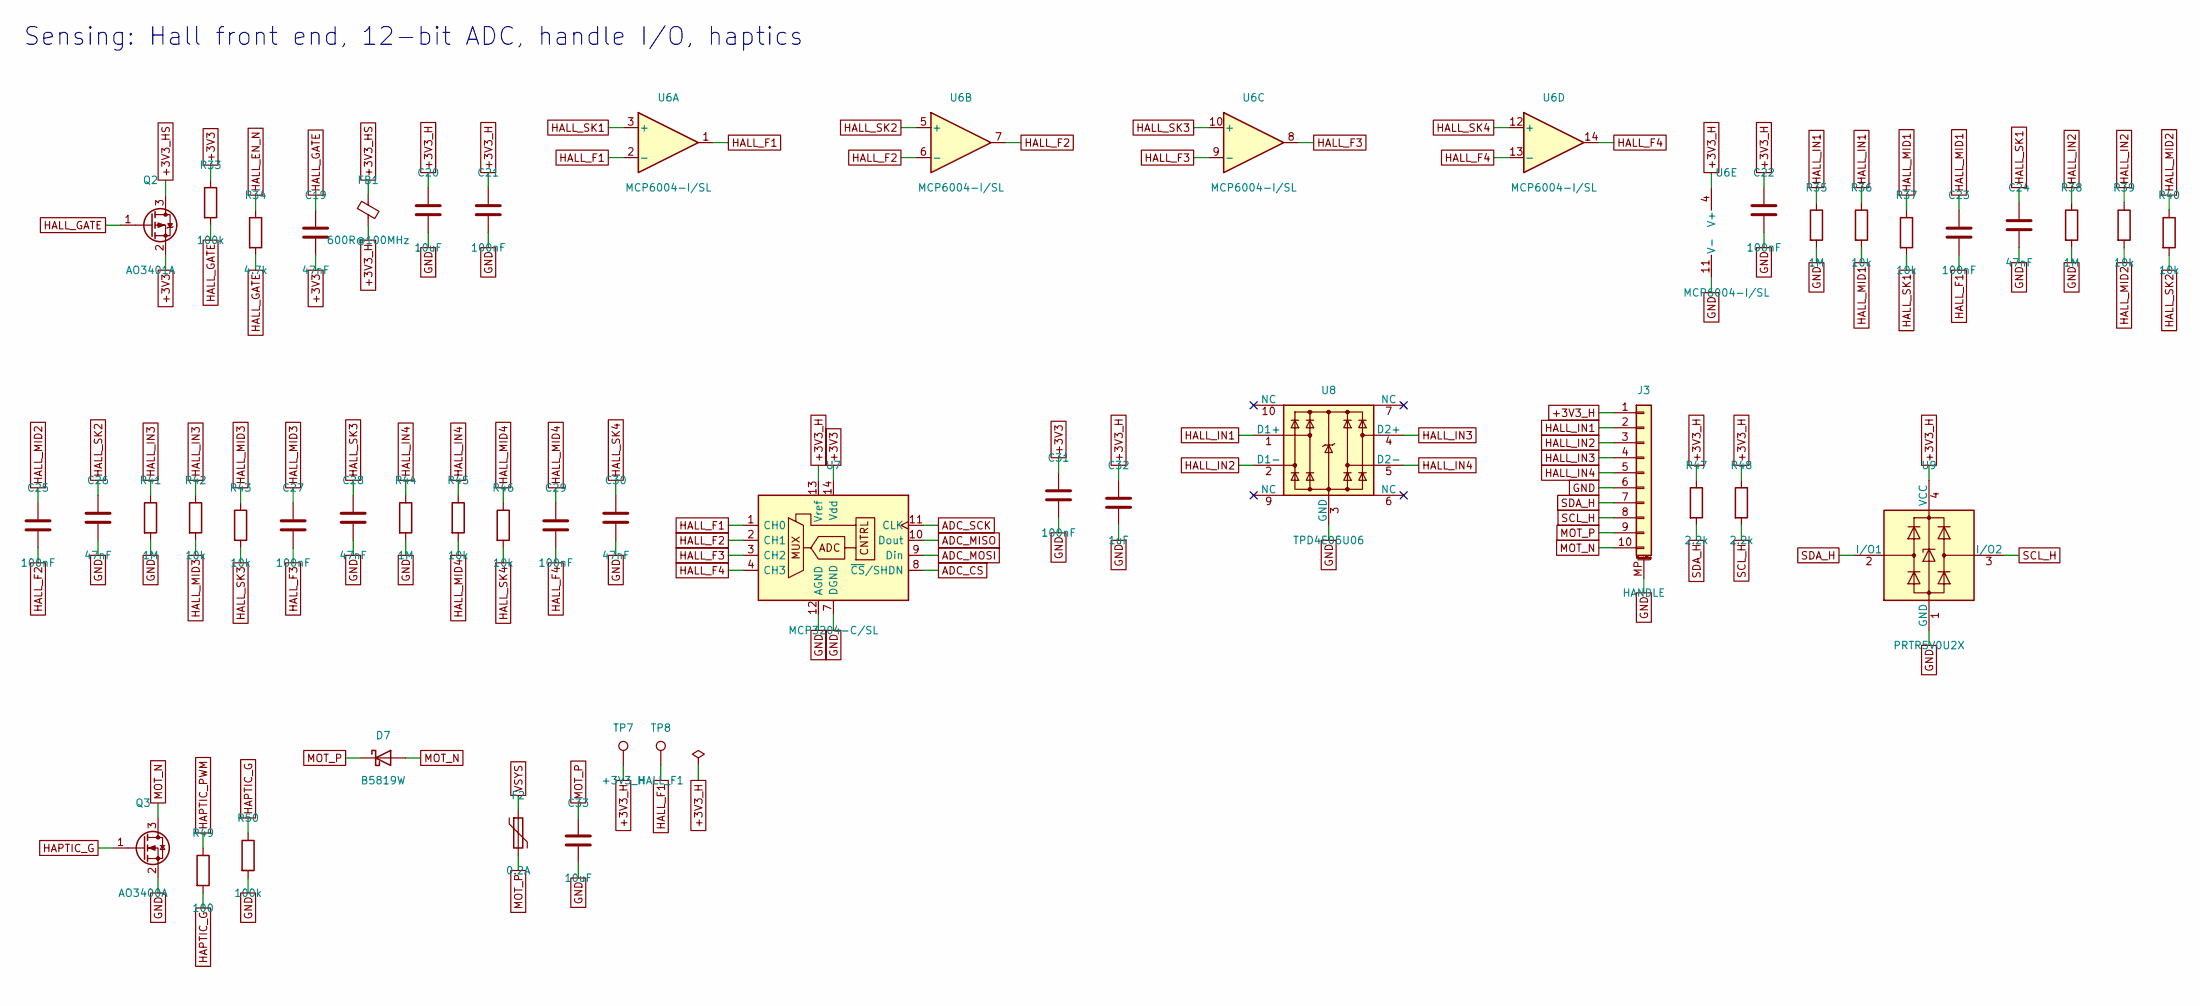
[picture p50: schematic Sensing.kicad_sch, Sensing: Hall front end, 12-bit ADC, handle I/O, haptics]

Parts:
C19: 47nF; C_0603_1608Metric; MPN GRM188R71H473KA61D
C20, C33: 10uF; C_0805_2012Metric; MPN GRM21BR61E106KA73L
C21, C22, C31: 100nF; C_0603_1608Metric; MPN GRM188R71H104KA93D
C23, C25, C27, C29: 100nF; C_0805_2012Metric; MPN GCM21B5C1H104JA16L
C24, C26, C28, C30: 47nF; C_0805_2012Metric; MPN GRM2195C1H473JA01D
C32: 1uF; C_0603_1608Metric; MPN GRM188R61E105KA12D
D7: B5819W; D_SOD-123; MPN B5819W
F2: 0.2A; Fuse_0805_2012Metric; MPN 0805L020WR
FB1: 600R@100MHz; L_0603_1608Metric; MPN BLM18PG601SN1D
J3: HANDLE; JST_GH_SM10B-GHS-TB_1x10-1MP_P1.25mm_Horizontal; MPN SM10B-GHS-TB(LF)(SN)
Q2: AO3401A; SOT-23; MPN AO3401A
Q3: AO3400A; SOT-23; MPN AO3400A
R33, R50: 100k; R_0603_1608Metric; MPN RC0603FR-07100kL
R34: 4.7k; R_0603_1608Metric; MPN RC0603FR-074R7kL
R35, R38, R41, R44: 1M; R_0603_1608Metric; MPN RC0603FR-071ML
R36, R37, R39, R40, R42, R43, R45, R46: 10k; R_0603_1608Metric; MPN RC0603FR-0710kL
R47, R48: 2.2k; R_0603_1608Metric; MPN RC0603FR-072R2kL
R49: 100; R_0603_1608Metric; MPN RC0603FR-07100L
TP7: +3V3_H; TestPoint_Pad_D1.5mm
TP8: HALL_F1; TestPoint_Pad_D1.5mm
U6: MCP6004-I/SL; SOIC-14_3.9x8.7mm_P1.27mm; MPN MCP6004T-I/SL
U7: MCP3204-C/SL; SOIC-14_3.9x8.7mm_P1.27mm; MPN MCP3204-CI/SL
U8: TPD4E05U06; USON-10_2.5x1.0mm_P0.5mm; MPN TPD4E05U06DQAR
U9: PRTR5V0U2X; SOT-143; MPN PRTR5V0U2X,215

Connections:
+3V3: C19.2, C31.1, Q2.2 (S), R33.1, U7.14 (Vdd); also elsewhere on the board
+3V3_H: C20.1, C21.1, C22.1, C32.1, FB1.2, J3.1, R47.1, R48.1, TP7.1, U6.4 (V+), U7.13 (Vref), U9.4 (VCC)
+3V3_HS: FB1.1, Q2.3 (D)
ADC_CS: U7.8 (~CS/SHDN); also elsewhere on the board
ADC_MISO: U7.10 (Dout); also elsewhere on the board
ADC_MOSI: U7.9 (Din); also elsewhere on the board
ADC_SCK: U7.11 (CLK); also elsewhere on the board
GND: C20.2, C21.2, C22.2, C24.2, C26.2, C28.2, C30.2, C31.2, C32.2, C33.2, J3.6, J3.MP (MountPin), Q3.2 (S), R35.2, R38.2, R41.2, R44.2, R50.2, U6.11 (V-), U7.7 (DGND), U7.12 (AGND), U8.3 (GND), U8.8 (GND), U9.1 (GND); also elsewhere on the board
HALL_EN_N: R34.1; also elsewhere on the board
HALL_F1: C23.2, TP8.1, U6.1, U6.2 (-), U7.1 (CH0); also elsewhere on the board
HALL_F2: C25.2, U6.6 (-), U6.7, U7.2 (CH1); also elsewhere on the board
HALL_F3: C27.2, U6.8, U6.9 (-), U7.3 (CH2); also elsewhere on the board
HALL_F4: C29.2, U6.13 (-), U6.14, U7.4 (CH3); also elsewhere on the board
HALL_GATE: C19.1, Q2.1 (G), R33.2, R34.2
HALL_IN1: J3.2, R35.1, R36.1, U8.1 (D1+)
HALL_IN2: J3.3, R38.1, R39.1, U8.2 (D1-)
HALL_IN3: J3.4, R41.1, R42.1, U8.4 (D2+)
HALL_IN4: J3.5, R44.1, R45.1, U8.5 (D2-)
HALL_MID1: C23.1, R36.2, R37.1
HALL_MID2: C25.1, R39.2, R40.1
HALL_MID3: C27.1, R42.2, R43.1
HALL_MID4: C29.1, R45.2, R46.1
HALL_SK1: C24.1, R37.2, U6.3 (+)
HALL_SK2: C26.1, R40.2, U6.5 (+)
HALL_SK3: C28.1, R43.2, U6.10 (+)
HALL_SK4: C30.1, R46.2, U6.12 (+)
HAPTIC_G: Q3.1 (G), R49.2, R50.1
HAPTIC_PWM: R49.1; also elsewhere on the board
MOT_N: D7.2 (A), J3.10, Q3.3 (D)
MOT_P: C33.1, D7.1 (K), F2.2, J3.9
SCL_H: J3.8, R48.2, U9.3 (I/O2); also elsewhere on the board
SDA_H: J3.7, R47.2, U9.2 (I/O1); also elsewhere on the board
VSYS: F2.1; also elsewhere on the board

Notes on the sheet:
Sensing: Hall front end, 12-bit ADC, handle I/O, haptics

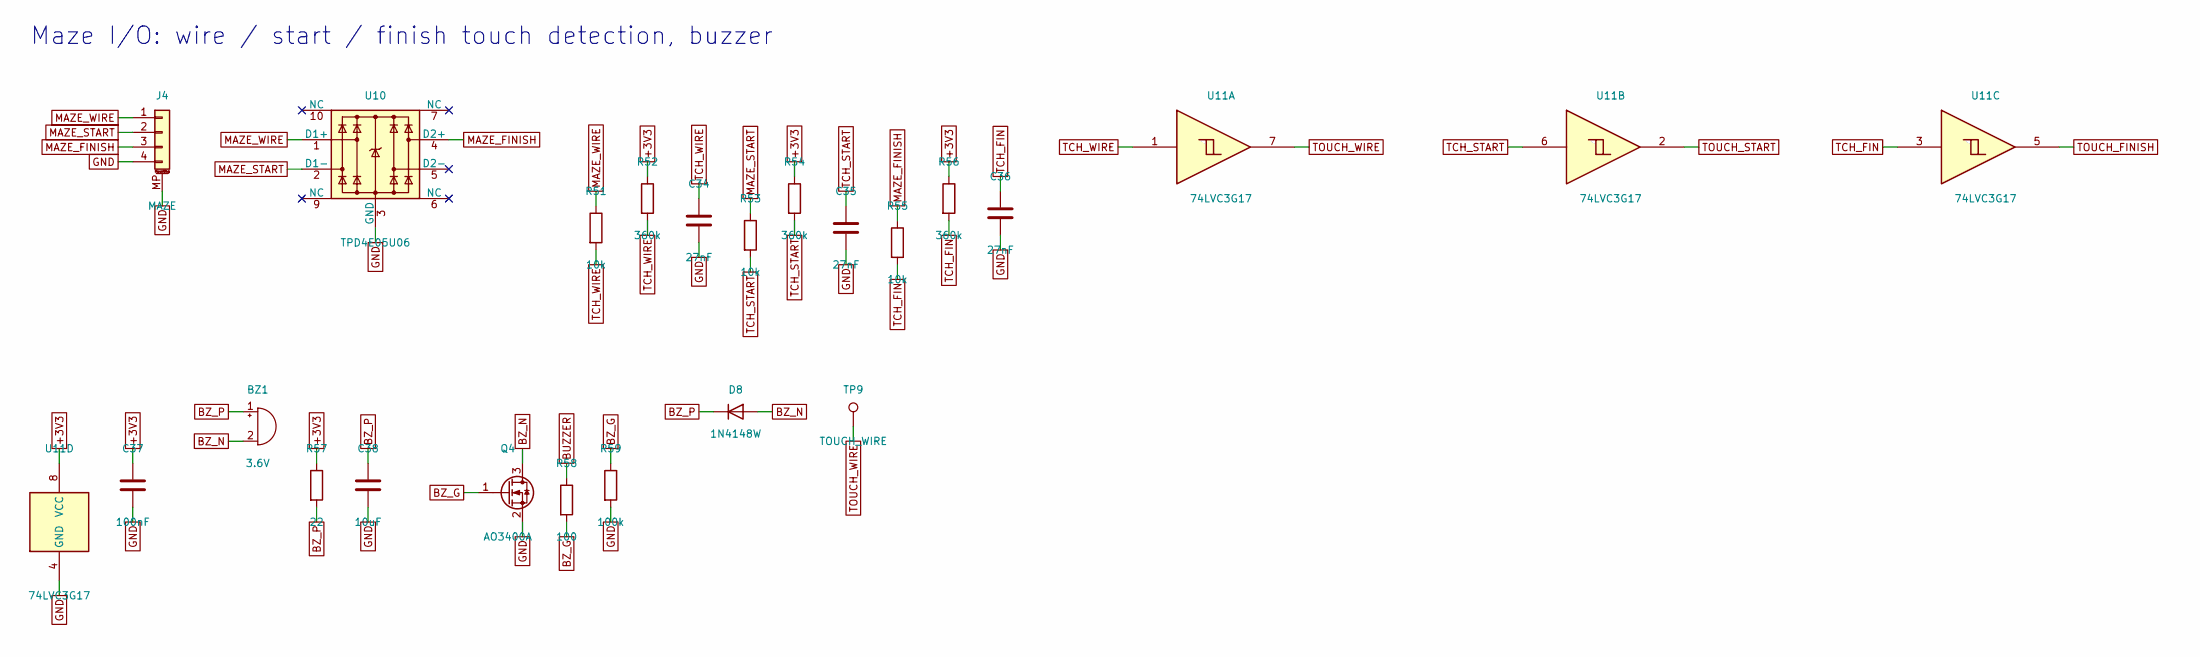
[picture p51: schematic MazeIO.kicad_sch, Maze I/O: wire / start / finish touch detection, buzzer]

Parts:
BZ1: 3.6V; MagneticBuzzer_CUI_CMT-8504-100-SMT; MPN CMT-8504-100-SMT-TR
C34, C35, C36: 27nF; C_0603_1608Metric; MPN GRM188R71H273KA01D
C37: 100nF; C_0603_1608Metric; MPN GRM188R71H104KA93D
C38: 10uF; C_0805_2012Metric; MPN GRM21BR61E106KA73L
D8: 1N4148W; D_SOD-123; MPN 1N4148W-7-F
J4: MAZE; JST_PH_S4B-PH-SM4-TB_1x04-1MP_P2.00mm_Horizontal; MPN S4B-PH-SM4-TB(LF)(SN)
Q4: AO3400A; SOT-23; MPN AO3400A
R51, R53, R55: 10k; R_0603_1608Metric; MPN RC0603FR-0710kL
R52, R54, R56: 360k; R_0603_1608Metric; MPN RC0603FR-07360kL
R57: 22; R_0805_2012Metric; MPN RC0805FR-0722RL
R58: 100; R_0603_1608Metric; MPN RC0603FR-07100L
R59: 100k; R_0603_1608Metric; MPN RC0603FR-07100kL
TP9: TOUCH_WIRE; TestPoint_Pad_D1.5mm
U10: TPD4E05U06; USON-10_2.5x1.0mm_P0.5mm; MPN TPD4E05U06DQAR
U11: 74LVC3G17; VSSOP-8_2.3x2mm_P0.5mm; MPN SN74LVC3G17DCUR

Connections:
+3V3: C37.1, R52.1, R54.1, R56.1, R57.1, U11.8 (VCC); also elsewhere on the board
BUZZER: R58.1; also elsewhere on the board
BZ_G: Q4.1 (G), R58.2, R59.1
BZ_N: BZ1.2 (-), D8.2 (A), Q4.3 (D)
BZ_P: BZ1.1 (+), C38.1, D8.1 (K), R57.2
GND: C34.2, C35.2, C36.2, C37.2, C38.2, J4.4, J4.MP (MountPin), Q4.2 (S), R59.2, U10.3 (GND), U10.8 (GND), U11.4 (GND); also elsewhere on the board
MAZE_FINISH: J4.3, R55.1, U10.4 (D2+)
MAZE_START: J4.2, R53.1, U10.2 (D1-)
MAZE_WIRE: J4.1, R51.1, U10.1 (D1+)
TCH_FIN: C36.1, R55.2, R56.2, U11.3
TCH_START: C35.1, R53.2, R54.2, U11.6
TCH_WIRE: C34.1, R51.2, R52.2, U11.1
TOUCH_FINISH: U11.5; also elsewhere on the board
TOUCH_START: U11.2; also elsewhere on the board
TOUCH_WIRE: TP9.1, U11.7; also elsewhere on the board

Notes on the sheet:
Maze I/O: wire / start / finish touch detection, buzzer

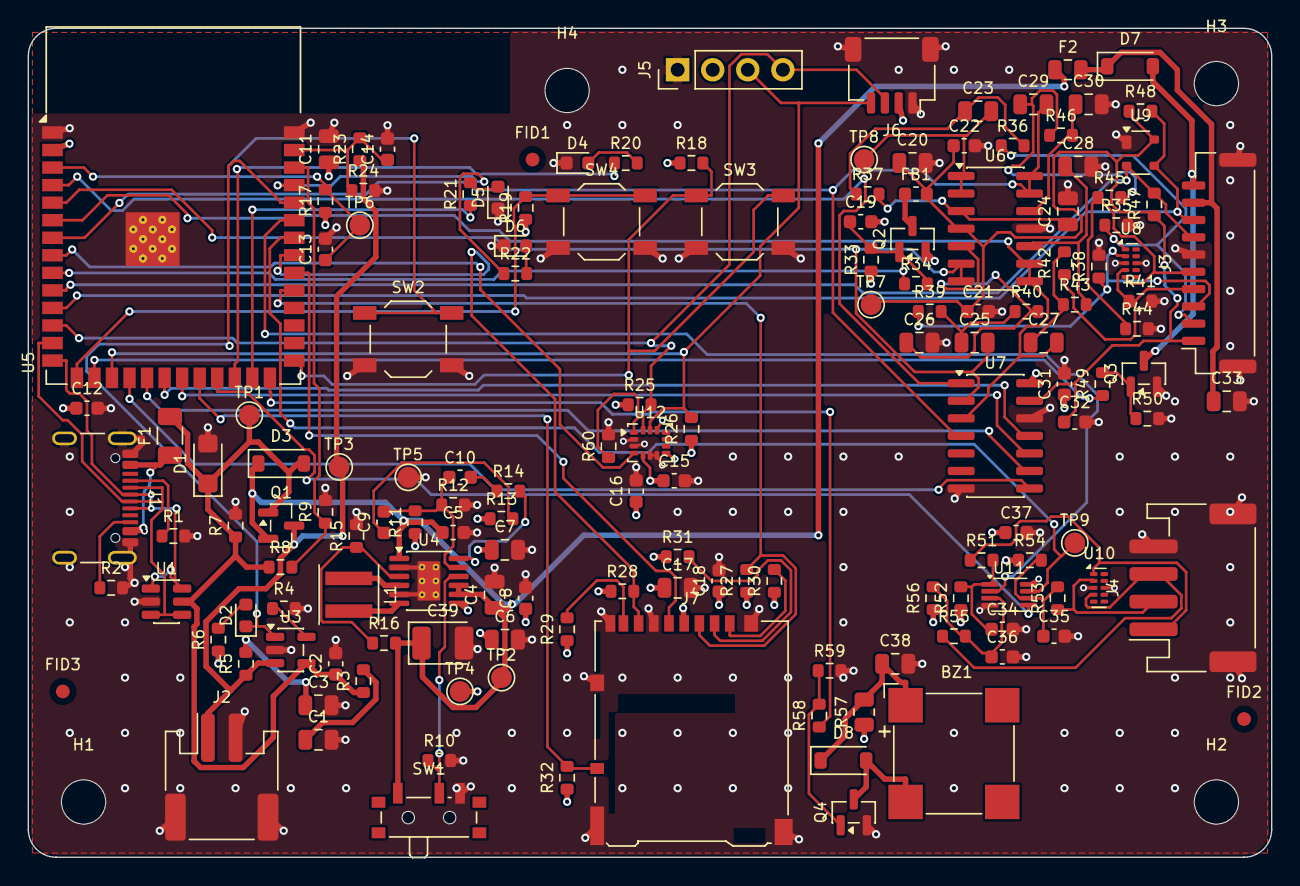
[picture p52: board VW-MTC1.kicad_pcb from above]

Board: 4 copper layers, 90.0 x 60.0 mm, 154 parts (0 on the bottom side), 88 nets.
