Sajeevanveeriah/Ataxia-Monitor/(commit log)

2025-10-11 Add Android app for ataxia sensor monitoring
2026-09-01 Improve README and maintenance documentation
    * Clarify sensor architecture and assumptions
    * Document sensor fusion assumptions
    * Document sensor collection lifecycle
    * Document repository session ownership
    * Document application dependency ownership
    * Document UI state composition
    * Document Compose screen responsibilities
    * Document Room database lifecycle
    * Document persisted session record
    * Document persisted sensor sample model
    * Document session query contracts
    * Document sensor sample persistence
2026-10-20 Add VW-MTC1 controller design and simulation baseline
    [20261019-VW-MTC1-3D-Model-Rev00.step, 20261019-VW-MTC1-BOM-Rev00.csv, 20261019-VW-MTC1-PickPlace-Rev00.csv, MCU.kicad_sch, MazeIO.kicad_sch, Power.kicad_sch, Sensing.kicad_sch, VW-MTC1.kicad_pcb]
2026-10-20 Verify long LTspice runs and investigate charger and touch limits
